DiodeDrop/MiniMu/MiniMu_V1.2_(NextPCB)/Mini Mu V1.2 BOM.xlsx

Reference | Value | Footprint | Qty | DNP | LCSC Part | MPN
C2,C3,C4,C10,C67,C68,C69,C70,C71,C72,C73,C74,C85,C87,C93,C106,C107,C108,C109,C114,C115,C116,C117,C118,C119,C126,C127,C131 | 100n/16V | Capacitor_SMD:C_0402_1005Metric | 28 |  | C76698 | CGA2B1X7R1C104KT0Y0F
C5,C7,C8,C9,C84,C98,C99,C120,C121,C122,C123,C124,C128,C129,C130 | 10u/10V | Capacitor_SMD:C_0402_1005Metric | 15 |  | C5252392 | V106M0402X5R100NCT
C6,C83,C89,C125 | 1u/10V | Capacitor_SMD:C_0402_1005Metric | 4 |  | C7503520 | CGA0402X5R105K100GT
C12,C15,C18,C21,C32,C47,C138 | 10u/50V | Capacitor_SMD:C_0805_2012Metric | 7 |  | C440198 | GRM21BR61H106KE43L
C16,C17,C25,C26,C36,C37 | 100u/10V | Capacitor_Tantalum_SMD:CP_EIA-3216-18_Kemet-A | 6 |  | C313517 | TLJA107M010R1400
C64 | 4u7/25V | Capacitor_SMD:C_0603_1608Metric | 1 |  | C20539423 | TCC0603X5R475M250CT
C79,C80,C81,C82,C94,C95,C97 | 2u2/10V | Capacitor_SMD:C_0402_1005Metric | 7 |  | C6119769 | CGA0402X5R225K100GT
C90,C91 | 18p/50V | Capacitor_SMD:C_0402_1005Metric | 2 |  | C5137554 | FCC0402N180J500AT
C104 | 22u/10V | Capacitor_SMD:C_0402_1005Metric | 1 |  | C22367823 | HGC0402R5226M100NTEJ
C110,C111,C112,C113 | 22u/35V | Capacitor_SMD:C_0805_2012Metric | 4 |  | C22367832 | HGC0805R5226M350NSLJ
D3,D6 | SS1045 | Diode_SMD:D_SMB | 2 |  | C19273147 | SS1045
D4,D5,D7 | XL-3216SURC | LED_SMD:LED_1206_3216Metric | 3 |  | C965822 | XL-3216SURC
D9,D10,D11,D13,D14,D16,D17,D18,D19,D20,D21 | PESD5V0S1BB-ES | Diode_SMD:D_SOD-523 | 11 |  | C5199184 | PESD5V0S1BB-ES
D12,D15,D22 | 1N5819WS | Diode_SMD:D_SOD-323 | 3 |  | C2939001 | 1N5819WS
FB1,FB2,FB3 | 30R | Inductor_SMD:L_0603_1608Metric | 3 |  | C17305 | BLM18PG300SN1D
J3 | USB-303WSD-BRY | easyeda2kicad:USB-A-TH_XUNPU_USB-303WSD-BRY | 1 |  | C2895028 | USB-303WSD-BRY
J4 | JXD0-0101NL | easyeda2kicad:RJ45-TH_JXD0-0101NL | 1 |  | N/A | JXD0-0101NL
J8 | PJ-3043-G | easyeda2kicad:AUDIO-TH_XKB_PJ-3043-R | 1 |  | C2884996 | PJ-3043-G
J9 | PJ-3043-R | easyeda2kicad:AUDIO-TH_XKB_PJ-3043-R | 1 |  | C2884997 | PJ-3043-R
L1,L4 | FXL0630-3R3-M | Inductor_SMD:L_Changjiang_FXL0630 | 2 |  | C167219 | FXL0630-3R3-M
L2 | 470nH | Inductor_SMD:L_0603_1608Metric | 1 |  | C695609 | TFM160808ALC-R47MTAA
MP1,MP2 | SMTSO2025CTJ | MountingHole:MountingHole_3.7mm_Pad_TopOnly | 2 |  | C2916321 | SMTSO2025CTJ
MP3,MP7 | SMTSO2015CTJ | MountingHole:MountingHole_3.7mm_Pad_TopOnly | 2 |  | C2916320 | SMTSO2015CTJ
R10 | 39K2 | Resistor_SMD:R_0603_1608Metric | 1 |  | C23037 | 0603WAF3922T5E
SW2 | TPB01-107L1S-RF | easyeda2kicad:SW-TH_L13.4-W7.7_TPB01-107L1S-RF | 1 |  | C2762119 | TPB01-107L1S-RF
U1 | ALC269Q-VB6-CG | Package_DFN_QFN:QFN-48-1EP_6x6mm_P0.4mm_EP4.2x4.2mm | 1 |  | N/A | ALC269Q-VB6-CG
U3,U6 | TPS54560BDDA | Package_SO:Texas_R-PDSO-G8_EP2.95x4.9mm_Mask2.4x3.1mm | 2 |  | C1850354 | TPS54560BDDA
U4,U5,U13,U14,U15,U18,U19,U20,U22,U23,U24,U25 | RCLAMP0524P | easyeda2kicad:RCLAMP0524P | 12 |  | C19829566 | RCLAMP0524P
U9 | AP2172AMP | Package_SO:MSOP-8-1EP_3x3mm_P0.65mm_EP1.95x2.15mm | 1 |  | C460656 | AP2172AMP
U11,U12,U21 | AP2152AMP | Package_SO:MSOP-8-1EP_3x3mm_P0.65mm_EP1.95x2.15mm | 3 |  | C2150126 | AP2152AMP
U16 | RTL8125BG-CG | Package_DFN_QFN:QFN-48-1EP_6x6mm_P0.4mm_EP4.3x4.3mm | 1 |  | C3013605 | RTL8125BG-CG
U17 | TPS628301ADRL | Package_TO_SOT_SMD:SOT-583-8 | 1 |  | C22445517 | TPS628301ADRL
U26 | MAX16052AUT+T | Package_TO_SOT_SMD:TSOT-23-6 | 1 |  | C143366 | MAX16052AUT+T
X1 | ADDR0207-P001A | easyeda2kicad:DIMM-SMD_ADDR0205-P001A | 1 |  | C962120 | ADDR0205-P001A
X2 | AS0BC21-S30BM-7H | easyeda2kicad:CONN-SMD_AS0BC21-S30BM-7H | 1 |  | C2832351 | AS0BC21-S30BM-7H
X3 | AS0BC21-S30BE-7H | easyeda2kicad:CONN-SMD_AS0BC21-S30BE-7H | 1 |  | C3020019 | AS0BC21-S30BE-7H
X4 | Conn_02x06_Odd_Even | Connector_PinHeader_2.54mm:PinHeader_2x06_P2.54mm_Vertical_SMD | 1 |  | C32713286 | HX PZ2.54-2x6P TP
X6 | Conn_02x06_Odd_Even | Connector_PinSocket_2.54mm:PinSocket_2x06_P2.54mm_Vertical_SMD | 1 |  | C22373947 | HC-PM254-8.5H-2x6PS
BT1 | CR1220-2 | easyeda2kicad:BAT-SMD_CR1220-2 | 1 |  | C70381 | CR1220-2
C1,C11,C13,C14,C22,C27,C28,C29,C30,C33,C40,C41,C44,C45,C50,C52,C54,C75,C102,C103,C134,C136,C139,C144,C145,C146,C147,C148 | 100n/50V | Capacitor_SMD:C_0603_1608Metric | 28 |  | C282519 | TCC0603X7R104K500CT
C19 | 910p/50V | Capacitor_SMD:C_0603_1608Metric | 1 |  | C3037659 | 0603CG911J500NT
C20 | 2n2/50V | Capacitor_SMD:C_0603_1608Metric | 1 |  | C779970 | 06035C222K4T2A
C23,C24 | 16p/50V | Capacitor_SMD:C_0603_1608Metric | 2 |  | C5360788 | TCC0603COG160J500CT
C31,C34,C35,C38,C39,C42,C43,C46 | 47u/10V | Capacitor_SMD:C_1206_3216Metric | 8 |  | C5448950 | TCC1206X5R476M100HT
C48,C65,C76,C105,C137 | 1u/50V | Capacitor_SMD:C_0603_1608Metric | 5 |  | C157684 | 0603X105K500NT
C49,C63,C100,C101,C132,C142,C143 | 10u/10V | Capacitor_SMD:C_0603_1608Metric | 7 |  | C19702 | CL10A106KP8NNNC
C51,C53,C55,C56,C57,C58,C59,C60,C61,C62,C77,C78,C86,C88,C92,C96,C140,C141 | 220n/16V | Capacitor_SMD:C_0402_1005Metric | 18 |  | C152777 | 0402X224K160CT
C66 | 27p/50V | Capacitor_SMD:C_0603_1608Metric | 1 |  | C302064 | 0603N270J500CT
C135 | 27n/50V | Capacitor_SMD:C_0603_1608Metric | 1 |  | C107086 | CC0603KRX7R9BB273
D1 | ESDA25L | Package_TO_SOT_SMD:SOT-23-3 | 1 |  | C95343 | ESDA25L
D2 | SD24 | easyeda2kicad:SOD-323_L1.8-W1.3-LS2.6-FD | 1 |  | C502530 | SD24
F1 | 0603L005/6AR | Fuse:Fuse_0603_1608Metric | 1 |  | C7472508 | 0603L005/6AR
J1 | HYC16-DP20-178 | easyeda2kicad:DP-SMD_HYC16-DP20-178 | 1 |  | C711350 | HYC16-DP20-178
J2 | HDMI-001S | easyeda2kicad:HDMI-SMD_HDMI-001S | 1 |  | C720616 | HDMI-001S
J5,J6 | AF SS-JB17.6 | easyeda2kicad:USB-A-TH_AF-SS-JB17.6 | 2 |  | C456021 | AF SS-JB17.6
J7 | GT-USB-7010ASV | Connector_USB:USB_C_Receptacle_G-Switch_GT-USB-7010ASV | 1 |  | C2988369 | GT-USB-7010ASV
J10 | Conn_01x03 | Connector_PinHeader_2.00mm:PinHeader_1x03_P2.00mm_Vertical | 1 |  | C706996 | X4611WV-03I-C40D28
Q1,Q8,Q13 | AO3400A | Package_TO_SOT_SMD:SOT-23 | 3 |  | C5380685 | AO3400A
Q2 | IRF7240TRPBF | Package_SO:SOIC-8_3.9x4.9mm_P1.27mm | 1 |  | C18190856 | IRF7240TRPBF
Q3 | TMG60N04NF | easyeda2kicad:PDFN-8_L5.8-W4.9-P1.27-LS6.1-BL-A | 1 |  | C7422899 | TMG60N04NF
Q4,Q5,Q6,Q7 | SI1902CDL | Package_TO_SOT_SMD:SOT-363_SC-70-6 | 4 |  | C466988 | SI1902CDL
R1,R23,R26,R31,R32,R39,R40,R49,R80,R81,R94 | 100K | Resistor_SMD:R_0603_1608Metric | 11 |  | C25803 | 0603WAF1003T5E
R2,R4,R5,R35,R41,R46,R47,R48,R50,R82 | 10K | Resistor_SMD:R_0603_1608Metric | 10 |  | C25804 | 0603WAF1002T5E
R3 | 22R | Resistor_SMD:R_0603_1608Metric | 1 |  | C23345 | 0603WAF220JT5E
R11,R44,R65 | 20K | Resistor_SMD:R_0603_1608Metric | 3 |  | C4184 | 0603WAF2002T5E
R12,R18,R20,R64,R72,R95 | 1Meg | Resistor_SMD:R_0603_1608Metric | 6 |  | C22935 | 0603WAF1004T5E
R13,R27 | 47K | Resistor_SMD:R_0603_1608Metric | 2 |  | C25819 | 0603WAF4702T5E
R14,R38 | 5K1 | Resistor_SMD:R_0603_1608Metric | 2 |  | C23186 | 0603WAF5101T5E
R15 | 24K | Resistor_SMD:R_0603_1608Metric | 1 |  | C23352 | 0603WAF2402T5E
R16,R28,R89 | 15K | Resistor_SMD:R_0603_1608Metric | 3 |  | C22809 | 0603WAF1502T5E
R17,R36,R84 | 100R | Resistor_SMD:R_0603_1608Metric | 3 |  | C22775 | 0603WAF1000T5E
R19,R22,R75,R77,R78,R79 | 0R | Resistor_SMD:R_0603_1608Metric | 6 |  | C21189 | 0603WAF0000T5E
R21,R24,R25 | 100K | Resistor_SMD:R_0402_1005Metric | 3 |  | C25741 | 0402WGF1003TCE
R29 | 180K | Resistor_SMD:R_0603_1608Metric | 1 |  | C22827 | 0603WAF2003T5E
R30 | 200K | Resistor_SMD:R_0603_1608Metric | 1 |  | C25811 | 0603WAF2003T5E
R33 | 68K | Resistor_SMD:R_0603_1608Metric | 1 |  | C23231 | 0603WAF6802T5E
R34 | 13K | Resistor_SMD:R_0603_1608Metric | 1 |  | C22797 | 0603WAF1302T5E
R37,R66,R73,R90,R91 | 1K | Resistor_SMD:R_0603_1608Metric | 5 |  | C21190 | 0603WAF1001T5E
R42,R52,R108,R117 | 130R | Resistor_SMD:R_0603_1608Metric | 4 |  | C22796 | 0603WAF1300T5E
R45,R51 | 75R | Resistor_SMD:R_0603_1608Metric | 2 |  | C4275 | 0603WAF750JT5E
R53,R60,R63,R67,R68,R86,R92,R93 | 2K2 | Resistor_SMD:R_0603_1608Metric | 8 |  | C4190 | 0603WAF2201T5E
R54,R55,R56,R57,R58,R59,R61,R62 | 470R | Resistor_SMD:R_0402_1005Metric | 8 |  | C25117 | 0402WGF4700TCE
R69,R70 | 330R | Resistor_SMD:R_0603_1608Metric | 2 |  | C23138 | 0603WAF3300T5E
R71 | 2K49 | Resistor_SMD:R_0603_1608Metric | 1 |  | C22908 | 0603WAF2491T5E
R74,R76,R85,R87 | 4K7 | Resistor_SMD:R_0603_1608Metric | 4 |  | C23162 | 0603WAF4701T5E
R83 | 27K | Resistor_SMD:R_0603_1608Metric | 1 |  | C22967 | 0603WAF2702T5E
R88 | 4K3 | Resistor_SMD:R_0603_1608Metric | 1 |  | C23159 | 0603WAF4301T5E
TH1 | FNTC0603X103F3950FB | Resistor_SMD:R_0603_1608Metric | 1 |  | C41417298 | FNTC0603X103F3950FB
U7 | HT7533 | Package_TO_SOT_SMD:SOT-89-3 | 1 |  | C5296738 | HT7533
U8 | PIC16F18313-I/SN | Package_SO:SOIC-8_3.9x4.9mm_P1.27mm | 1 |  | C510911 | PIC16F18313-I/SN
U10 | 74AHC1G14GW | Package_TO_SOT_SMD:SOT-353_SC-70-5 | 1 |  | C19829643 | 74AHC1G14GW
U27 | IP2721 | Package_SO:TSSOP-16_4.4x5mm_P0.65mm | 1 |  | C603176 | IP2721
X5 | B4B-PH-K-S | Connector_JST:JST_PH_B4B-PH-K_1x04_P2.00mm_Vertical | 1 |  | C131334 | B4B-PH-K-S
Y1 | SX3B25.000F1010G30 | Crystal:Crystal_SMD_3225-4Pin_3.2x2.5mm | 1 |  | C7302033 | SX3B25.000F1010G30
Y2 | SX3M1.000M20F30TNN | Oscillator:Oscillator_SMD_EuroQuartz_XO32-4Pin_3.2x2.5mm | 1 |  | C2901547 | SX3M1.000M20F30TNN
