DiodeDrop/MiniMu/DrillTemplate/Drill Template PCB.pdf

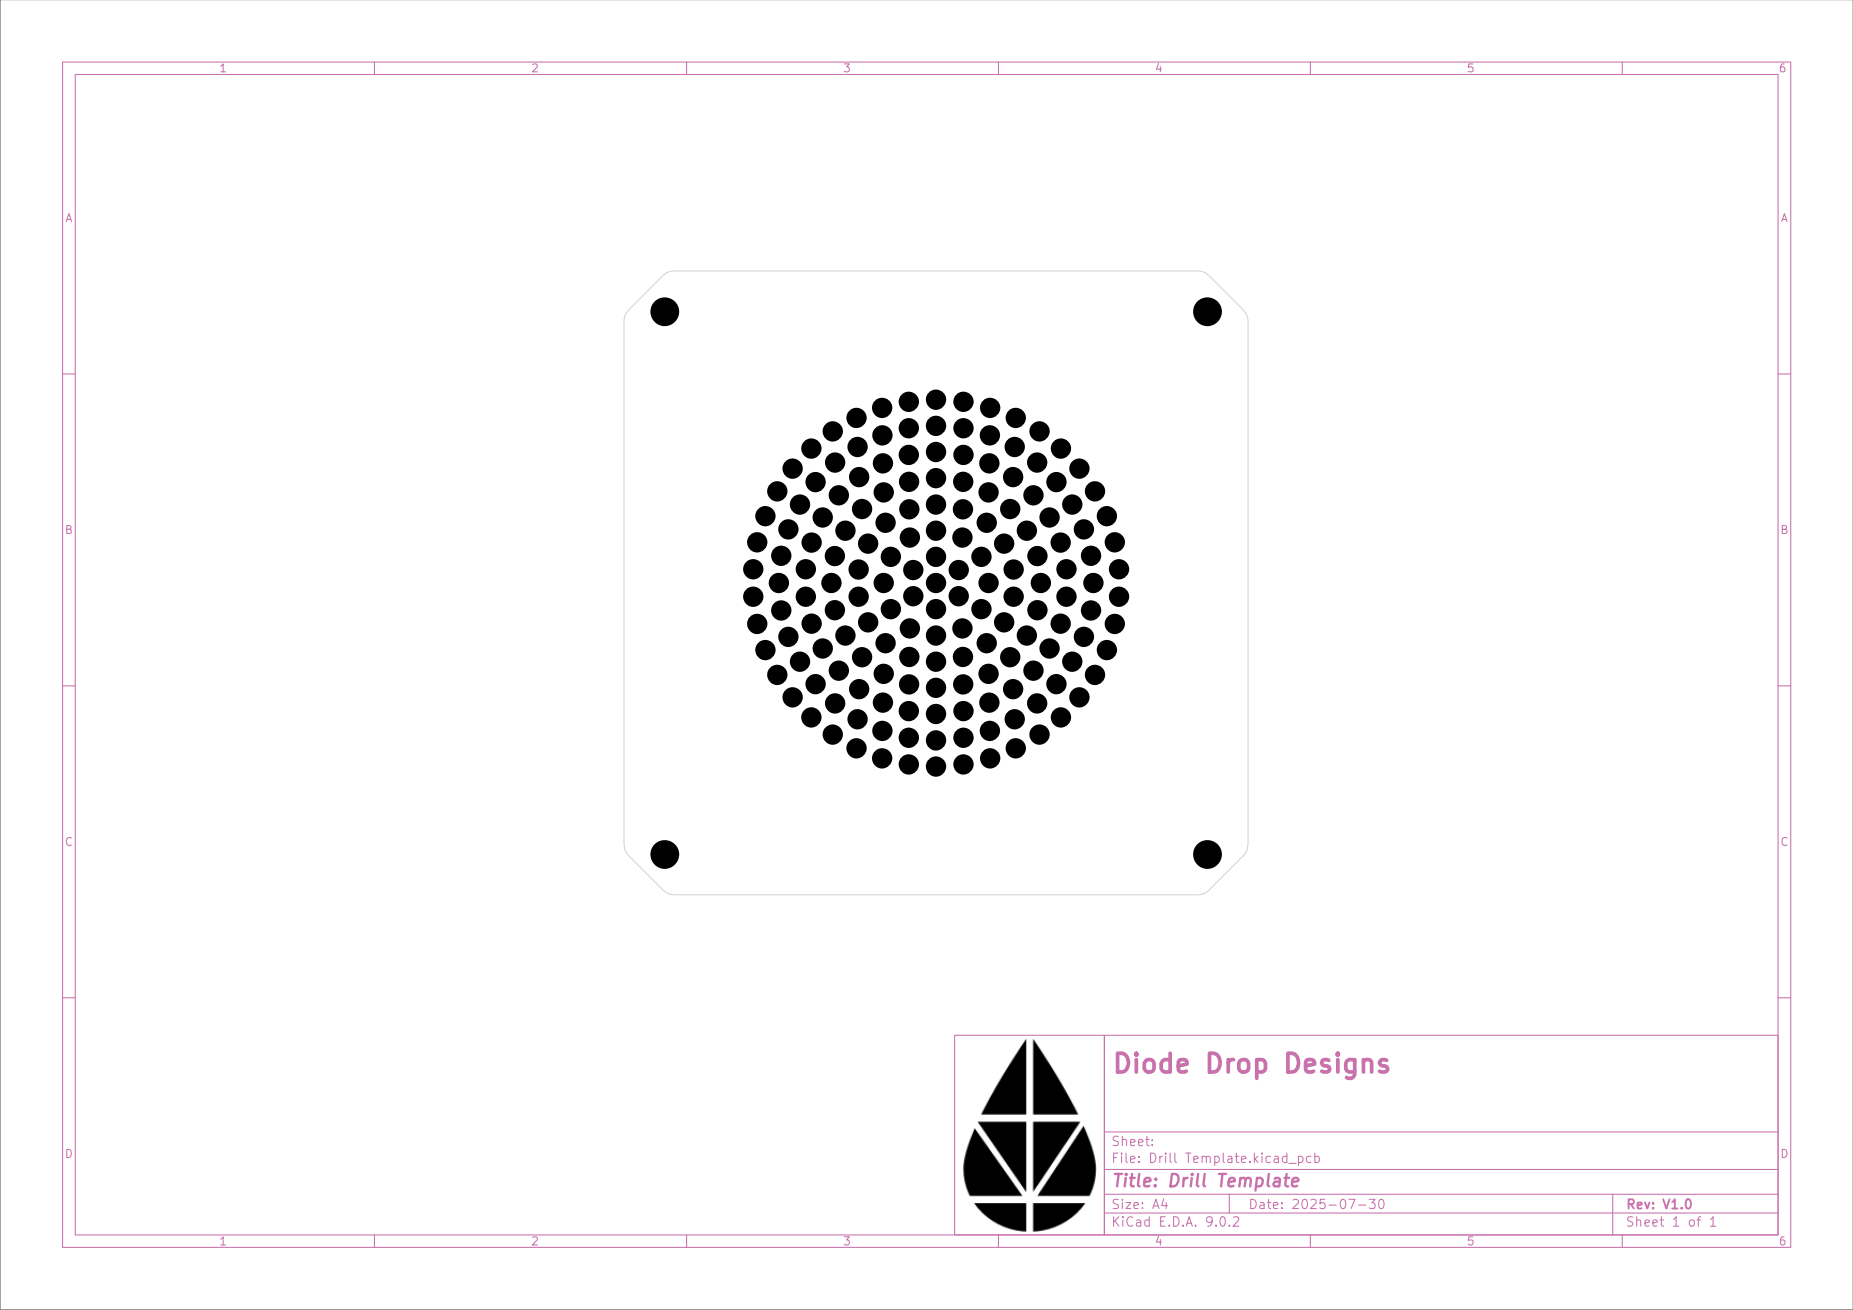
[picture p22: page 1]
