DiodeDrop/MiniMu/MiniMu_V1.2_(NextPCB)/Buttons.kicad_sch

## KiCad design MiniMu_V1.2_(NextPCB)/Buttons.kicad_sch (2025-07-30)

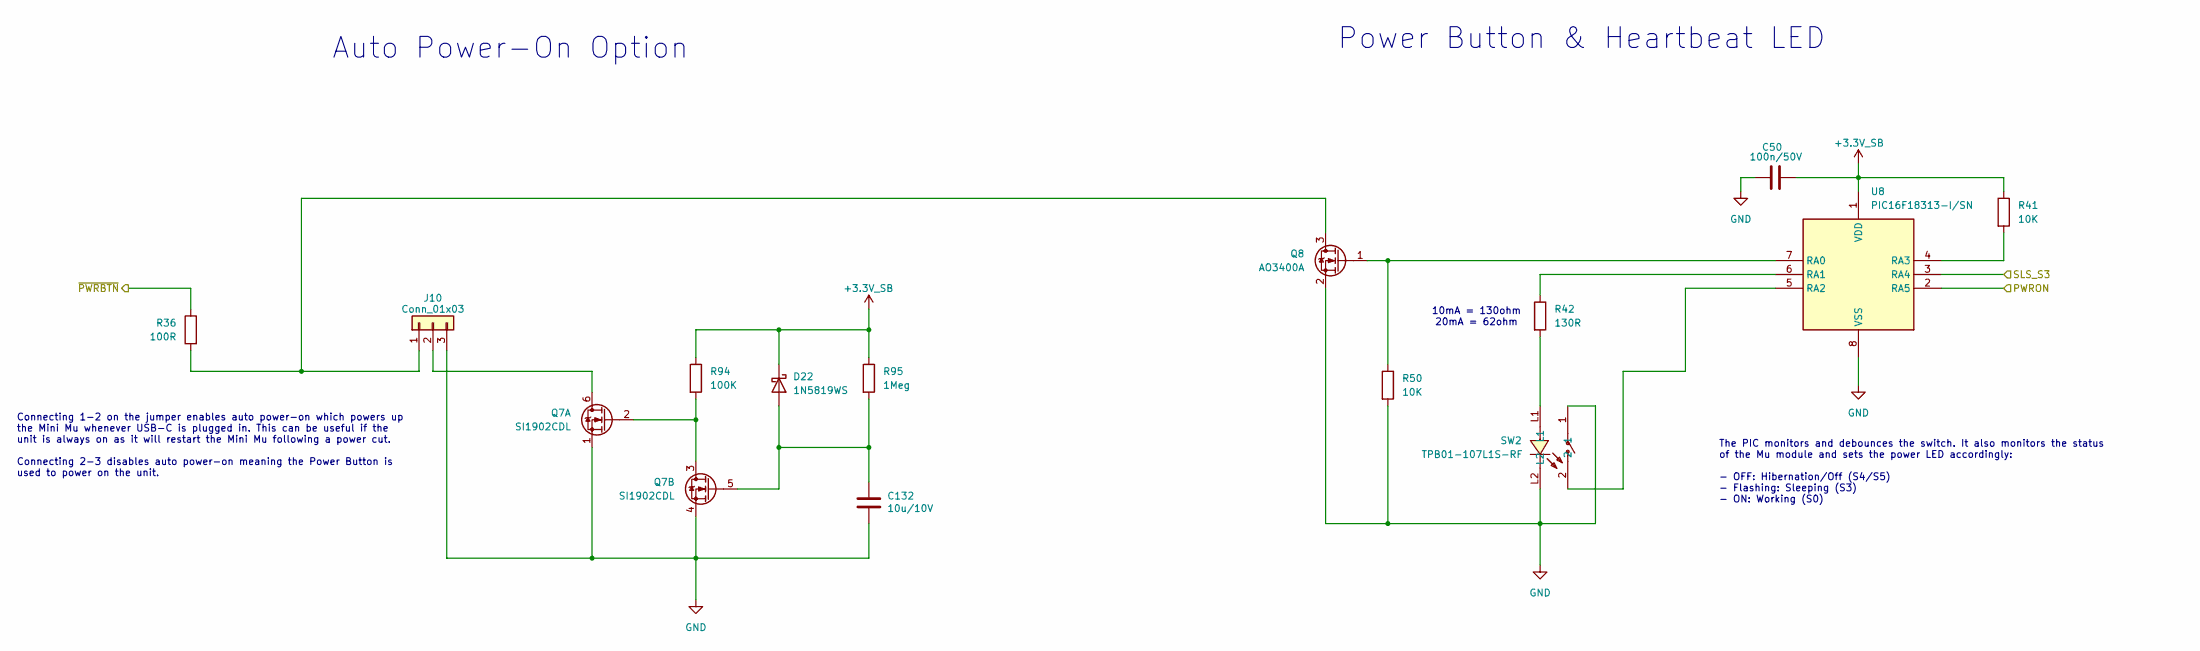
[picture p23: schematic Buttons.kicad_sch]

Parts:
C50: 100n/50V; C_0603_1608Metric; LCSC Part C282519
C132: 10u/10V; C_0603_1608Metric; LCSC Part C19702
D22: 1N5819WS; D_SOD-323; MPN 1N5819WS; LCSC Part C2939001
J10: Conn_01x03; PinHeader_1x03_P2.00mm_Vertical; MPN X4611WV-03I-C40D28; LCSC Part C706996
Q7: SI1902CDL; SOT-363_SC-70-6; MPN SI1902CDL; LCSC Part C466988
Q8: AO3400A; SOT-23; MPN AO3400A; LCSC Part C5380685
R36: 100R; R_0603_1608Metric; MPN 0603WAF1000T5E; LCSC Part C22775
R41, R50: 10K; R_0603_1608Metric; MPN 0603WAF1002T5E; LCSC Part C25804
R42: 130R; R_0603_1608Metric; MPN 0603WAF1300T5E; LCSC Part C22796
R94: 100K; R_0603_1608Metric; MPN 0603WAF1003T5E; LCSC Part C25803
R95: 1Meg; R_0603_1608Metric; MPN 0603WAF1004T5E; LCSC Part C22935
SW2: TPB01-107L1S-RF; SW-TH_L13.4-W7.7_TPB01-107L1S-RF; MPN TPB01-107L1S-RF; LCSC Part C2762119
U8: PIC16F18313-I/SN; SOIC-8_3.9x4.9mm_P1.27mm; MPN PIC16F18313-I/SN; LCSC Part C510911

Connections:
+3.3V_SB: C50.1, D22.1 (K), R41.1, R94.1, R95.1, U8.1 (VDD)
GND: C50.2, C132.2, J10.3, Q7.1 (S), Q7.4 (S), Q8.2 (S), R50.2, SW2.1, SW2.L2, U8.8 (VSS)
unnamed: C132.1, D22.2 (A), Q7.5 (G), R95.2
unnamed: J10.1, Q8.3 (D), R36.2
unnamed: J10.2, Q7.6 (D)
unnamed: Q7.2 (G), Q7.3 (D), R94.2
unnamed: Q8.1 (G), R50.1, U8.7 (RA0)
unnamed: R41.2, U8.4 (RA3)
unnamed: R42.1, U8.6 (RA1)
unnamed: R42.2, SW2.L1
unnamed: SW2.2, U8.5 (RA2)
PWRON: U8.2 (RA5)
SLS_S3: U8.3 (RA4)
~PWRBTN: R36.1

Notes on the sheet:
Power Button & Heartbeat LED
10mA = 130ohm 20mA = 62ohm
Auto Power-On Option
Connecting 1-2 on the jumper enables auto power-on which powers up the Mini Mu whenever USB-C is plugged in. This can be useful if the unit is always on as it will restart the Mini Mu following a power cut. Connecting 2-3 disables auto power-on meaning the Power Button is used to power on the unit.
The PIC monitors and debounces the switch. It also monitors the status of the Mu module and sets the power LED accordingly: - OFF: Hibernation/Off (S4/S5) - Flashing: Sleeping (S3) - ON: Working (S0)
