DiodeDrop/MiniMu/MiniMu_V1.2_(NextPCB)/Displayport.kicad_sch

## KiCad design MiniMu_V1.2_(NextPCB)/Displayport.kicad_sch (2025-07-30)

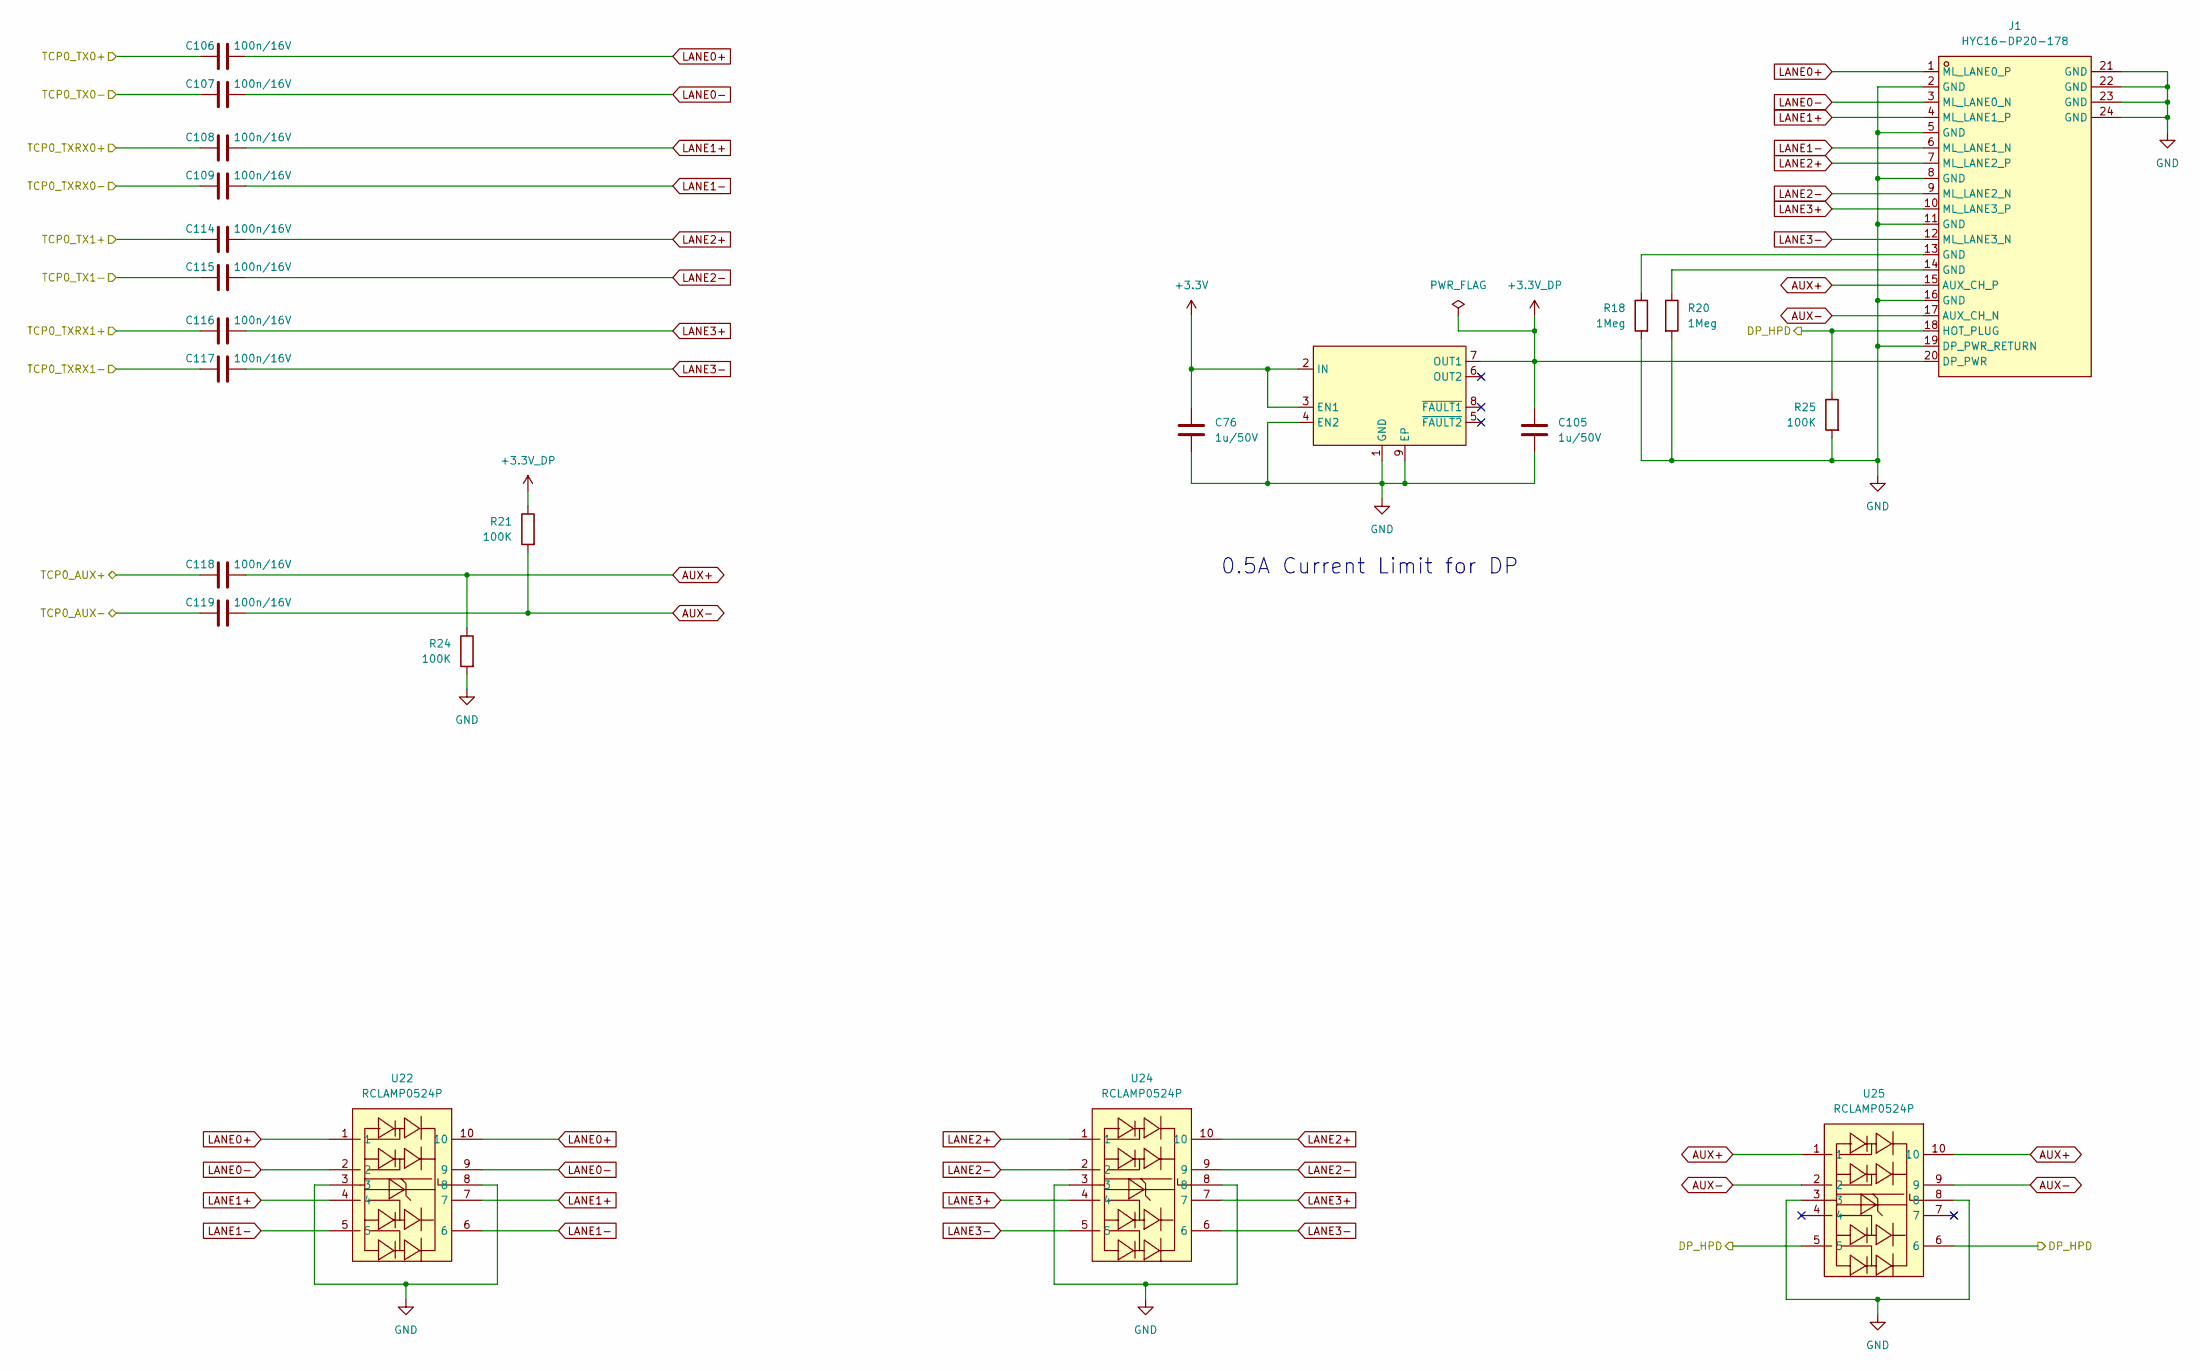
[picture p24: schematic Displayport.kicad_sch]

Parts:
C76, C105: 1u/50V; C_0603_1608Metric; LCSC Part C157684
C106, C107, C108, C109, C114, C115, C116, C117, C118, C119: 100n/16V; C_0402_1005Metric; LCSC Part C76698
J1: HYC16-DP20-178; DP-SMD_HYC16-DP20-178; MPN HYC16-DP20-178; LCSC Part C711350
R18, R20: 1Meg; R_0603_1608Metric; MPN 0603WAF1004T5E; LCSC Part C22935
R21, R24, R25: 100K; R_0402_1005Metric; MPN 0402WGF1003TCE; LCSC Part C25741
U21: AP2152AMP; MSOP-8-1EP_3x3mm_P0.65mm_EP1.95x2.15mm; MPN AP2152AMP; LCSC Part C2150126
U22, U24, U25: RCLAMP0524P; MPN RCLAMP0524P; LCSC Part C19829566

Connections:
+3.3V: C76.1, U21.2 (IN), U21.3 (EN1)
+3.3V_DP: C105.1, J1.20 (DP_PWR), R21.1, U21.7 (OUT1)
AUX+: C118.2, J1.15 (AUX_CH_P), R24.1, U25.1, U25.10
AUX-: C119.2, J1.17 (AUX_CH_N), R21.2, U25.2, U25.9
DP_HPD: J1.18 (HOT_PLUG), R25.1, U25.5, U25.6
GND: C76.2, C105.2, J1.2 (GND), J1.5 (GND), J1.8 (GND), J1.11 (GND), J1.16 (GND), J1.19 (DP_PWR_RETURN), J1.21 (GND), J1.22 (GND), J1.23 (GND), J1.24 (GND), R18.2, R20.2, R24.2, R25.2, U21.1 (GND), U21.4 (EN2), U21.9 (EP), U22.3, U22.8, U24.3, U24.8, U25.3, U25.8
LANE0+: C106.2, J1.1 (ML_LANE0_P), U22.1, U22.10
LANE0-: C107.2, J1.3 (ML_LANE0_N), U22.2, U22.9
LANE1+: C108.2, J1.4 (ML_LANE1_P), U22.4, U22.7
LANE1-: C109.2, J1.6 (ML_LANE1_N), U22.5, U22.6
LANE2+: C114.2, J1.7 (ML_LANE2_P), U24.1, U24.10
LANE2-: C115.2, J1.9 (ML_LANE2_N), U24.2, U24.9
LANE3+: C116.2, J1.10 (ML_LANE3_P), U24.4, U24.7
LANE3-: C117.2, J1.12 (ML_LANE3_N), U24.5, U24.6
unnamed: J1.13 (GND), R18.1
unnamed: J1.14 (GND), R20.1
TCP0_AUX+: C118.1
TCP0_AUX-: C119.1
TCP0_TX0+: C106.1
TCP0_TX0-: C107.1
TCP0_TX1+: C114.1
TCP0_TX1-: C115.1
TCP0_TXRX0+: C108.1
TCP0_TXRX0-: C109.1
TCP0_TXRX1+: C116.1
TCP0_TXRX1-: C117.1

Notes on the sheet:
0.5A Current Limit for DP
