DiodeDrop/MiniMu/MiniMu_V1.2_(NextPCB)/Ethernet.kicad_sch

## KiCad design MiniMu_V1.2_(NextPCB)/Ethernet.kicad_sch (2025-07-30)

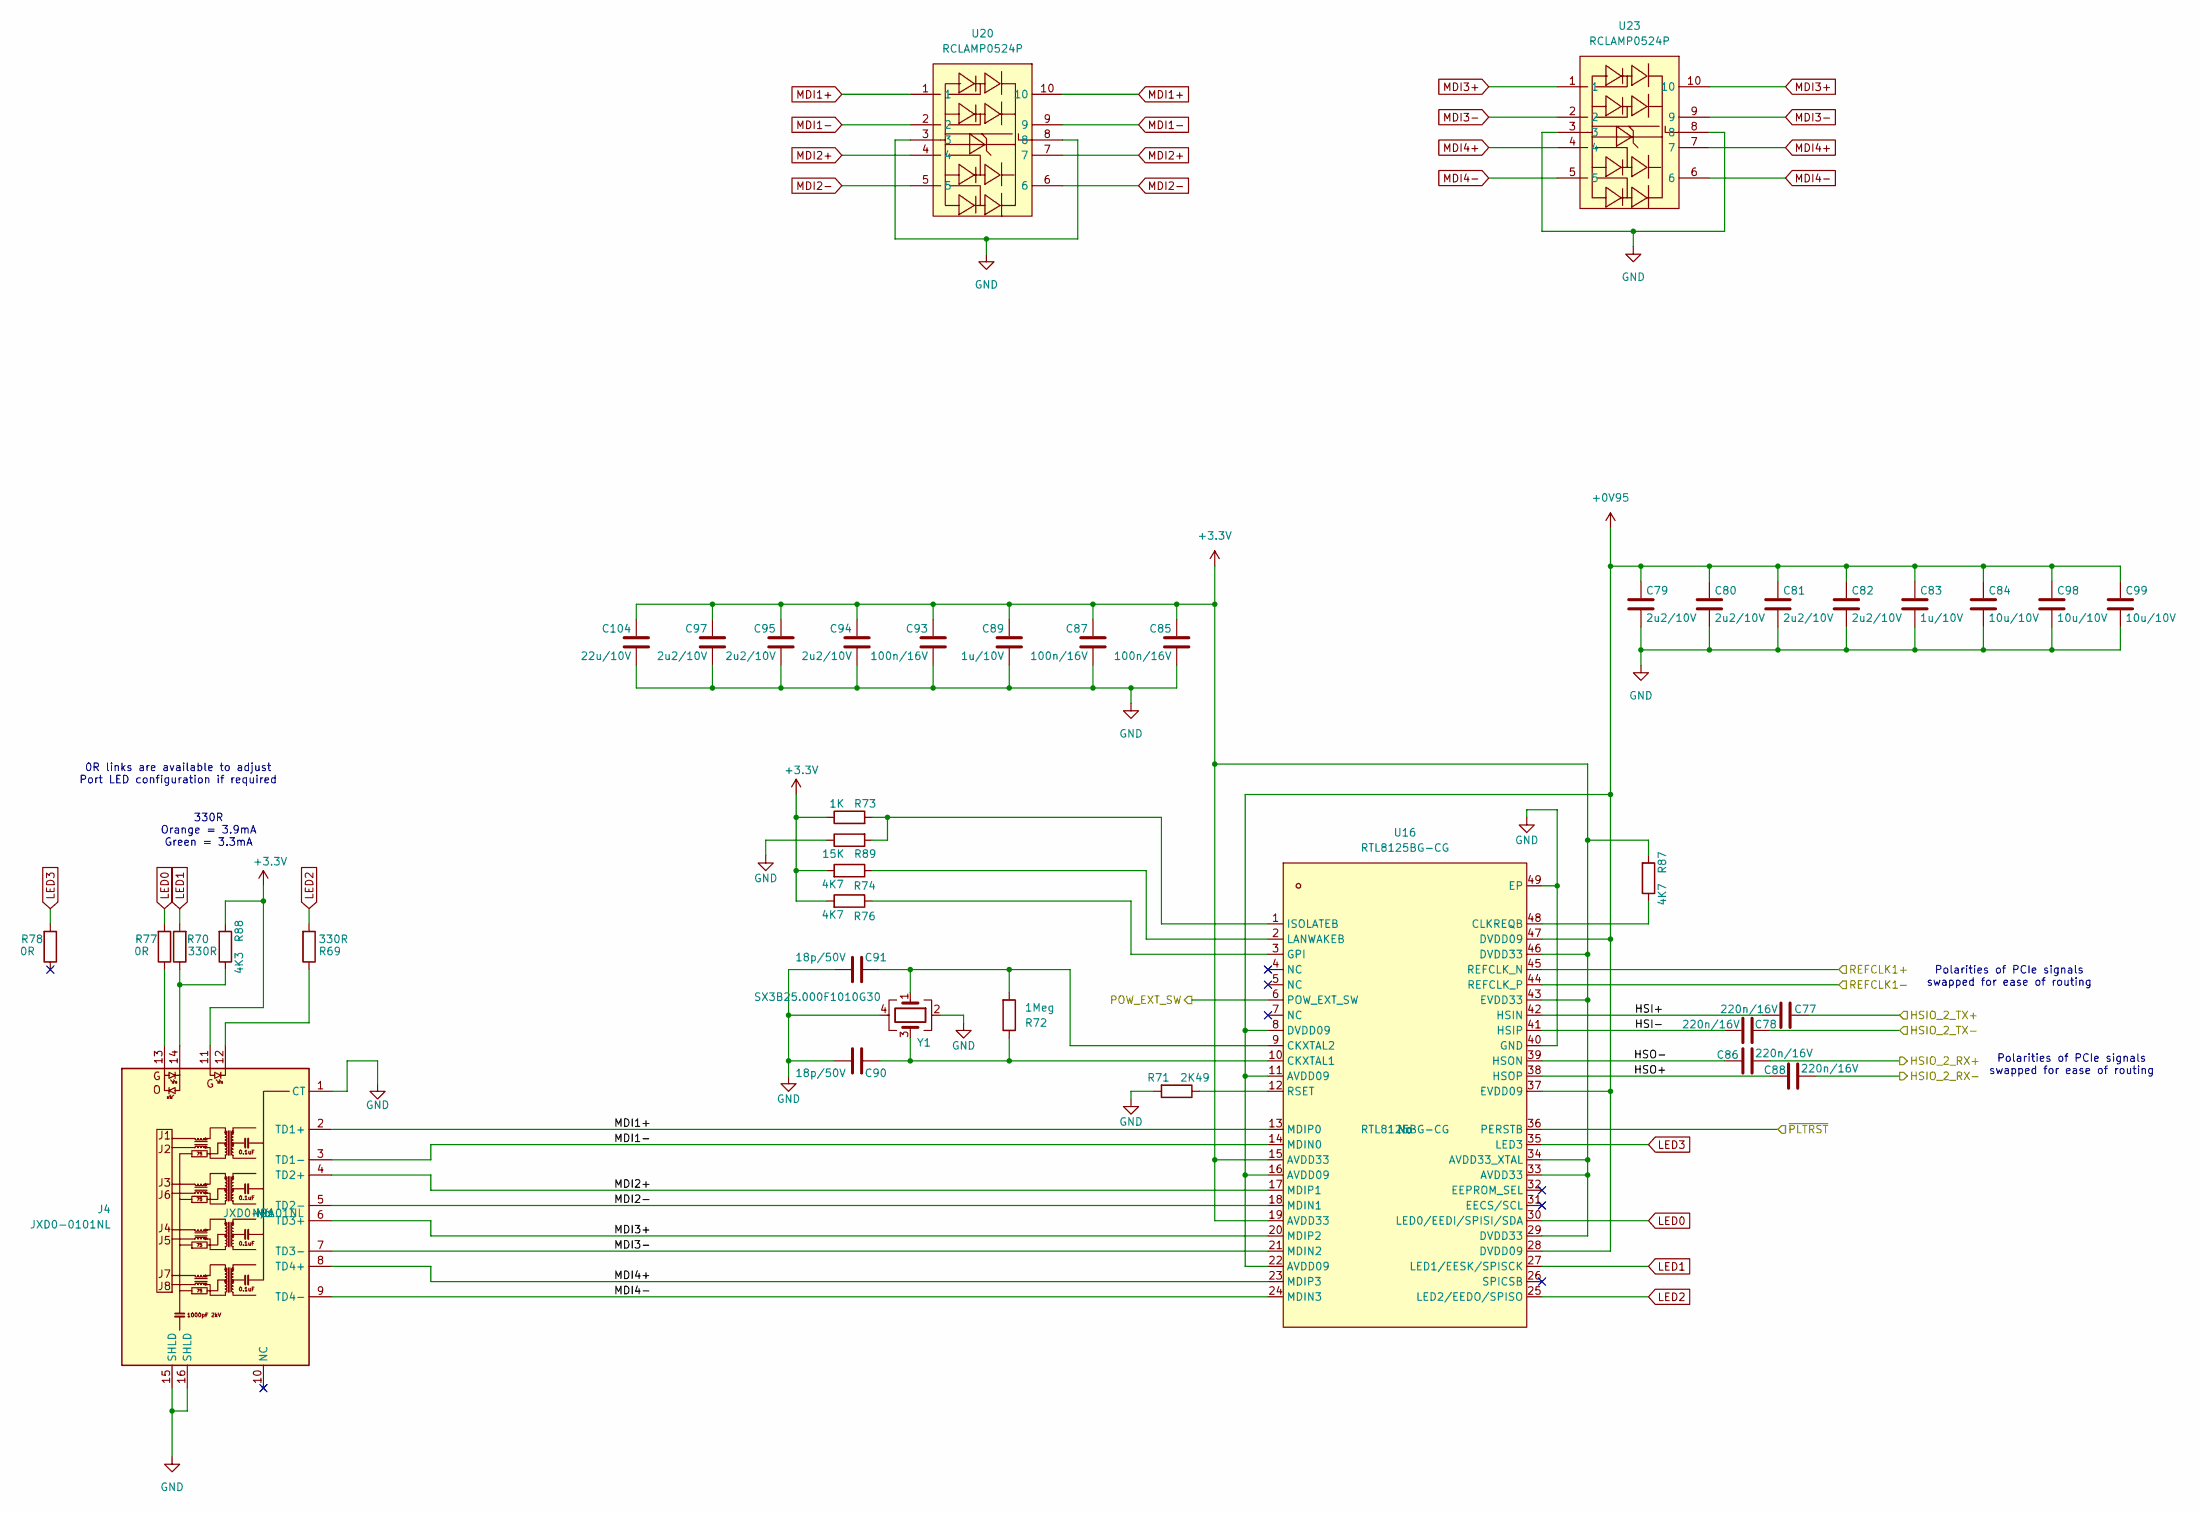
[picture p25: schematic Ethernet.kicad_sch]

Parts:
C77, C78, C86, C88: 220n/16V; C_0402_1005Metric; LCSC Part C152777
C79, C80, C81, C82, C94, C95, C97: 2u2/10V; C_0402_1005Metric; LCSC Part C6119769
C83, C89: 1u/10V; C_0402_1005Metric; LCSC Part C7503520
C84, C98, C99: 10u/10V; C_0402_1005Metric; LCSC Part C5252392
C85, C87, C93: 100n/16V; C_0402_1005Metric; LCSC Part C76698
C90, C91: 18p/50V; C_0402_1005Metric; LCSC Part C5137554
C104: 22u/10V; C_0402_1005Metric; LCSC Part C22367823
J4: JXD0-0101NL; RJ45-TH_JXD0-0101NL; MPN JXD0-0101NL; LCSC Part N/A
R69, R70: 330R; R_0603_1608Metric; MPN 0603WAF3300T5E; LCSC Part C23138
R71: 2K49; R_0603_1608Metric; MPN 0603WAF2491T5E; LCSC Part C22908
R72: 1Meg; R_0603_1608Metric; MPN 0603WAF1004T5E; LCSC Part C22935
R73: 1K; R_0603_1608Metric; MPN 0603WAF1001T5E; LCSC Part C21190
R74, R76, R87: 4K7; R_0603_1608Metric; MPN 0603WAF4701T5E; LCSC Part C23162
R77, R78: 0R; R_0603_1608Metric; MPN 0603WAF0000T5E; LCSC Part C21189
R88: 4K3; R_0603_1608Metric; MPN 0603WAF4301T5E; LCSC Part C23159
R89: 15K; R_0603_1608Metric; MPN 0603WAF1502T5E; LCSC Part C22809
U16: RTL8125BG-CG; QFN-48-1EP_6x6mm_P0.4mm_EP4.3x4.3mm; MPN RTL8125BG-CG; LCSC Part C3013605
U20, U23: RCLAMP0524P; MPN RCLAMP0524P; LCSC Part C19829566
Y1: SX3B25.000F1010G30; Crystal_SMD_3225-4Pin_3.2x2.5mm; MPN SX3B25.000F1010G30; LCSC Part C7302033

Connections:
+0V95: C79.2, C80.2, C81.2, C82.2, C83.2, C84.2, C98.2, C99.2, U16.8 (DVDD09), U16.11 (AVDD09), U16.16 (AVDD09), U16.22 (AVDD09), U16.28 (DVDD09), U16.37 (EVDD09), U16.47 (DVDD09)
+3.3V: C85.2, C87.2, C89.2, C93.2, C94.2, C95.2, C97.2, C104.2, J4.11, R73.1, R74.2, R76.2, R87.2, R88.2, U16.15 (AVDD33), U16.19 (AVDD33), U16.29 (DVDD33), U16.33 (AVDD33), U16.34 (AVDD33_XTAL), U16.43 (EVDD33), U16.46 (DVDD33)
GND: C79.1, C80.1, C81.1, C82.1, C83.1, C84.1, C85.1, C87.1, C89.1, C90.2, C91.2, C93.1, C94.1, C95.1, C97.1, C98.1, C99.1, C104.1, J4.1 (CT), J4.15 (SHLD), J4.16 (SHLD), R71.2, R89.1, U16.40 (GND), U16.49 (EP), U20.3, U20.8, U23.3, U23.8, Y1.2, Y1.4
HSI+: C77.2, U16.42 (HSIN)
HSI-: C78.2, U16.41 (HSIP)
HSIO_2_RX+: C86.2
HSIO_2_RX-: C88.2
HSIO_2_TX+: C77.1
HSIO_2_TX-: C78.1
HSO+: C88.1, U16.38 (HSOP)
HSO-: C86.1, U16.39 (HSON)
LED0: R77.2, U16.30 (LED0/EEDI/SPISI/SDA)
LED1: R70.2, U16.27 (LED1/EESK/SPISCK)
LED2: R69.2, U16.25 (LED2/EEDO/SPISO)
LED3: R78.2, U16.35 (LED3)
MDI1+: J4.2 (TD1+), U16.13 (MDIP0), U20.1, U20.10
MDI1-: J4.3 (TD1-), U16.14 (MDIN0), U20.2, U20.9
MDI2+: J4.4 (TD2+), U16.17 (MDIP1), U20.4, U20.7
MDI2-: J4.5 (TD2-), U16.18 (MDIN1), U20.5, U20.6
MDI3+: J4.6 (TD3+), U16.20 (MDIP2), U23.1, U23.10
MDI3-: J4.7 (TD3-), U16.21 (MDIN2), U23.2, U23.9
MDI4+: J4.8 (TD4+), U16.23 (MDIP3), U23.4, U23.7
MDI4-: J4.9 (TD4-), U16.24 (MDIN3), U23.5, U23.6
unnamed: C90.1, R72.1, U16.10 (CKXTAL1), Y1.3
unnamed: C91.1, R72.2, U16.9 (CKXTAL2), Y1.1
unnamed: J4.12, R69.1
unnamed: J4.13, R77.1
unnamed: J4.14, R70.1, R88.1
unnamed: R71.1, U16.12 (RSET)
unnamed: R73.2, R89.2, U16.1 (ISOLATEB)
unnamed: R74.1, U16.2 (LANWAKEB)
unnamed: R76.1, U16.3 (GPI)
unnamed: R87.1, U16.48 (CLKREQB)
POW_EXT_SW: U16.6 (POW_EXT_SW)
REFCLK1+: U16.45 (REFCLK_N)
REFCLK1-: U16.44 (REFCLK_P)
~PLTRST: U16.36 (PERSTB)

Notes on the sheet:
330R Orange = 3.9mA Green = 3.3mA
Polarities of PCIe signals swapped for ease of routing
0R links are available to adjust Port LED configuration if required
