DiodeDrop/MiniMu/MiniMu_V1.2_(NextPCB)/Fan_Temp.kicad_sch

## KiCad design MiniMu_V1.2_(NextPCB)/Fan_Temp.kicad_sch (2025-07-30)

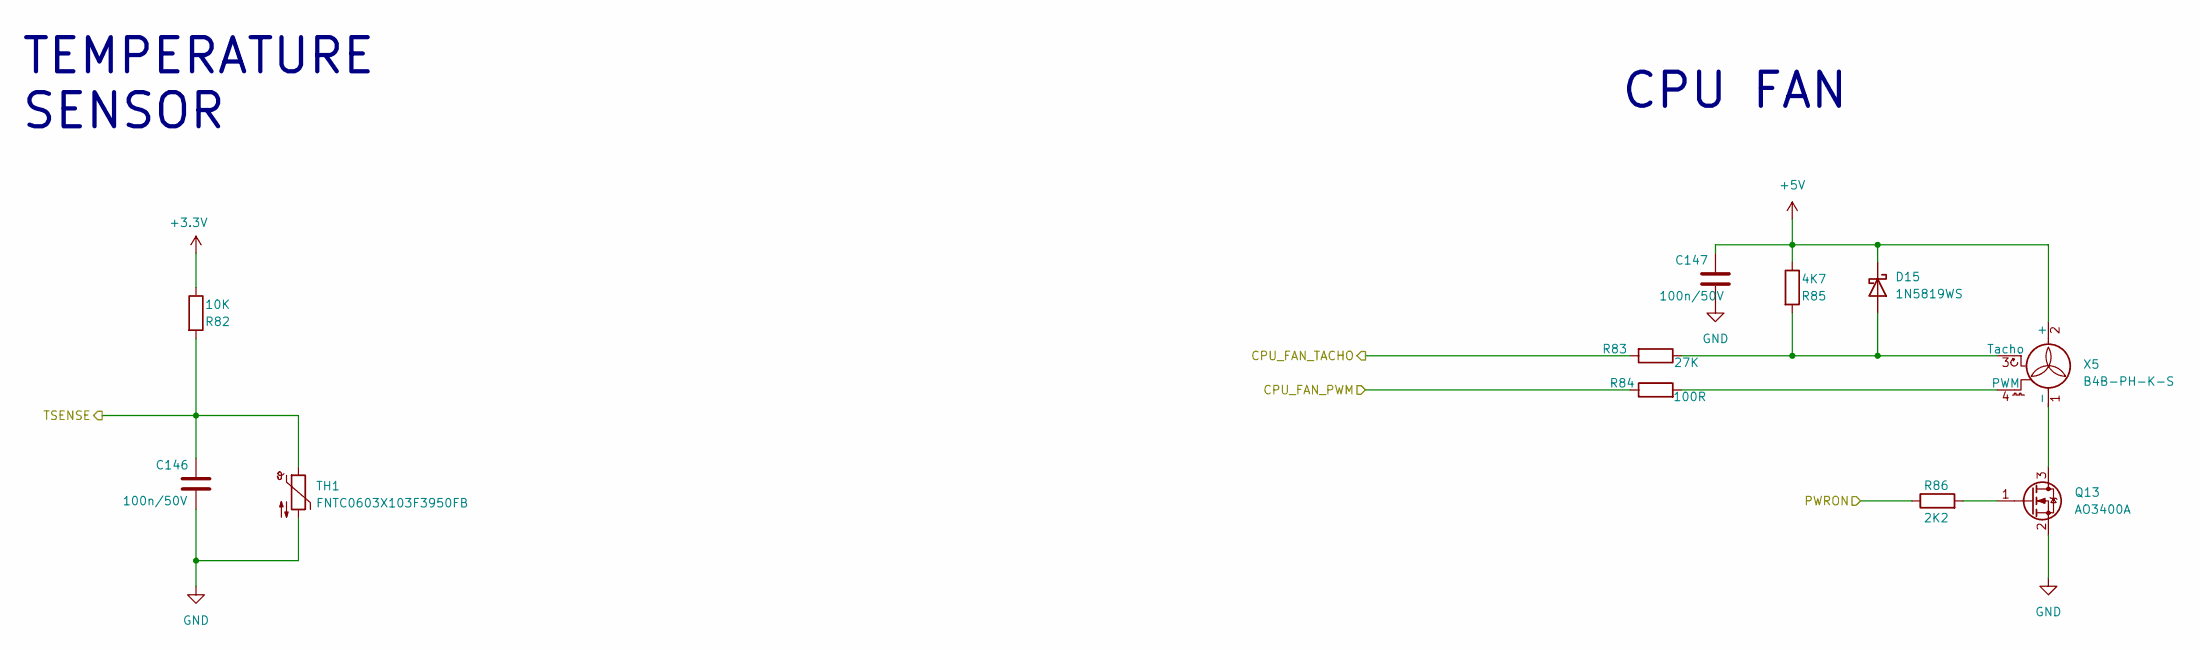
[picture p26: schematic Fan_Temp.kicad_sch]

Parts:
C146, C147: 100n/50V; C_0603_1608Metric; LCSC Part C282519
D15: 1N5819WS; D_SOD-323; MPN 1N5819WS; LCSC Part C2939001
Q13: AO3400A; SOT-23; MPN AO3400A; LCSC Part C5380685
R82: 10K; R_0603_1608Metric; MPN 0603WAF1002T5E; LCSC Part C25804
R83: 27K; R_0603_1608Metric; MPN 0603WAF2702T5E; LCSC Part C22967
R84: 100R; R_0603_1608Metric; MPN 0603WAF1000T5E; LCSC Part C22775
R85: 4K7; R_0603_1608Metric; MPN 0603WAF4701T5E; LCSC Part C23162
R86: 2K2; R_0603_1608Metric; MPN 0603WAF2201T5E; LCSC Part C4190
TH1: FNTC0603X103F3950FB; R_0603_1608Metric; MPN FNTC0603X103F3950FB; LCSC Part C41417298
X5: B4B-PH-K-S; JST_PH_B4B-PH-K_1x04_P2.00mm_Vertical; MPN B4B-PH-K-S; LCSC Part C131334

Connections:
+3.3V: R82.1
+5V: C147.1, D15.1 (K), R85.1, X5.2 (+)
CPU_FAN_PWM: R84.1
CPU_FAN_TACHO: R83.2
GND: C146.2, C147.2, Q13.2 (S), TH1.2
unnamed: D15.2 (A), R83.1, R85.2, X5.3 (Tacho)
unnamed: Q13.1 (G), R86.2
unnamed: Q13.3 (D), X5.1 (-)
unnamed: R84.2, X5.4 (PWM)
PWRON: R86.1
TSENSE: C146.1, R82.2, TH1.1

Notes on the sheet:
TEMPERATURE SENSOR
CPU FAN
