DiodeDrop/MiniMu/MiniMu_V1.2_(NextPCB)/Front_USB.kicad_sch

## KiCad design MiniMu_V1.2_(NextPCB)/Front_USB.kicad_sch (2025-07-30)

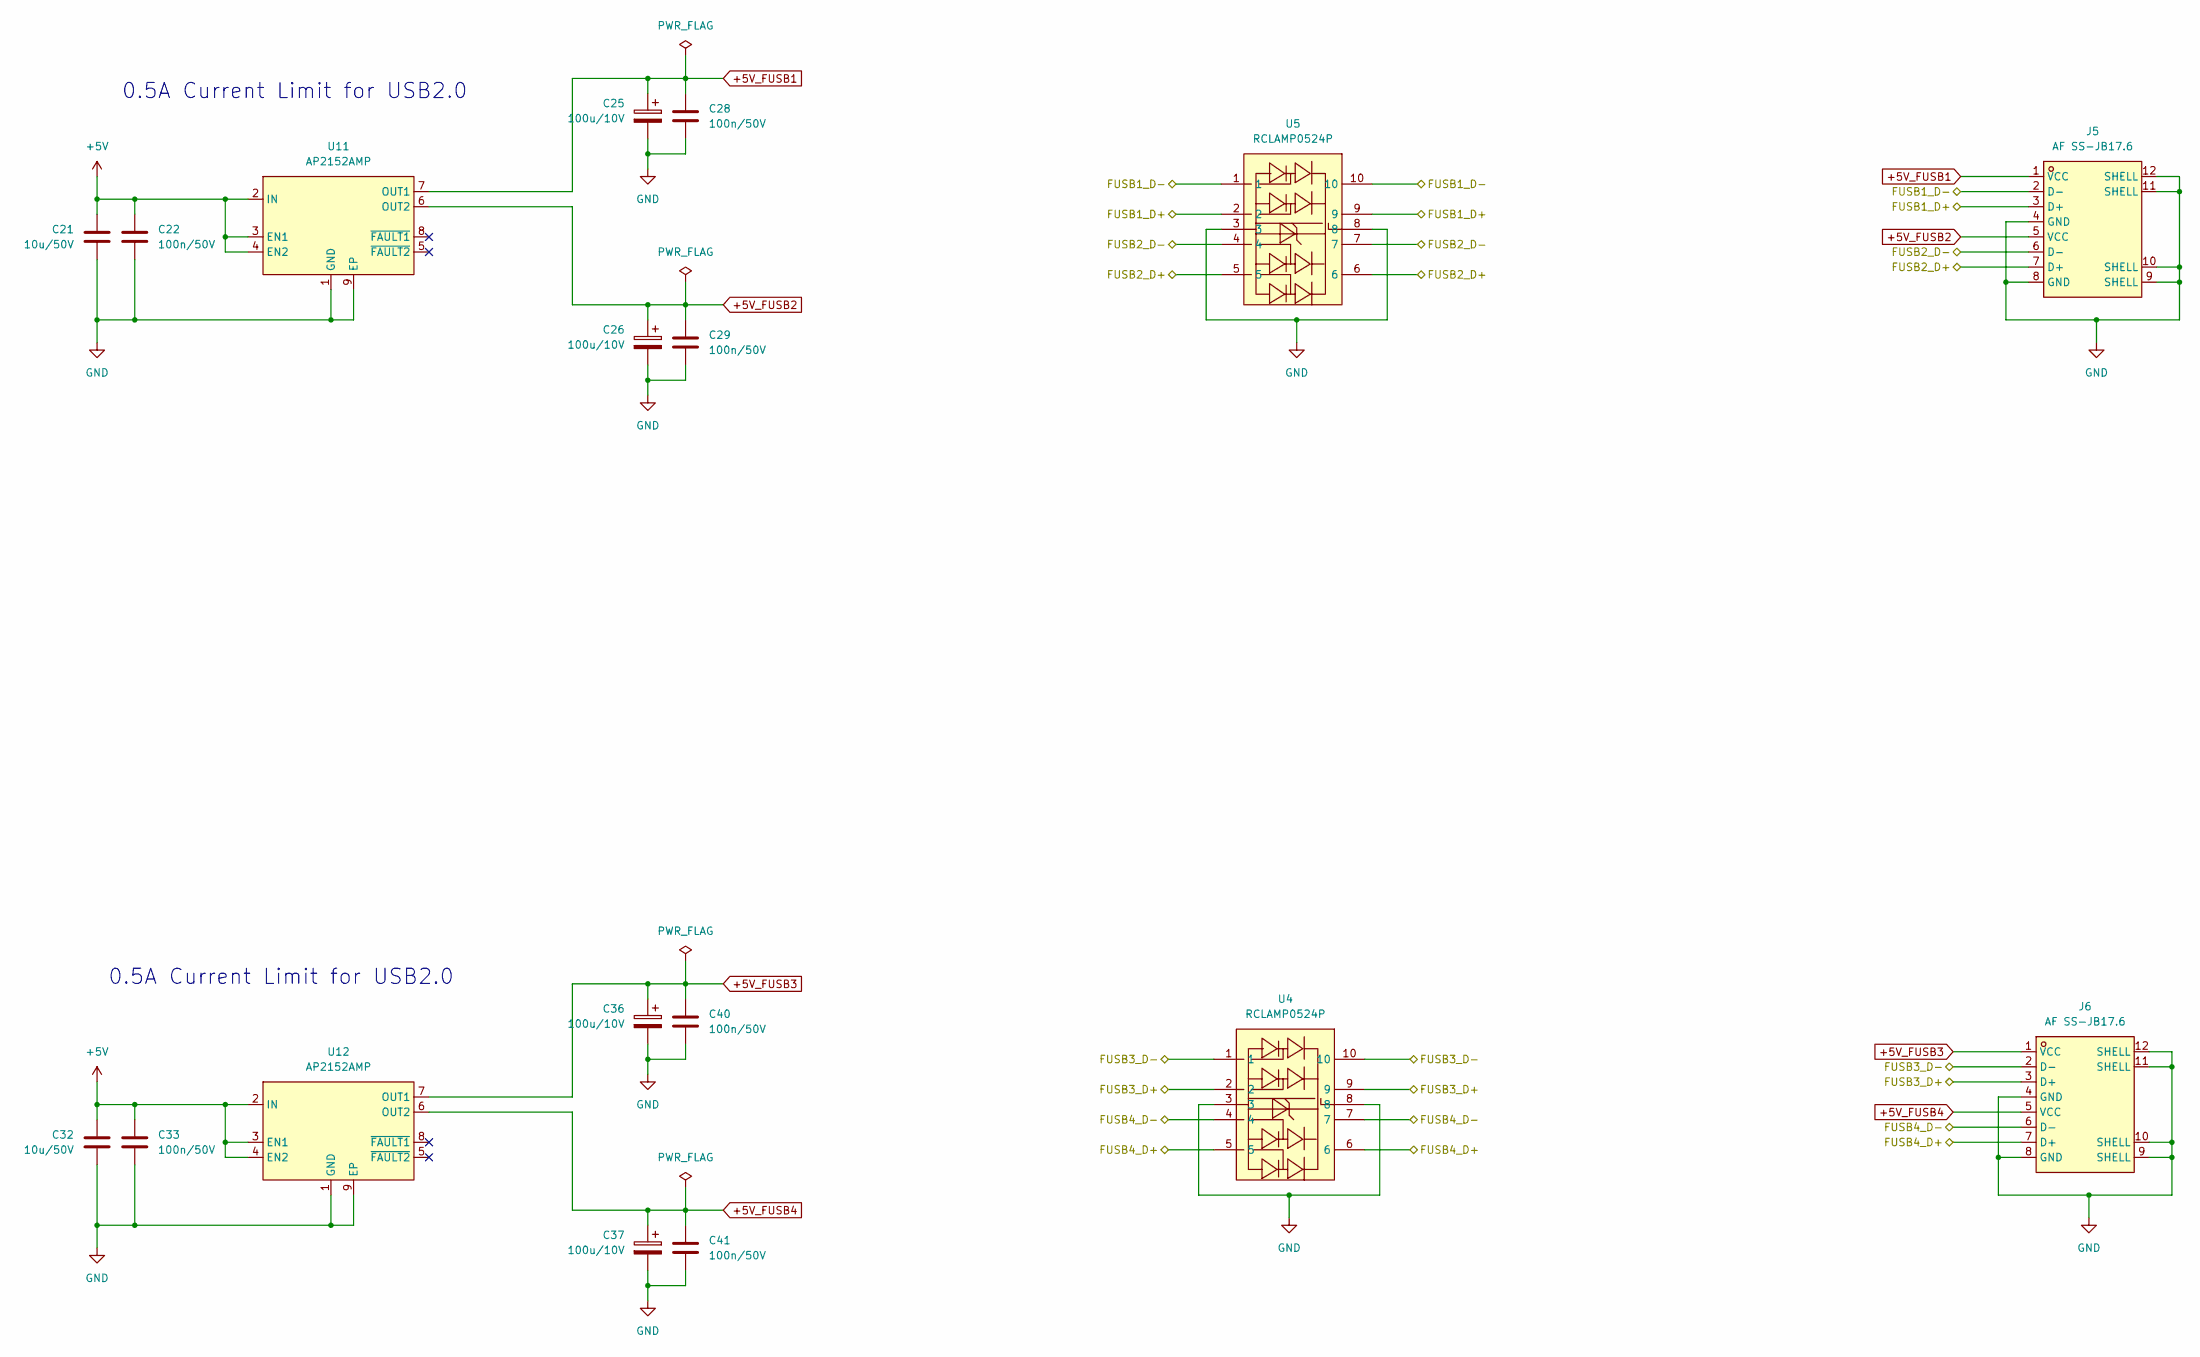
[picture p27: schematic Front_USB.kicad_sch]

Parts:
C21, C32: 10u/50V; C_0805_2012Metric; LCSC Part C440198
C22, C28, C29, C33, C40, C41: 100n/50V; C_0603_1608Metric; LCSC Part C282519
C25, C26, C36, C37: 100u/10V; CP_EIA-3216-18_Kemet-A; LCSC Part C313517
J5, J6: AF SS-JB17.6; USB-A-TH_AF-SS-JB17.6; MPN AF SS-JB17.6; LCSC Part C456021
U4, U5: RCLAMP0524P; MPN RCLAMP0524P; LCSC Part C19829566
U11, U12: AP2152AMP; MSOP-8-1EP_3x3mm_P0.65mm_EP1.95x2.15mm; MPN AP2152AMP; LCSC Part C2150126

Connections:
+5V: C21.1, C22.1, C32.1, C33.1, U11.2 (IN), U11.3 (EN1), U11.4 (EN2), U12.2 (IN), U12.3 (EN1), U12.4 (EN2)
+5V_FUSB1: C25.1, C28.1, J5.1 (VCC), U11.7 (OUT1)
+5V_FUSB2: C26.1, C29.1, J5.5 (VCC), U11.6 (OUT2)
+5V_FUSB3: C36.1, C40.1, J6.1 (VCC), U12.7 (OUT1)
+5V_FUSB4: C37.1, C41.1, J6.5 (VCC), U12.6 (OUT2)
FUSB1_D+: J5.3 (D+), U5.2, U5.9
FUSB1_D-: J5.2 (D-), U5.1, U5.10
FUSB2_D+: J5.7 (D+), U5.5, U5.6
FUSB2_D-: J5.6 (D-), U5.4, U5.7
FUSB3_D+: J6.3 (D+), U4.2, U4.9
FUSB3_D-: J6.2 (D-), U4.1, U4.10
FUSB4_D+: J6.7 (D+), U4.5, U4.6
FUSB4_D-: J6.6 (D-), U4.4, U4.7
GND: C21.2, C22.2, C25.2, C26.2, C28.2, C29.2, C32.2, C33.2, C36.2, C37.2, C40.2, C41.2, J5.4 (GND), J5.8 (GND), J5.9 (SHELL), J5.10 (SHELL), J5.11 (SHELL), J5.12 (SHELL), J6.4 (GND), J6.8 (GND), J6.9 (SHELL), J6.10 (SHELL), J6.11 (SHELL), J6.12 (SHELL), U4.3, U4.8, U5.3, U5.8, U11.1 (GND), U11.9 (EP), U12.1 (GND), U12.9 (EP)

Notes on the sheet:
0.5A Current Limit for USB2.0
