DiodeDrop/MiniMu/MiniMu_V1.2_(NextPCB)/HDMI.kicad_sch

## KiCad design MiniMu_V1.2_(NextPCB)/HDMI.kicad_sch (2025-07-30)

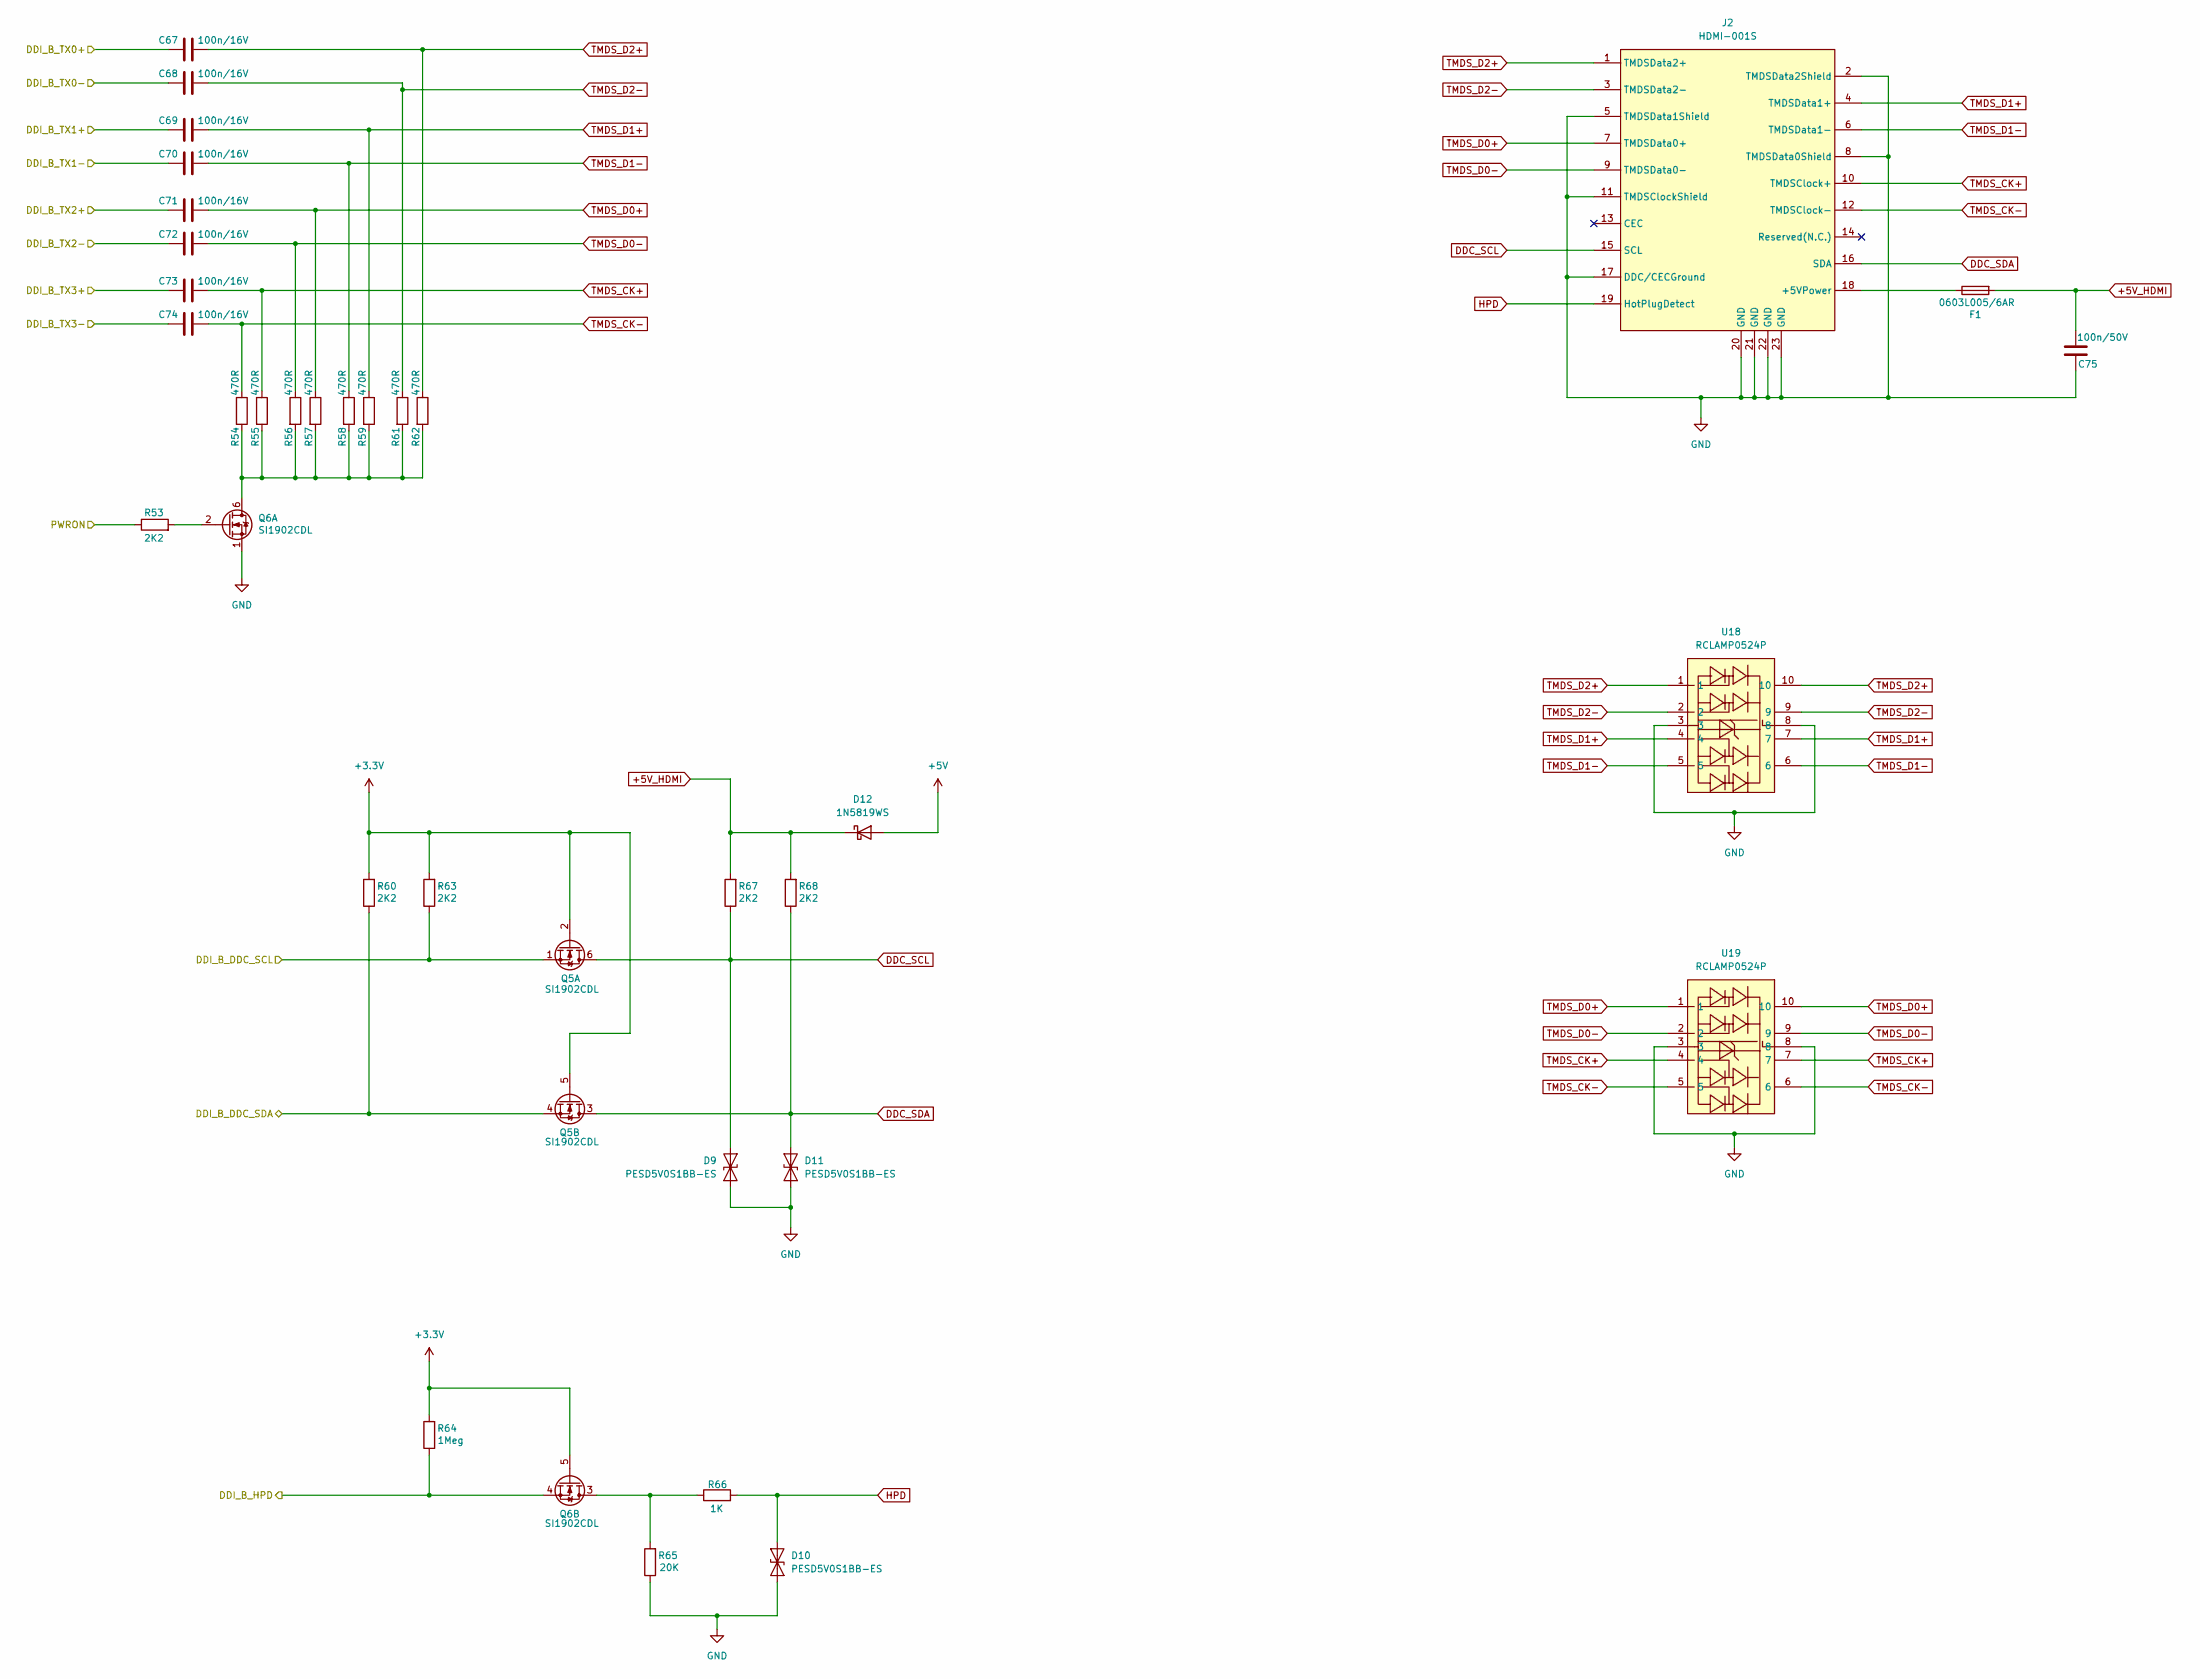
[picture p28: schematic HDMI.kicad_sch]

Parts:
C67, C68, C69, C70, C71, C72, C73, C74: 100n/16V; C_0402_1005Metric; LCSC Part C76698
C75: 100n/50V; C_0603_1608Metric; LCSC Part C282519
D9, D10, D11: PESD5V0S1BB-ES; D_SOD-523; MPN PESD5V0S1BB-ES; LCSC Part C5199184
D12: 1N5819WS; D_SOD-323; MPN 1N5819WS; LCSC Part C2939001
F1: 0603L005/6AR; Fuse_0603_1608Metric; MPN 0603L005/6AR; LCSC Part C7472508
J2: HDMI-001S; HDMI-SMD_HDMI-001S; MPN HDMI-001S; LCSC Part C720616
Q5, Q6: SI1902CDL; SOT-363_SC-70-6; MPN SI1902CDL; LCSC Part C466988
R53, R60, R63, R67, R68: 2K2; R_0603_1608Metric; MPN 0603WAF2201T5E; LCSC Part C4190
R54, R55, R56, R57, R58, R59, R61, R62: 470R; R_0402_1005Metric; MPN 0402WGF4700TCE; LCSC Part C25117
R64: 1Meg; R_0603_1608Metric; MPN 0603WAF1004T5E; LCSC Part C22935
R65: 20K; R_0603_1608Metric; MPN 0603WAF2002T5E; LCSC Part C4184
R66: 1K; R_0603_1608Metric; MPN 0603WAF1001T5E; LCSC Part C21190
U18, U19: RCLAMP0524P; MPN RCLAMP0524P; LCSC Part C19829566

Connections:
+3.3V: Q5.2 (G), Q5.5 (G), Q6.5 (G), R60.2, R63.2, R64.2
+5V: D12.2 (A)
+5V_HDMI: C75.2, D12.1 (K), F1.2, R67.2, R68.2
DDC_SCL: D9.2 (A2), J2.15 (SCL), Q5.6 (D), R67.1
DDC_SDA: D11.2 (A2), J2.16 (SDA), Q5.3 (D), R68.1
DDI_B_DDC_SCL: Q5.1 (S), R63.1
DDI_B_DDC_SDA: Q5.4 (S), R60.1
DDI_B_HPD: Q6.4 (S), R64.1
DDI_B_TX0+: C67.1
DDI_B_TX0-: C68.1
DDI_B_TX1+: C69.1
DDI_B_TX1-: C70.1
DDI_B_TX2+: C71.1
DDI_B_TX2-: C72.1
DDI_B_TX3+: C73.1
DDI_B_TX3-: C74.1
GND: C75.1, D9.1 (A1), D10.1 (A1), D11.1 (A1), J2.2 (TMDSData2Shield), J2.5 (TMDSData1Shield), J2.8 (TMDSData0Shield), J2.11 (TMDSClockShield), J2.17 (DDC/CECGround), J2.20 (GND), J2.21 (GND), J2.22 (GND), J2.23 (GND), Q6.1 (S), R65.1, U18.3, U18.8, U19.3, U19.8
HPD: D10.2 (A2), J2.19 (HotPlugDetect), R66.2
unnamed: F1.1, J2.18 (+5VPower)
unnamed: Q6.2 (G), R53.2
unnamed: Q6.3 (D), R65.2, R66.1
unnamed: Q6.6 (D), R54.2, R55.2, R56.2, R57.2, R58.2, R59.2, R61.2, R62.2
PWRON: R53.1
TMDS_CK+: C73.2, J2.10 (TMDSClock+), R55.1, U19.4, U19.7
TMDS_CK-: C74.2, J2.12 (TMDSClock-), R54.1, U19.5, U19.6
TMDS_D0+: C71.2, J2.7 (TMDSData0+), R57.1, U19.1, U19.10
TMDS_D0-: C72.2, J2.9 (TMDSData0-), R56.1, U19.2, U19.9
TMDS_D1+: C69.2, J2.4 (TMDSData1+), R59.1, U18.4, U18.7
TMDS_D1-: C70.2, J2.6 (TMDSData1-), R58.1, U18.5, U18.6
TMDS_D2+: C67.2, J2.1 (TMDSData2+), R62.1, U18.1, U18.10
TMDS_D2-: C68.2, J2.3 (TMDSData2-), R61.1, U18.2, U18.9
