DiodeDrop/MiniMu/MiniMu_V1.2_(NextPCB)/HD_Audio.kicad_sch

## KiCad design MiniMu_V1.2_(NextPCB)/HD_Audio.kicad_sch (2025-07-30)

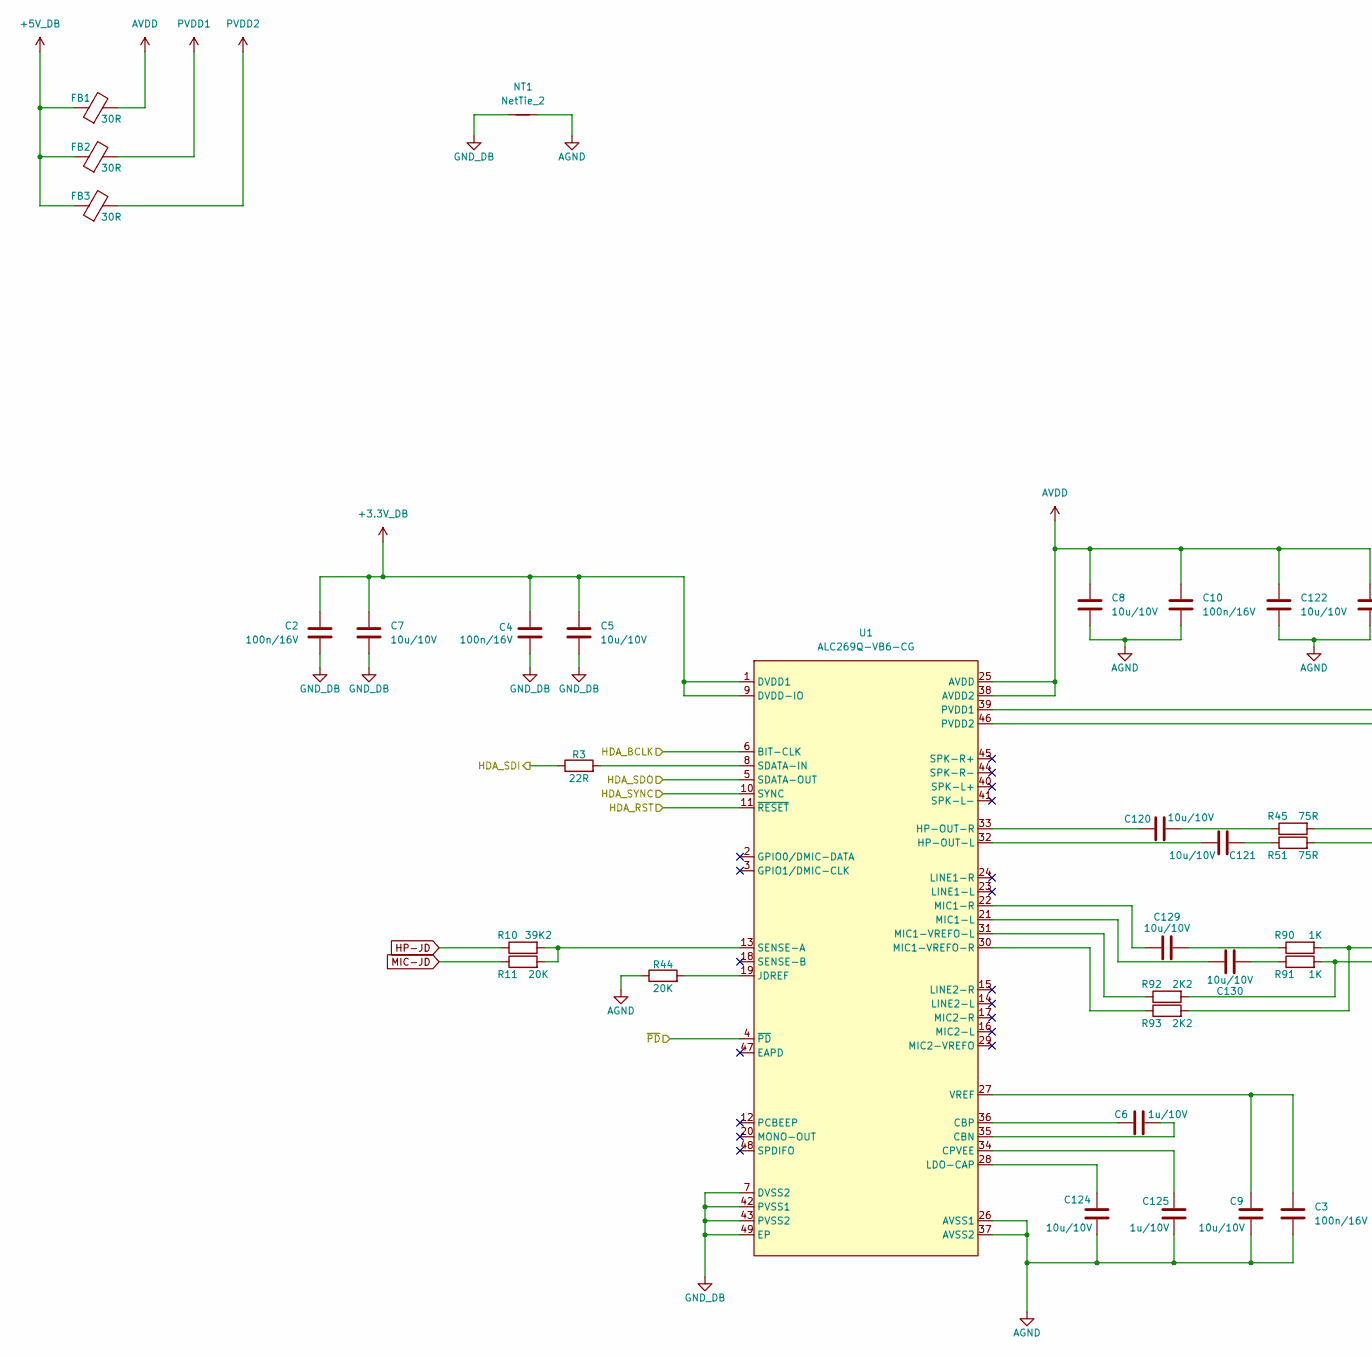
[picture p29: schematic HD_Audio.kicad_sch, part in row 1, column 1]

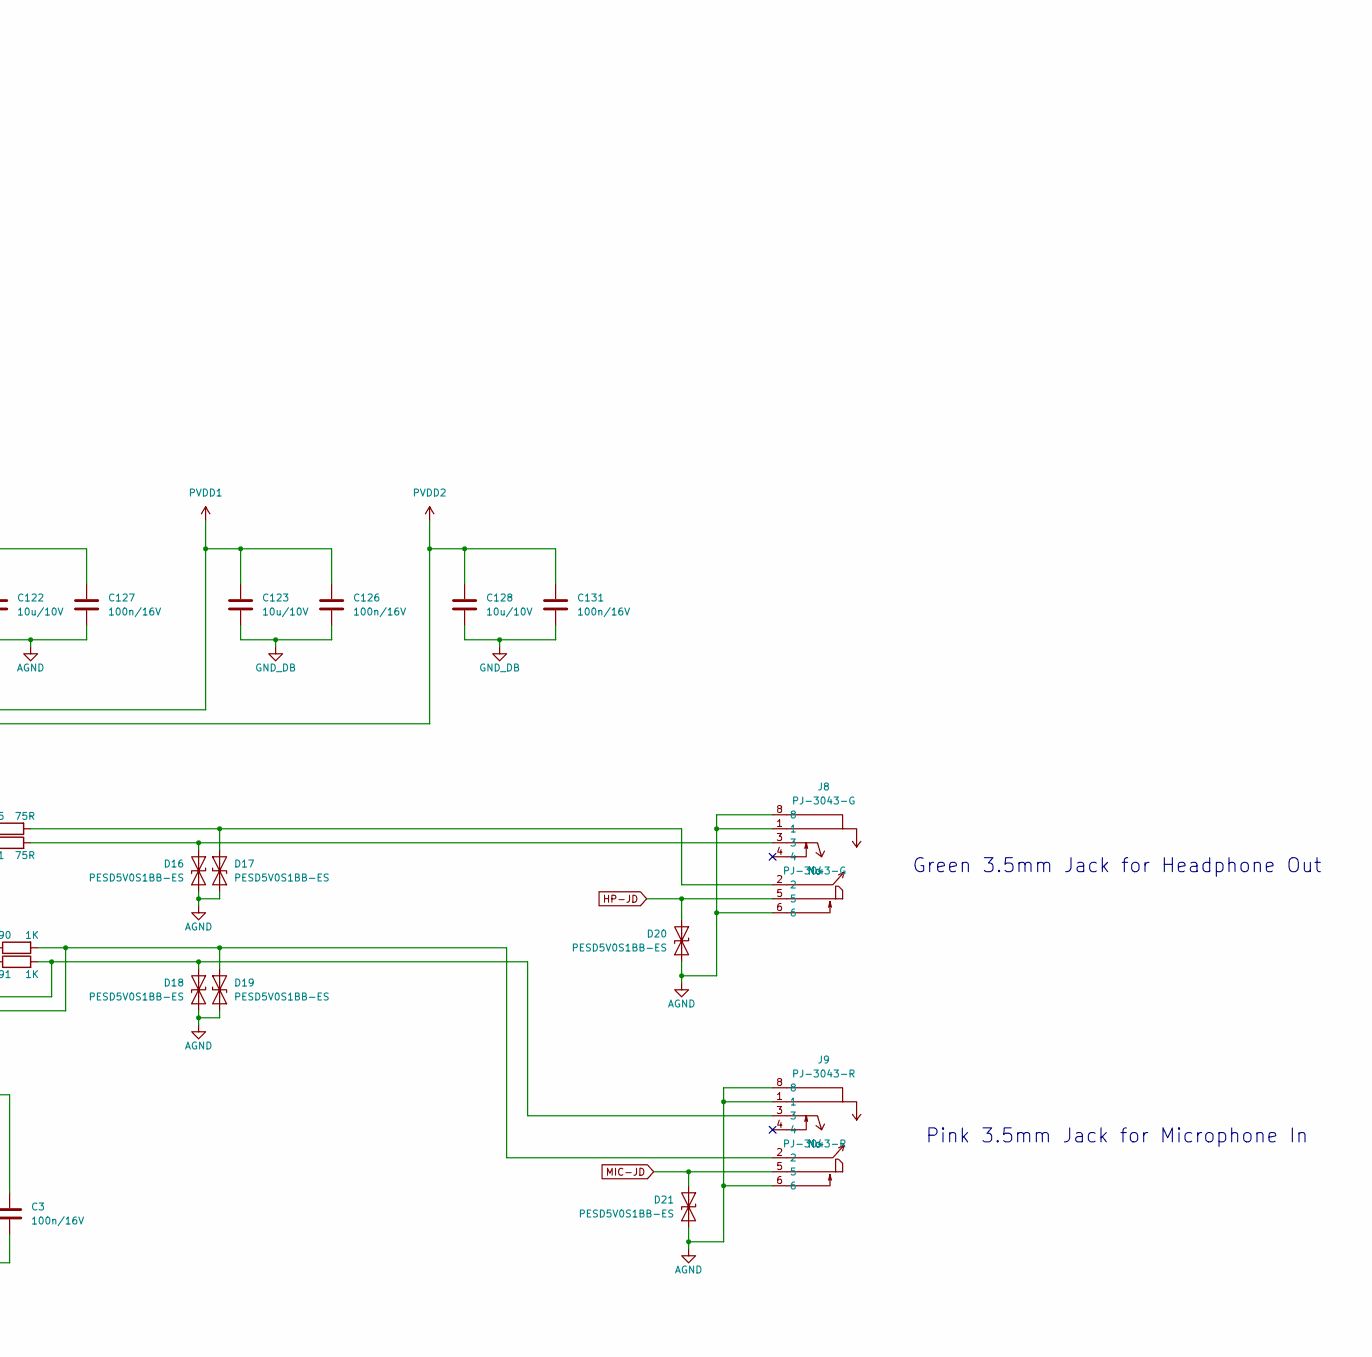
[picture p30: schematic HD_Audio.kicad_sch, part in row 1, column 2]

Parts:
C2, C3, C4, C10, C126, C127, C131: 100n/16V; C_0402_1005Metric; LCSC Part C76698
C5, C7, C8, C9, C120, C121, C122, C123, C124, C128, C129, C130: 10u/10V; C_0402_1005Metric; LCSC Part C5252392
C6, C125: 1u/10V; C_0402_1005Metric; LCSC Part C7503520
D16, D17, D18, D19, D20, D21: PESD5V0S1BB-ES; D_SOD-523; MPN PESD5V0S1BB-ES; LCSC Part C5199184
FB1, FB2, FB3: 30R; L_0603_1608Metric; MPN BLM18PG300SN1D; LCSC Part C17305
J8: PJ-3043-G; AUDIO-TH_XKB_PJ-3043-R; MPN PJ-3043-G; LCSC Part C2884996
J9: PJ-3043-R; AUDIO-TH_XKB_PJ-3043-R; MPN PJ-3043-R; LCSC Part C2884997
NT1: NetTie_2; NetTie-2_SMD_Pad0.5mm
R3: 22R; R_0603_1608Metric; MPN 0603WAF220JT5E; LCSC Part C23345
R10: 39K2; R_0603_1608Metric; MPN 0603WAF3922T5E; LCSC Part C23037
R11, R44: 20K; R_0603_1608Metric; MPN 0603WAF2002T5E; LCSC Part C4184
R45, R51: 75R; R_0603_1608Metric; MPN 0603WAF750JT5E; LCSC Part C4275
R90, R91: 1K; R_0603_1608Metric; MPN 0603WAF1001T5E; LCSC Part C21190
R92, R93: 2K2; R_0603_1608Metric; MPN 0603WAF2201T5E; LCSC Part C4190
U1: ALC269Q-VB6-CG; QFN-48-1EP_6x6mm_P0.4mm_EP4.2x4.2mm; MPN ALC269Q-VB6-CG; LCSC Part N/A

Connections:
+3.3V_DB: C2.1, C4.1, C5.1, C7.1, U1.1 (DVDD1), U1.9 (DVDD-IO)
+5V_DB: FB1.1, FB2.1, FB3.1
AGND: C3.2, C8.2, C9.2, C10.2, C122.2, C124.2, C125.2, C127.2, D16.1 (A1), D17.1 (A1), D18.1 (A1), D19.1 (A1), D20.1 (A1), D21.1 (A1), J8.1, J8.6, J8.8, J9.1, J9.6, J9.8, NT1.2, R44.1, U1.26 (AVSS1), U1.37 (AVSS2)
AVDD: C8.1, C10.1, C122.1, C127.1, FB1.2, U1.25 (AVDD), U1.38 (AVDD2)
GND_DB: C2.2, C4.2, C5.2, C7.2, C123.2, C126.2, C128.2, C131.2, NT1.1, U1.7 (DVSS2), U1.42 (PVSS1), U1.43 (PVSS2), U1.49 (EP)
HDA_BCLK: U1.6 (BIT-CLK)
HDA_RST: U1.11 (~RESET)
HDA_SDI: R3.1
HDA_SDO: U1.5 (SDATA-OUT)
HDA_SYNC: U1.10 (SYNC)
HP-JD: D20.2 (A2), J8.5, R10.1
MIC-JD: D21.2 (A2), J9.5, R11.1
unnamed: C3.1, C9.1, U1.27 (VREF)
unnamed: C6.1, U1.35 (CBN)
unnamed: C6.2, U1.36 (CBP)
unnamed: C120.1, R45.1
unnamed: C120.2, U1.33 (HP-OUT-R)
unnamed: C121.1, R51.1
unnamed: C121.2, U1.32 (HP-OUT-L)
unnamed: C124.1, U1.28 (LDO-CAP)
unnamed: C125.1, U1.34 (CPVEE)
unnamed: C129.1, R90.1
unnamed: C129.2, U1.22 (MIC1-R)
unnamed: C130.1, R91.1
unnamed: C130.2, U1.21 (MIC1-L)
unnamed: D16.2 (A2), J8.3, R51.2
unnamed: D17.2 (A2), J8.2, R45.2
unnamed: D18.2 (A2), J9.3, R91.2, R92.2
unnamed: D19.2 (A2), J9.2, R90.2, R93.2
unnamed: R3.2, U1.8 (SDATA-IN)
unnamed: R10.2, R11.2, U1.13 (SENSE-A)
unnamed: R44.2, U1.19 (JDREF)
unnamed: R92.1, U1.31 (MIC1-VREFO-L)
unnamed: R93.1, U1.30 (MIC1-VREFO-R)
PVDD1: C123.1, C126.1, FB2.2, U1.39 (PVDD1)
PVDD2: C128.1, C131.1, FB3.2, U1.46 (PVDD2)
~PD: U1.4 (~PD)

Notes on the sheet:
Pink 3.5mm Jack for Microphone In
Green 3.5mm Jack for Headphone Out
