DiodeDrop/MiniMu/MiniMu_V1.2_(NextPCB)/Interboard_Conn.kicad_sch

## KiCad design MiniMu_V1.2_(NextPCB)/Interboard_Conn.kicad_sch (2025-07-30)

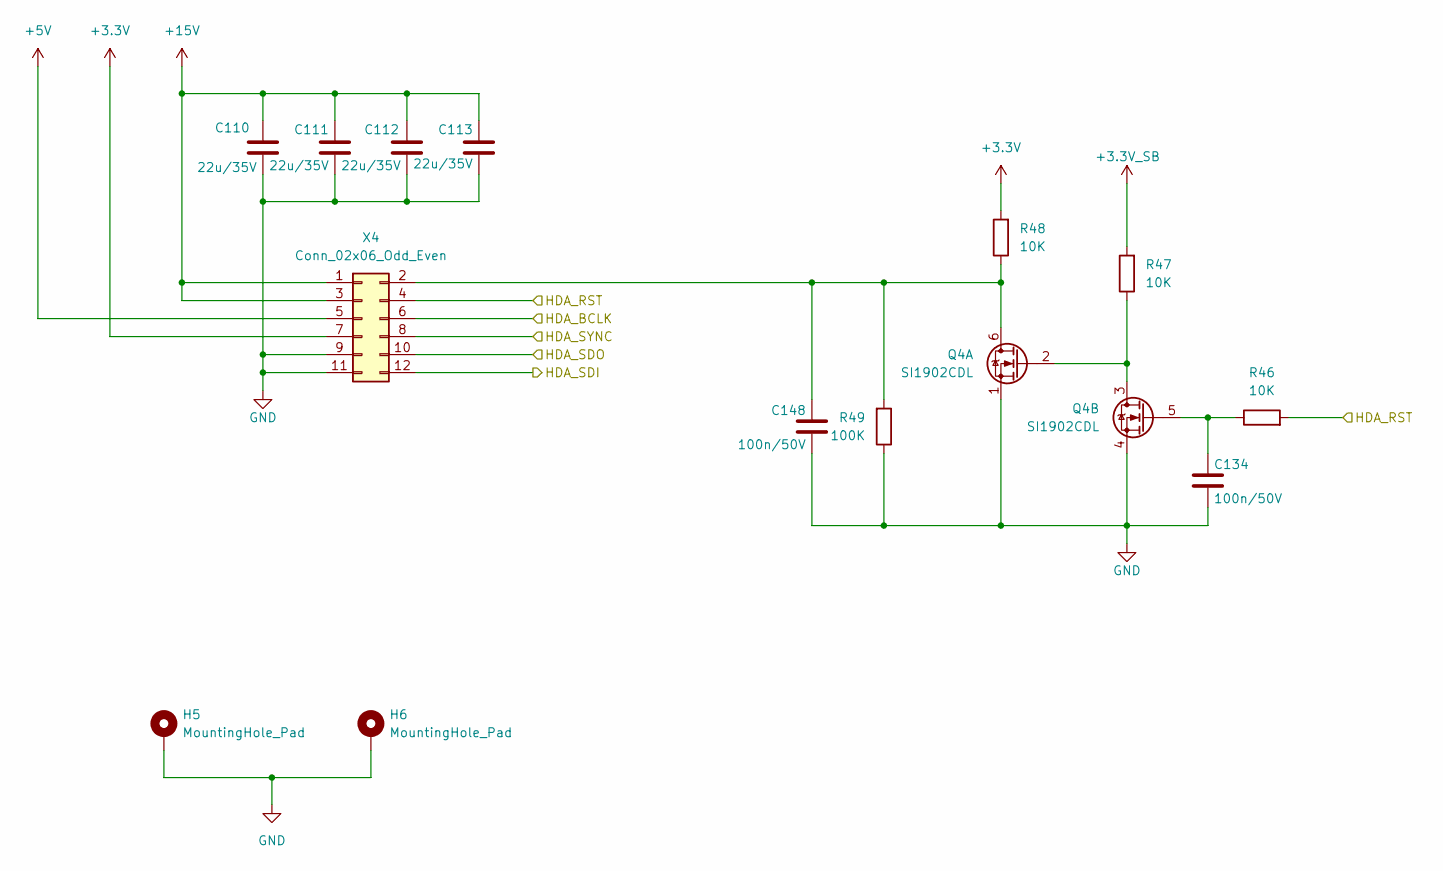
[picture p31: schematic Interboard_Conn.kicad_sch]

Parts:
C110, C111, C112, C113: 22u/35V; C_0805_2012Metric; LCSC Part C22367832
C134, C148: 100n/50V; C_0603_1608Metric; LCSC Part C282519
H5, H6: MountingHole_Pad; MountingHole_2.2mm_M2_Pad_TopBottom
Q4: SI1902CDL; SOT-363_SC-70-6; MPN SI1902CDL; LCSC Part C466988
R46, R47, R48: 10K; R_0603_1608Metric; MPN 0603WAF1002T5E; LCSC Part C25804
R49: 100K; R_0603_1608Metric; MPN 0603WAF1003T5E; LCSC Part C25803
X4: Conn_02x06_Odd_Even; PinHeader_2x06_P2.54mm_Vertical_SMD; MPN HX PZ2.54-2x6P TP; LCSC Part C32713286

Connections:
+3.3V: R48.2, X4.7
+3.3V_SB: R47.2
+5V: X4.5
+15V: C110.1, C111.1, C112.1, C113.1, X4.1, X4.3
GND: C110.2, C111.2, C112.2, C113.2, C134.2, C148.2, H5.1, H6.1, Q4.1 (S), Q4.4 (S), R49.1, X4.9, X4.11
HDA_BCLK: X4.6
HDA_RST: R46.2, X4.4
HDA_SDI: X4.12
HDA_SDO: X4.10
HDA_SYNC: X4.8
unnamed: C134.1, Q4.5 (G), R46.1
unnamed: C148.1, Q4.6 (D), R48.1, R49.2, X4.2
unnamed: Q4.2 (G), Q4.3 (D), R47.1
