DiodeDrop/MiniMu/MiniMu_V1.2_(NextPCB)/LattePanda_Module.kicad_sch

## KiCad design MiniMu_V1.2_(NextPCB)/LattePanda_Module.kicad_sch (2025-07-30)

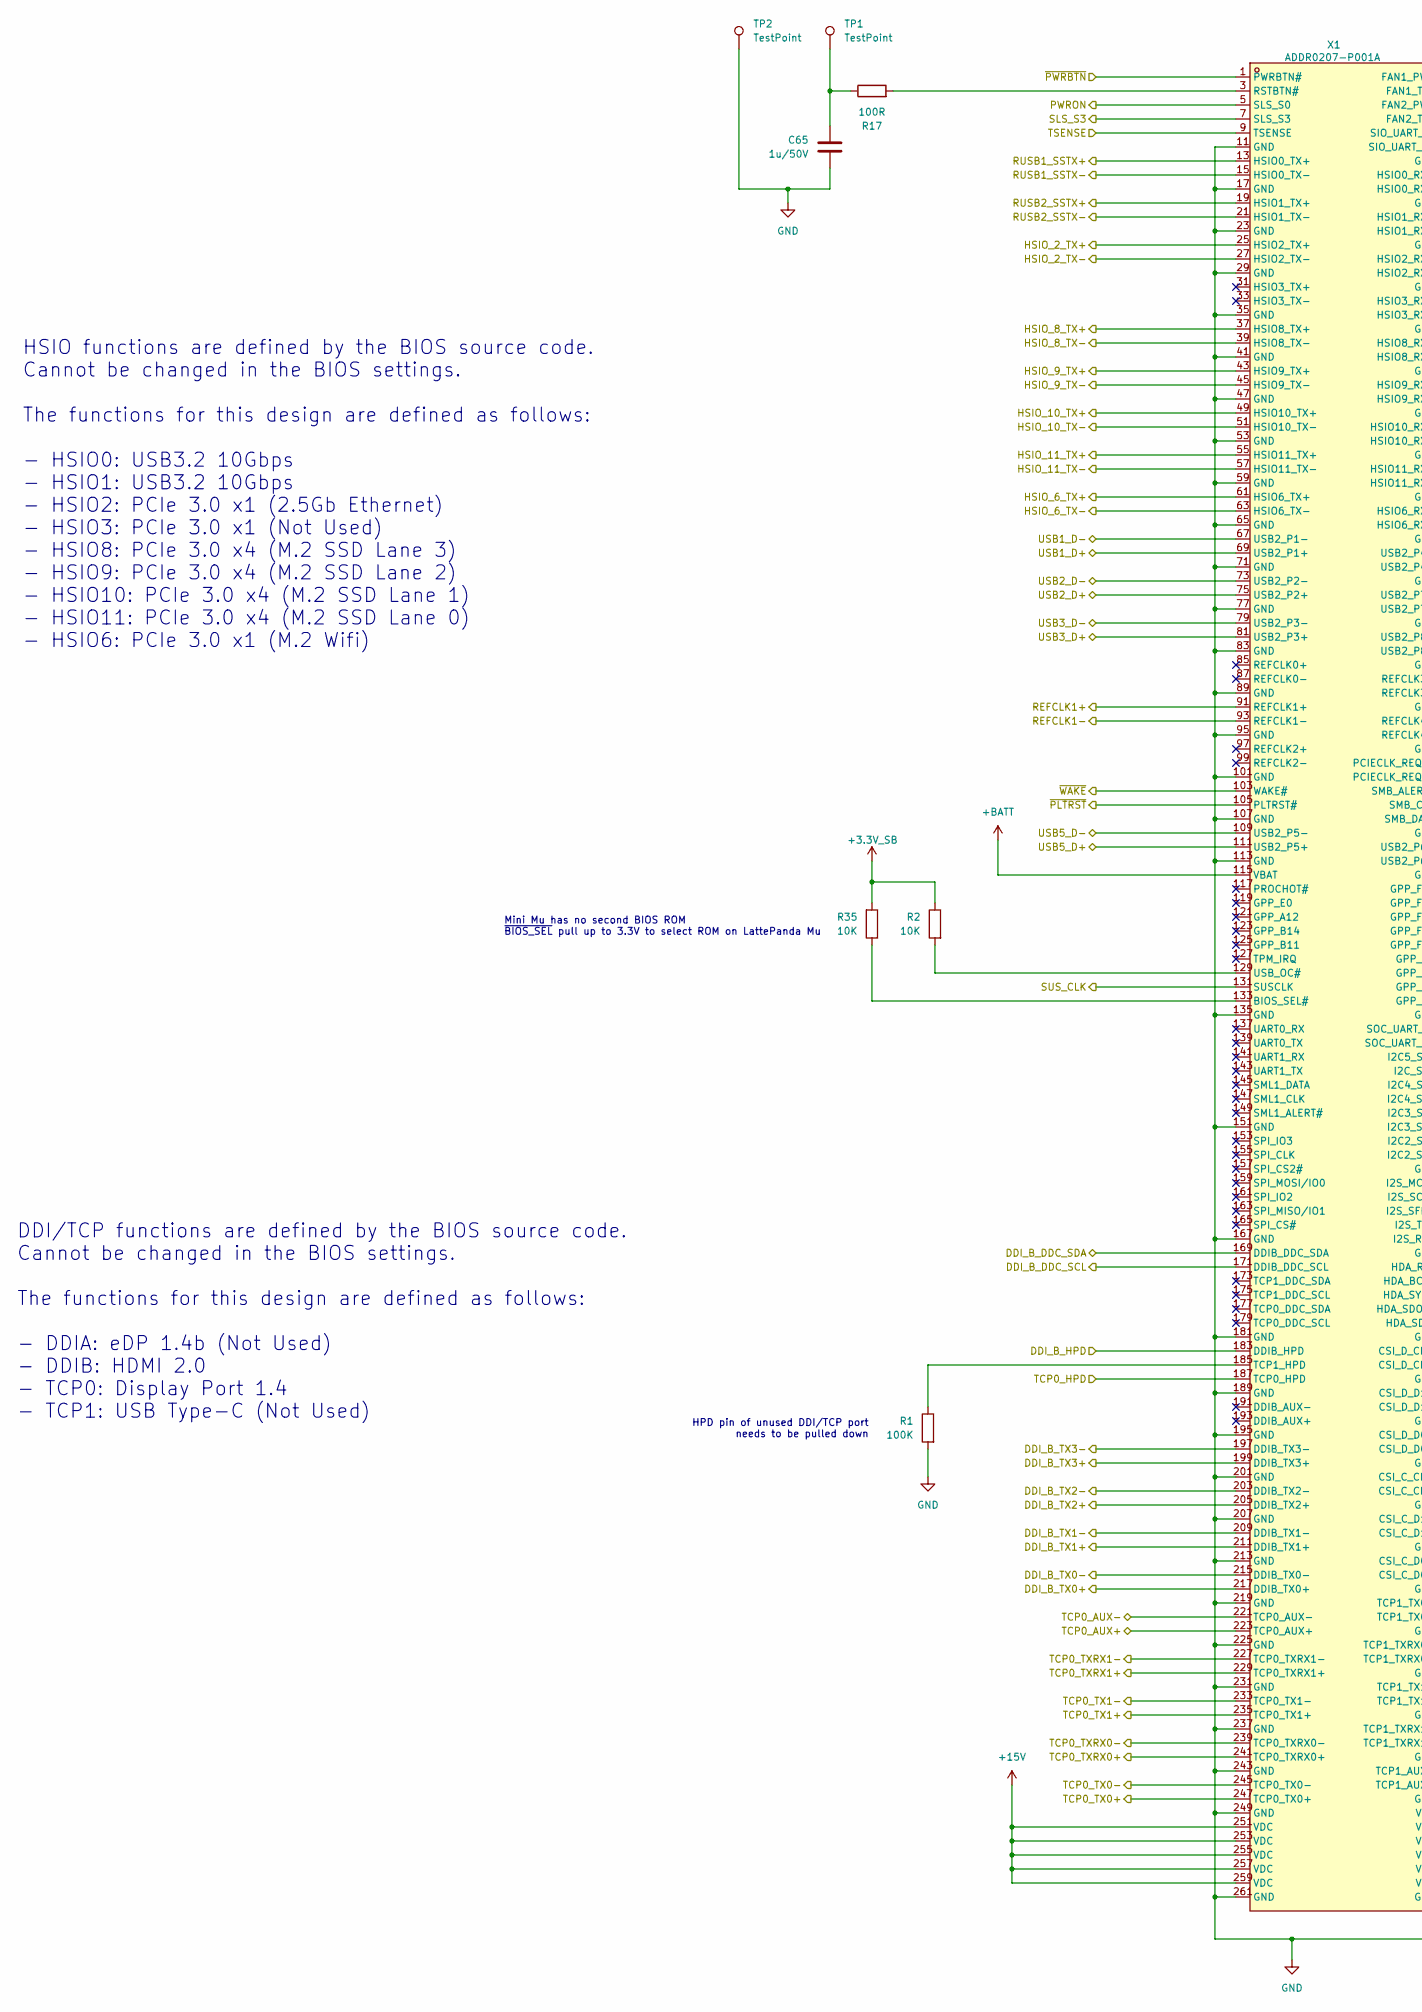
[picture p32: schematic LattePanda_Module.kicad_sch, part in row 1, column 1]

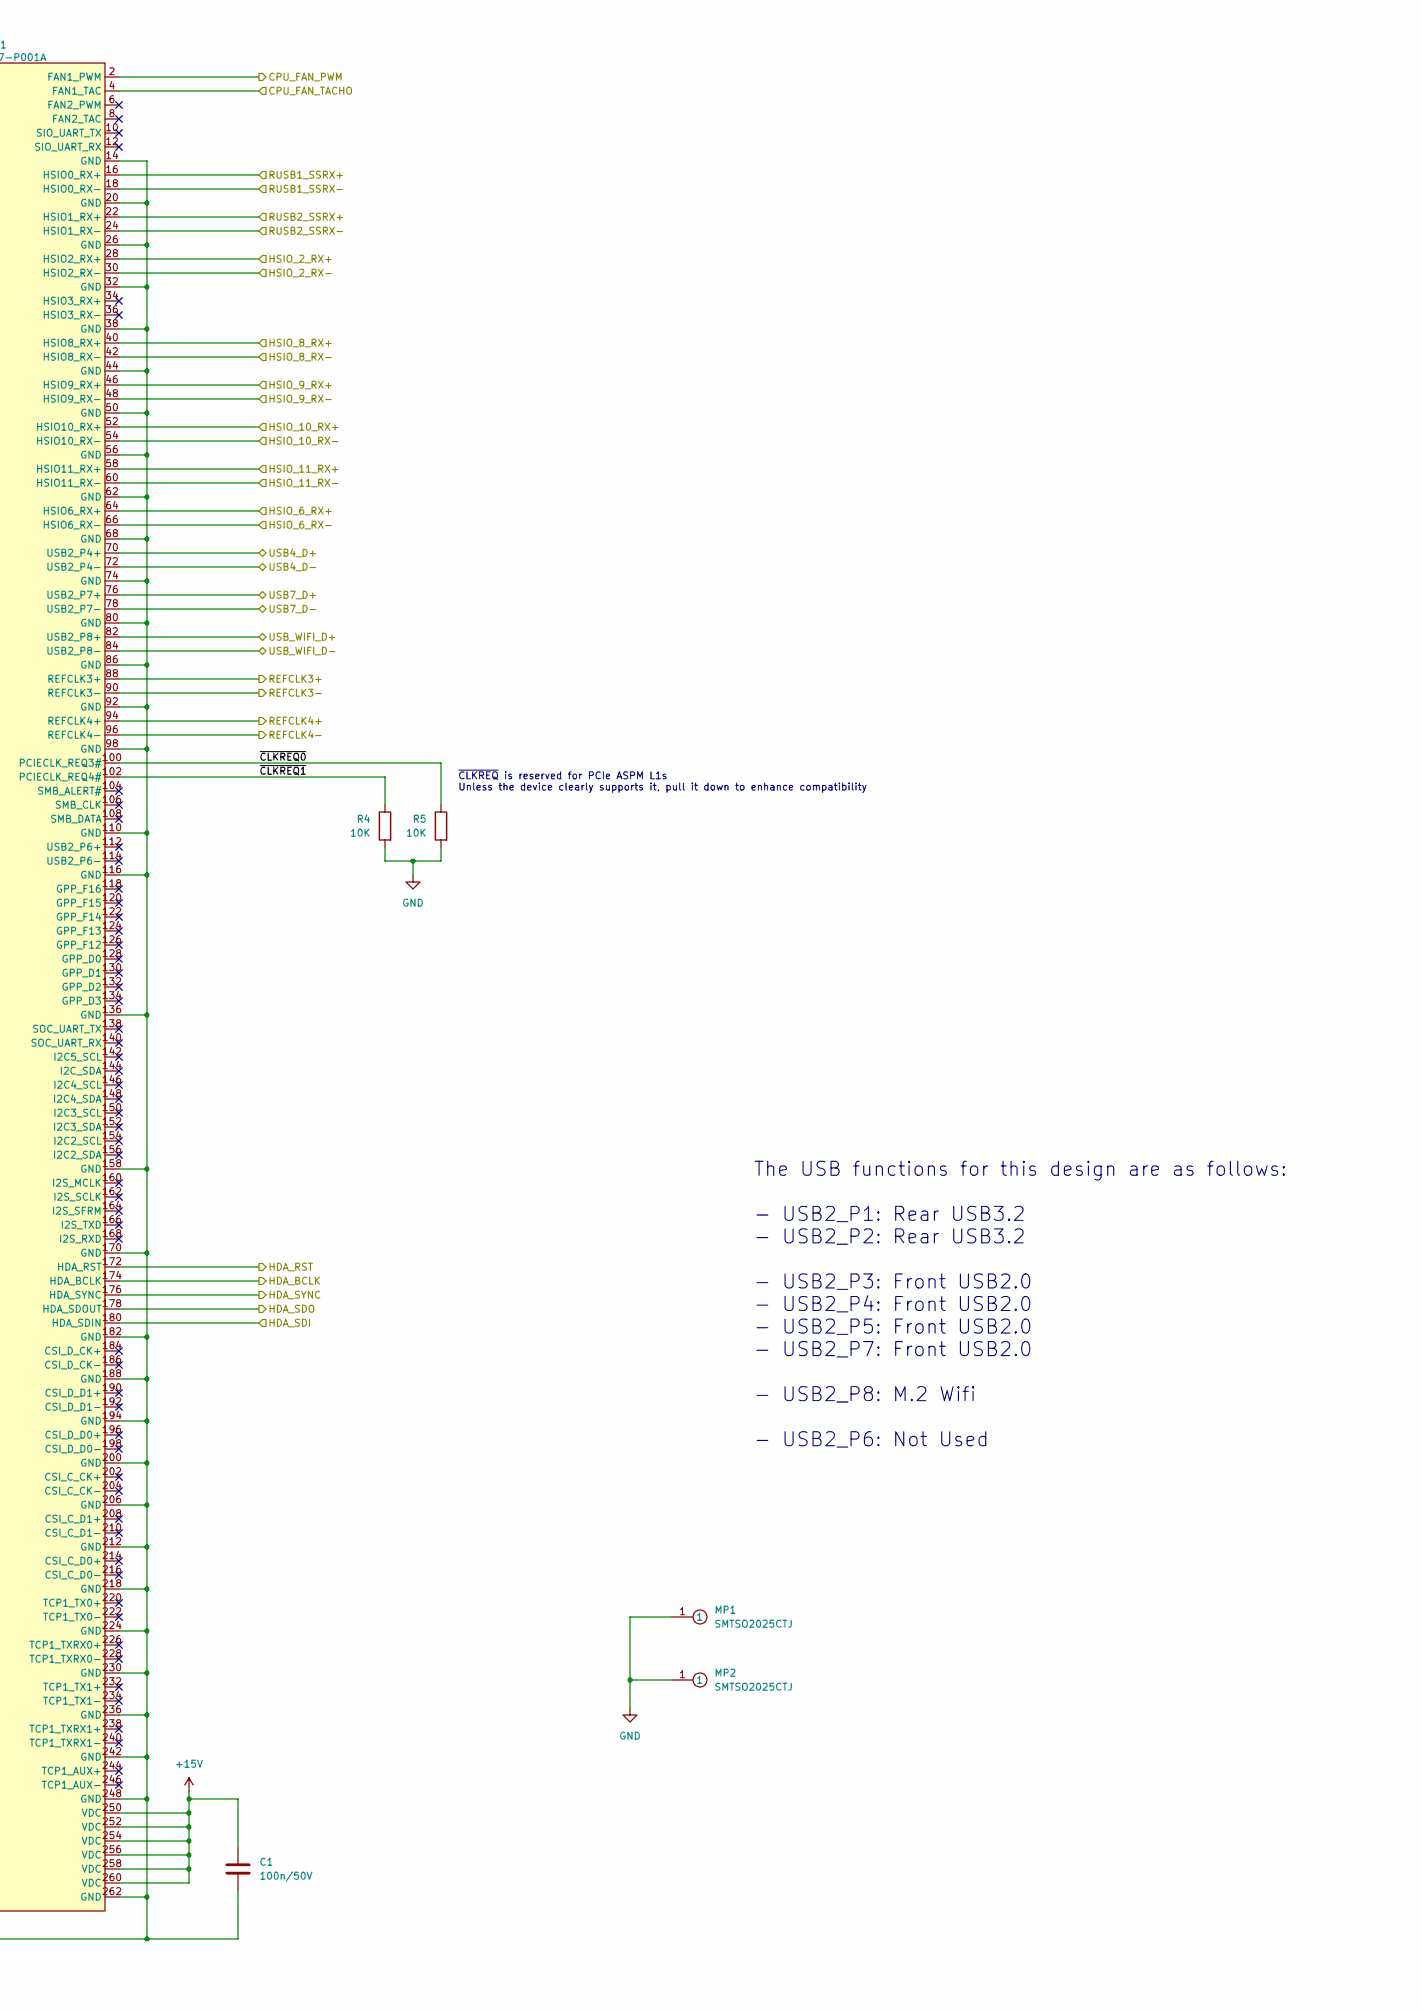
[picture p33: schematic LattePanda_Module.kicad_sch, part in row 1, column 2]

Parts:
C1: 100n/50V; C_0603_1608Metric; LCSC Part C282519
C65: 1u/50V; C_0603_1608Metric; LCSC Part C157684
MP1, MP2: SMTSO2025CTJ; MountingHole_3.7mm_Pad_TopOnly; MPN SMTSO2025CTJ; LCSC Part C2916321
R1: 100K; R_0603_1608Metric; MPN 0603WAF1003T5E; LCSC Part C25803
R2, R4, R5, R35: 10K; R_0603_1608Metric; MPN 0603WAF1002T5E; LCSC Part C25804
R17: 100R; R_0603_1608Metric; MPN 0603WAF1000T5E; LCSC Part C22775
TP1, TP2: TestPoint; TestPoint_Pad_D1.5mm
X1: ADDR0207-P001A; DIMM-SMD_ADDR0205-P001A; MPN ADDR0205-P001A; LCSC Part C962120

Connections:
+3.3V_SB: R2.1, R35.2
+15V: C1.1, X1.250 (VDC), X1.251 (VDC), X1.252 (VDC), X1.253 (VDC), X1.254 (VDC), X1.255 (VDC), X1.256 (VDC), X1.257 (VDC), X1.258 (VDC), X1.259 (VDC), X1.260 (VDC)
+BATT: X1.115 (VBAT)
CPU_FAN_PWM: X1.2 (FAN1_PWM)
CPU_FAN_TACHO: X1.4 (FAN1_TAC)
DDI_B_DDC_SCL: X1.171 (DDIB_DDC_SCL)
DDI_B_DDC_SDA: X1.169 (DDIB_DDC_SDA)
DDI_B_HPD: X1.183 (DDIB_HPD)
DDI_B_TX0+: X1.217 (DDIB_TX0+)
DDI_B_TX0-: X1.215 (DDIB_TX0-)
DDI_B_TX1+: X1.211 (DDIB_TX1+)
DDI_B_TX1-: X1.209 (DDIB_TX1-)
DDI_B_TX2+: X1.205 (DDIB_TX2+)
DDI_B_TX2-: X1.203 (DDIB_TX2-)
DDI_B_TX3+: X1.199 (DDIB_TX3+)
DDI_B_TX3-: X1.197 (DDIB_TX3-)
GND: C1.2, C65.2, MP1.1, MP2.1, R1.2, R4.2, R5.2, TP2.1, X1.11 (GND), X1.14 (GND), X1.17 (GND), X1.20 (GND), X1.23 (GND), X1.26 (GND), X1.29 (GND), X1.32 (GND), X1.35 (GND), X1.38 (GND), X1.41 (GND), X1.44 (GND), X1.47 (GND), X1.50 (GND), X1.53 (GND), X1.56 (GND), X1.59 (GND), X1.62 (GND), X1.65 (GND), X1.68 (GND), X1.71 (GND), X1.74 (GND), X1.77 (GND), X1.80 (GND), X1.83 (GND), X1.86 (GND), X1.89 (GND), X1.92 (GND), X1.95 (GND), X1.98 (GND), X1.101 (GND), X1.107 (GND), X1.110 (GND), X1.113 (GND), X1.116 (GND), X1.135 (GND), X1.136 (GND), X1.151 (GND), X1.158 (GND), X1.167 (GND), X1.170 (GND), X1.181 (GND), X1.182 (GND), X1.188 (GND), X1.189 (GND), X1.194 (GND), X1.195 (GND), X1.200 (GND), X1.201 (GND), X1.206 (GND), X1.207 (GND), X1.212 (GND), X1.213 (GND), X1.218 (GND), X1.219 (GND), X1.224 (GND), X1.225 (GND), X1.230 (GND), X1.231 (GND), X1.236 (GND), X1.237 (GND), X1.242 (GND), X1.243 (GND), X1.248 (GND), X1.249 (GND), X1.261 (GND), X1.262 (GND)
HDA_BCLK: X1.174 (HDA_BCLK)
HDA_RST: X1.172 (HDA_RST)
HDA_SDI: X1.180 (HDA_SDIN)
HDA_SDO: X1.178 (HDA_SDOUT)
HDA_SYNC: X1.176 (HDA_SYNC)
HSIO_2_RX+: X1.28 (HSIO2_RX+)
HSIO_2_RX-: X1.30 (HSIO2_RX-)
HSIO_2_TX+: X1.25 (HSIO2_TX+)
HSIO_2_TX-: X1.27 (HSIO2_TX-)
HSIO_6_RX+: X1.64 (HSIO6_RX+)
HSIO_6_RX-: X1.66 (HSIO6_RX-)
HSIO_6_TX+: X1.61 (HSIO6_TX+)
HSIO_6_TX-: X1.63 (HSIO6_TX-)
HSIO_8_RX+: X1.40 (HSIO8_RX+)
HSIO_8_RX-: X1.42 (HSIO8_RX-)
HSIO_8_TX+: X1.37 (HSIO8_TX+)
HSIO_8_TX-: X1.39 (HSIO8_TX-)
HSIO_9_RX+: X1.46 (HSIO9_RX+)
HSIO_9_RX-: X1.48 (HSIO9_RX-)
HSIO_9_TX+: X1.43 (HSIO9_TX+)
HSIO_9_TX-: X1.45 (HSIO9_TX-)
HSIO_10_RX+: X1.52 (HSIO10_RX+)
HSIO_10_RX-: X1.54 (HSIO10_RX-)
HSIO_10_TX+: X1.49 (HSIO10_TX+)
HSIO_10_TX-: X1.51 (HSIO10_TX-)
HSIO_11_RX+: X1.58 (HSIO11_RX+)
HSIO_11_RX-: X1.60 (HSIO11_RX-)
HSIO_11_TX+: X1.55 (HSIO11_TX+)
HSIO_11_TX-: X1.57 (HSIO11_TX-)
unnamed: C65.1, R17.1, TP1.1
unnamed: R1.1, X1.185 (TCP1_HPD)
unnamed: R2.2, X1.129 (USB_OC#)
unnamed: R17.2, X1.3 (RSTBTN#)
unnamed: R35.1, X1.133 (BIOS_SEL#)
PWRON: X1.5 (SLS_S0)
REFCLK1+: X1.91 (REFCLK1+)
REFCLK1-: X1.93 (REFCLK1-)
REFCLK3+: X1.88 (REFCLK3+)
REFCLK3-: X1.90 (REFCLK3-)
REFCLK4+: X1.94 (REFCLK4+)
REFCLK4-: X1.96 (REFCLK4-)
RUSB1_SSRX+: X1.16 (HSIO0_RX+)
RUSB1_SSRX-: X1.18 (HSIO0_RX-)
RUSB1_SSTX+: X1.13 (HSIO0_TX+)
RUSB1_SSTX-: X1.15 (HSIO0_TX-)
RUSB2_SSRX+: X1.22 (HSIO1_RX+)
RUSB2_SSRX-: X1.24 (HSIO1_RX-)
RUSB2_SSTX+: X1.19 (HSIO1_TX+)
RUSB2_SSTX-: X1.21 (HSIO1_TX-)
SLS_S3: X1.7 (SLS_S3)
SUS_CLK: X1.131 (SUSCLK)
TCP0_AUX+: X1.223 (TCP0_AUX+)
TCP0_AUX-: X1.221 (TCP0_AUX-)
TCP0_HPD: X1.187 (TCP0_HPD)
TCP0_TX0+: X1.247 (TCP0_TX0+)
TCP0_TX0-: X1.245 (TCP0_TX0-)
TCP0_TX1+: X1.235 (TCP0_TX1+)
TCP0_TX1-: X1.233 (TCP0_TX1-)
TCP0_TXRX0+: X1.241 (TCP0_TXRX0+)
TCP0_TXRX0-: X1.239 (TCP0_TXRX0-)
TCP0_TXRX1+: X1.229 (TCP0_TXRX1+)
TCP0_TXRX1-: X1.227 (TCP0_TXRX1-)
TSENSE: X1.9 (TSENSE)
USB1_D+: X1.69 (USB2_P1+)
USB1_D-: X1.67 (USB2_P1-)
USB2_D+: X1.75 (USB2_P2+)
USB2_D-: X1.73 (USB2_P2-)
USB3_D+: X1.81 (USB2_P3+)
USB3_D-: X1.79 (USB2_P3-)
USB4_D+: X1.70 (USB2_P4+)
USB4_D-: X1.72 (USB2_P4-)
USB5_D+: X1.111 (USB2_P5+)
USB5_D-: X1.109 (USB2_P5-)
USB7_D+: X1.76 (USB2_P7+)
USB7_D-: X1.78 (USB2_P7-)
USB_WIFI_D+: X1.82 (USB2_P8+)
USB_WIFI_D-: X1.84 (USB2_P8-)
~CLKREQ0: R5.1, X1.100 (PCIECLK_REQ3#)
~CLKREQ1: R4.1, X1.102 (PCIECLK_REQ4#)
~PLTRST: X1.105 (PLTRST#)
~PWRBTN: X1.1 (PWRBTN#)
~WAKE: X1.103 (WAKE#)

Notes on the sheet:
DDI/TCP functions are defined by the BIOS source code. Cannot be changed in the BIOS settings. The functions for this design are defined as follows: - DDIA: eDP 1.4b (Not Used) - DDIB: HDMI 2.0 - TCP0: Display Port 1.4 - TCP1: USB Type-C (Not Used)
HPD pin of unused DDI/TCP port needs to be pulled down
The USB functions for this design are as follows: - USB2_P1: Rear USB3.2 - USB2_P2: Rear USB3.2 - USB2_P3: Front USB2.0 - USB2_P4: Front USB2.0 - USB2_P5: Front USB2.0 - USB2_P7: Front USB2.0 - USB2_P8: M.2 Wifi - USB2_P6: Not Used
Mini Mu has no second BIOS ROM ~{BIOS_SEL} pull up to 3.3V to select ROM on LattePanda Mu
HSIO functions are defined by the BIOS source code. Cannot be changed in the BIOS settings. The functions for this design are defined as follows: - HSIO0: USB3.2 10Gbps - HSIO1: USB3.2 10Gbps - HSIO2: PCIe 3.0 x1 (2.5Gb Ethernet) - HSIO3: PCIe 3.0 x1 (Not Used) - HSIO8: PCIe 3.0 x4 (M.2 SSD Lane 3)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
~{CLKREQ} is reserved for PCIe ASPM L1s Unless the device clearly supports it, pull it down to enhance compatibility
