DiodeDrop/MiniMu/MiniMu_V1.2_(NextPCB)/M2_SSD.kicad_sch

## KiCad design MiniMu_V1.2_(NextPCB)/M2_SSD.kicad_sch (2025-07-30)

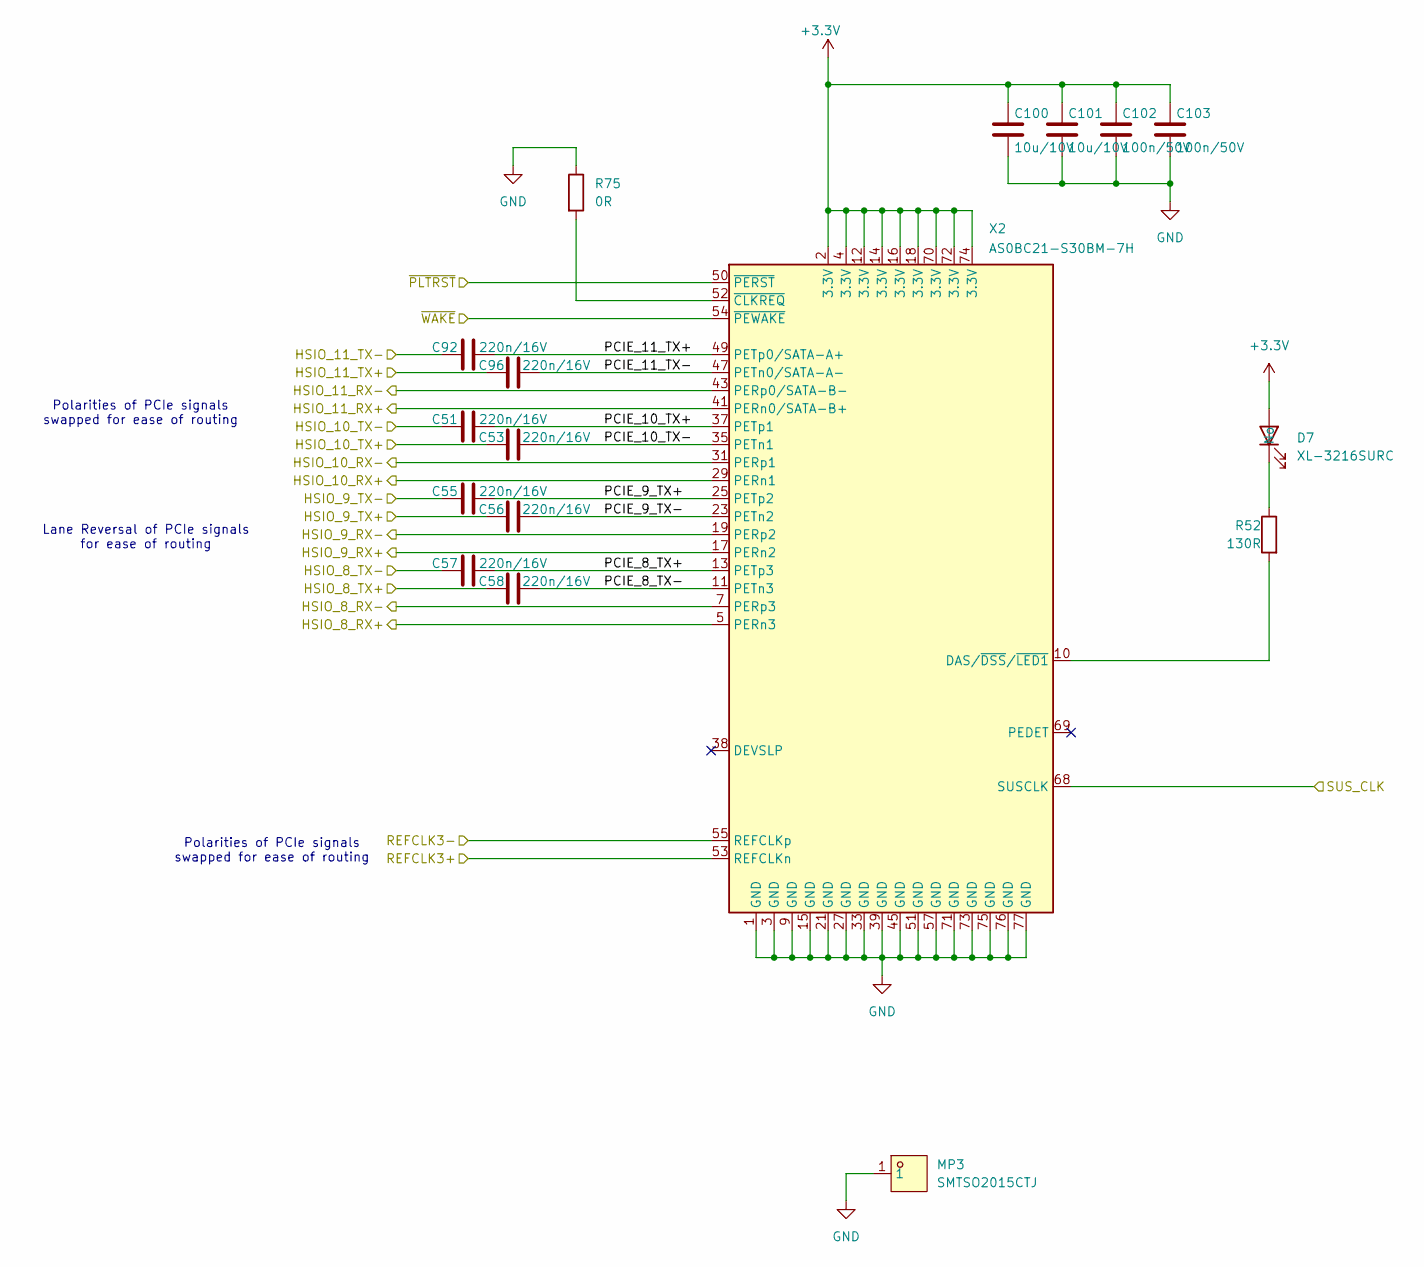
[picture p34: schematic M2_SSD.kicad_sch]

Parts:
C51, C53, C55, C56, C57, C58, C92, C96: 220n/16V; C_0402_1005Metric; LCSC Part C152777
C100, C101: 10u/10V; C_0603_1608Metric; LCSC Part C19702
C102, C103: 100n/50V; C_0603_1608Metric; LCSC Part C282519
D7: XL-3216SURC; LED_1206_3216Metric; MPN XL-3216SURC; LCSC Part C965822
MP3: SMTSO2015CTJ; MountingHole_3.7mm_Pad_TopOnly; MPN SMTSO2015CTJ; LCSC Part C2916320
R52: 130R; R_0603_1608Metric; MPN 0603WAF1300T5E; LCSC Part C22796
R75: 0R; R_0603_1608Metric; MPN 0603WAF0000T5E; LCSC Part C21189
X2: AS0BC21-S30BM-7H; CONN-SMD_AS0BC21-S30BM-7H; MPN AS0BC21-S30BM-7H; LCSC Part C2832351

Connections:
+3.3V: C100.1, C101.1, C102.1, C103.1, D7.2 (A), X2.2 (3.3V), X2.4 (3.3V), X2.12 (3.3V), X2.14 (3.3V), X2.16 (3.3V), X2.18 (3.3V), X2.70 (3.3V), X2.72 (3.3V), X2.74 (3.3V)
GND: C100.2, C101.2, C102.2, C103.2, MP3.1, R75.1, X2.1 (GND), X2.3 (GND), X2.9 (GND), X2.15 (GND), X2.21 (GND), X2.27 (GND), X2.33 (GND), X2.39 (GND), X2.45 (GND), X2.51 (GND), X2.57 (GND), X2.71 (GND), X2.73 (GND), X2.75 (GND), X2.76 (GND), X2.77 (GND)
HSIO_8_RX+: X2.5 (PERn3)
HSIO_8_RX-: X2.7 (PERp3)
HSIO_8_TX+: C58.1
HSIO_8_TX-: C57.1
HSIO_9_RX+: X2.17 (PERn2)
HSIO_9_RX-: X2.19 (PERp2)
HSIO_9_TX+: C56.1
HSIO_9_TX-: C55.1
HSIO_10_RX+: X2.29 (PERn1)
HSIO_10_RX-: X2.31 (PERp1)
HSIO_10_TX+: C53.1
HSIO_10_TX-: C51.1
HSIO_11_RX+: X2.41 (PERn0/SATA-B+)
HSIO_11_RX-: X2.43 (PERp0/SATA-B-)
HSIO_11_TX+: C96.1
HSIO_11_TX-: C92.1
unnamed: D7.1 (K), R52.1
unnamed: R52.2, X2.10 (DAS/~DSS/~LED1)
unnamed: R75.2, X2.52 (~CLKREQ)
PCIE_8_TX+: C57.2, X2.13 (PETp3)
PCIE_8_TX-: C58.2, X2.11 (PETn3)
PCIE_9_TX+: C55.2, X2.25 (PETp2)
PCIE_9_TX-: C56.2, X2.23 (PETn2)
PCIE_10_TX+: C51.2, X2.37 (PETp1)
PCIE_10_TX-: C53.2, X2.35 (PETn1)
PCIE_11_TX+: C92.2, X2.49 (PETp0/SATA-A+)
PCIE_11_TX-: C96.2, X2.47 (PETn0/SATA-A-)
REFCLK3+: X2.53 (REFCLKn)
REFCLK3-: X2.55 (REFCLKp)
SUS_CLK: X2.68 (SUSCLK)
~PLTRST: X2.50 (~PERST)
~WAKE: X2.54 (~PEWAKE)

Notes on the sheet:
Polarities of PCIe signals swapped for ease of routing
Lane Reversal of PCIe signals for ease of routing
