DiodeDrop/MiniMu/MiniMu_V1.2_(NextPCB)/M2_Wifi.kicad_sch

## KiCad design MiniMu_V1.2_(NextPCB)/M2_Wifi.kicad_sch (2025-07-30)

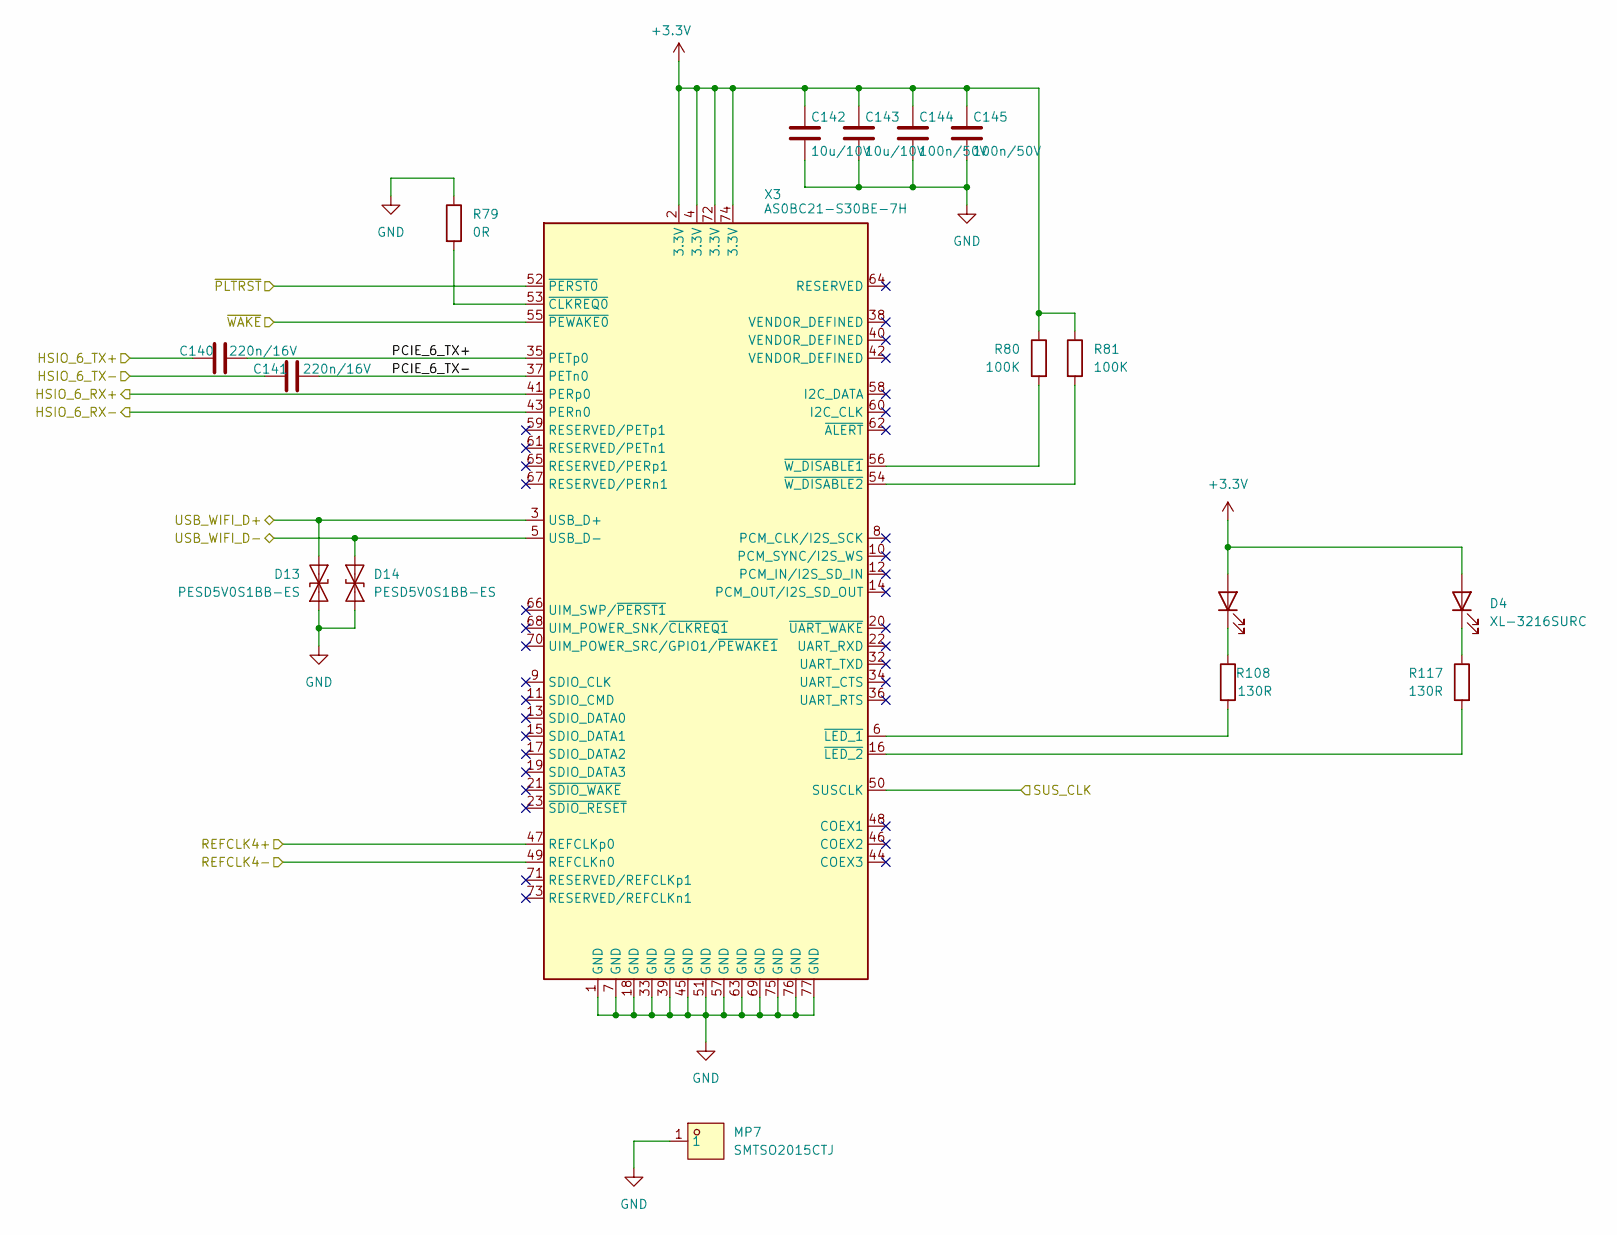
[picture p35: schematic M2_Wifi.kicad_sch]

Parts:
C140, C141: 220n/16V; C_0402_1005Metric; LCSC Part C152777
C142, C143: 10u/10V; C_0603_1608Metric; LCSC Part C19702
C144, C145: 100n/50V; C_0603_1608Metric; LCSC Part C282519
D4, D5: XL-3216SURC; LED_1206_3216Metric; MPN XL-3216SURC; LCSC Part C965822
D13, D14: PESD5V0S1BB-ES; D_SOD-523; MPN PESD5V0S1BB-ES; LCSC Part C5199184
MP7: SMTSO2015CTJ; MountingHole_3.7mm_Pad_TopOnly; MPN SMTSO2015CTJ; LCSC Part C2916320
R79: 0R; R_0603_1608Metric; MPN 0603WAF0000T5E; LCSC Part C21189
R80, R81: 100K; R_0603_1608Metric; MPN 0603WAF1003T5E; LCSC Part C25803
R108, R117: 130R; R_0603_1608Metric; MPN 0603WAF1300T5E; LCSC Part C22796
X3: AS0BC21-S30BE-7H; CONN-SMD_AS0BC21-S30BE-7H; MPN AS0BC21-S30BE-7H; LCSC Part C3020019

Connections:
+3.3V: C142.1, C143.1, C144.1, C145.1, D4.2 (A), D5.2 (A), R80.1, R81.1, X3.2 (3.3V), X3.4 (3.3V), X3.72 (3.3V), X3.74 (3.3V)
GND: C142.2, C143.2, C144.2, C145.2, D13.1 (A1), D14.1 (A1), MP7.1, R79.1, X3.1 (GND), X3.7 (GND), X3.18 (GND), X3.33 (GND), X3.39 (GND), X3.45 (GND), X3.51 (GND), X3.57 (GND), X3.63 (GND), X3.69 (GND), X3.75 (GND), X3.76 (GND), X3.77 (GND)
HSIO_6_RX+: X3.41 (PERp0)
HSIO_6_RX-: X3.43 (PERn0)
HSIO_6_TX+: C140.1
HSIO_6_TX-: C141.1
unnamed: D4.1 (K), R117.1
unnamed: D5.1 (K), R108.1
unnamed: R79.2, X3.53 (~CLKREQ0)
unnamed: R80.2, X3.56 (~W_DISABLE1)
unnamed: R81.2, X3.54 (~W_DISABLE2)
unnamed: R108.2, X3.6 (~LED_1)
unnamed: R117.2, X3.16 (~LED_2)
PCIE_6_TX+: C140.2, X3.35 (PETp0)
PCIE_6_TX-: C141.2, X3.37 (PETn0)
REFCLK4+: X3.47 (REFCLKp0)
REFCLK4-: X3.49 (REFCLKn0)
SUS_CLK: X3.50 (SUSCLK)
USB_WIFI_D+: D13.2 (A2), X3.3 (USB_D+)
USB_WIFI_D-: D14.2 (A2), X3.5 (USB_D-)
~PLTRST: X3.52 (~PERST0)
~WAKE: X3.55 (~PEWAKE0)
