DiodeDrop/MiniMu/MiniMu_V1.2_(NextPCB)/MiniMu_Next.kicad_sch

## KiCad design MiniMu_V1.2_(NextPCB)/MiniMu_Next.kicad_sch (2025-07-30)

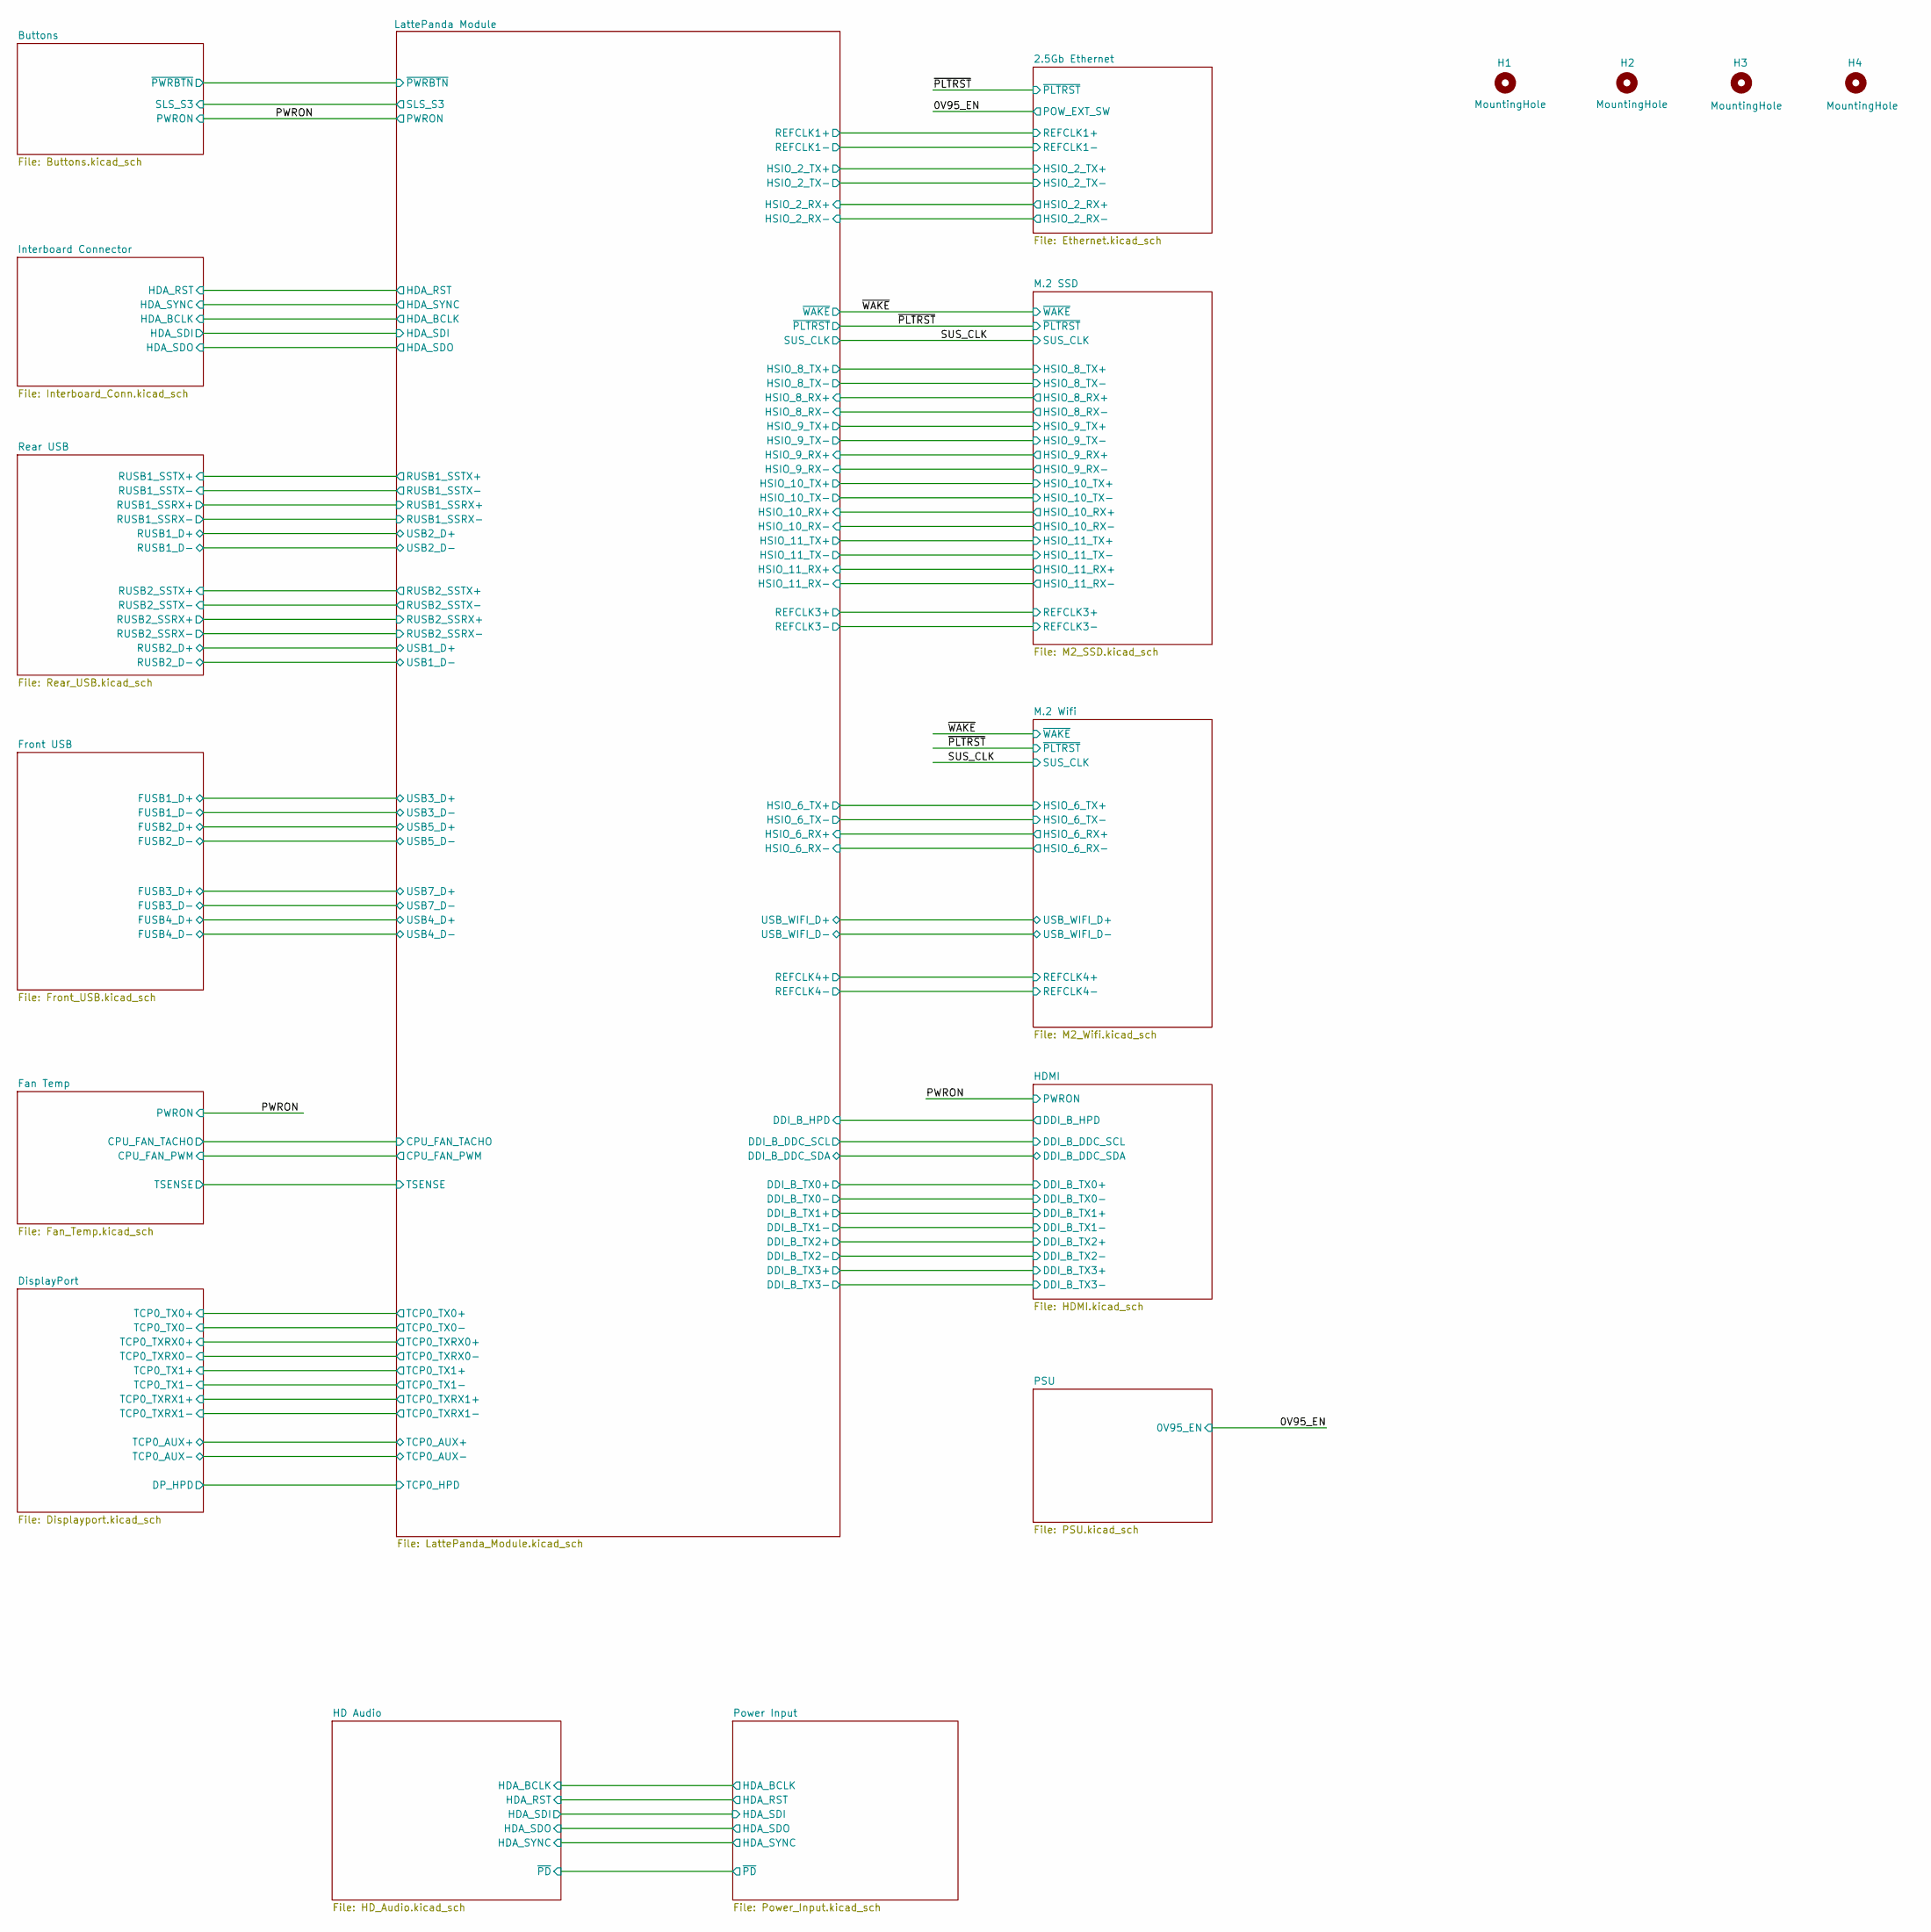
[picture p36: schematic MiniMu_Next.kicad_sch]

Parts:
H1, H2, H3, H4: MountingHole; MountingHole_2.5mm
