DiodeDrop/MiniMu/MiniMu_V1.2_(NextPCB)/PSU.kicad_sch

## KiCad design MiniMu_V1.2_(NextPCB)/PSU.kicad_sch (2025-07-30)

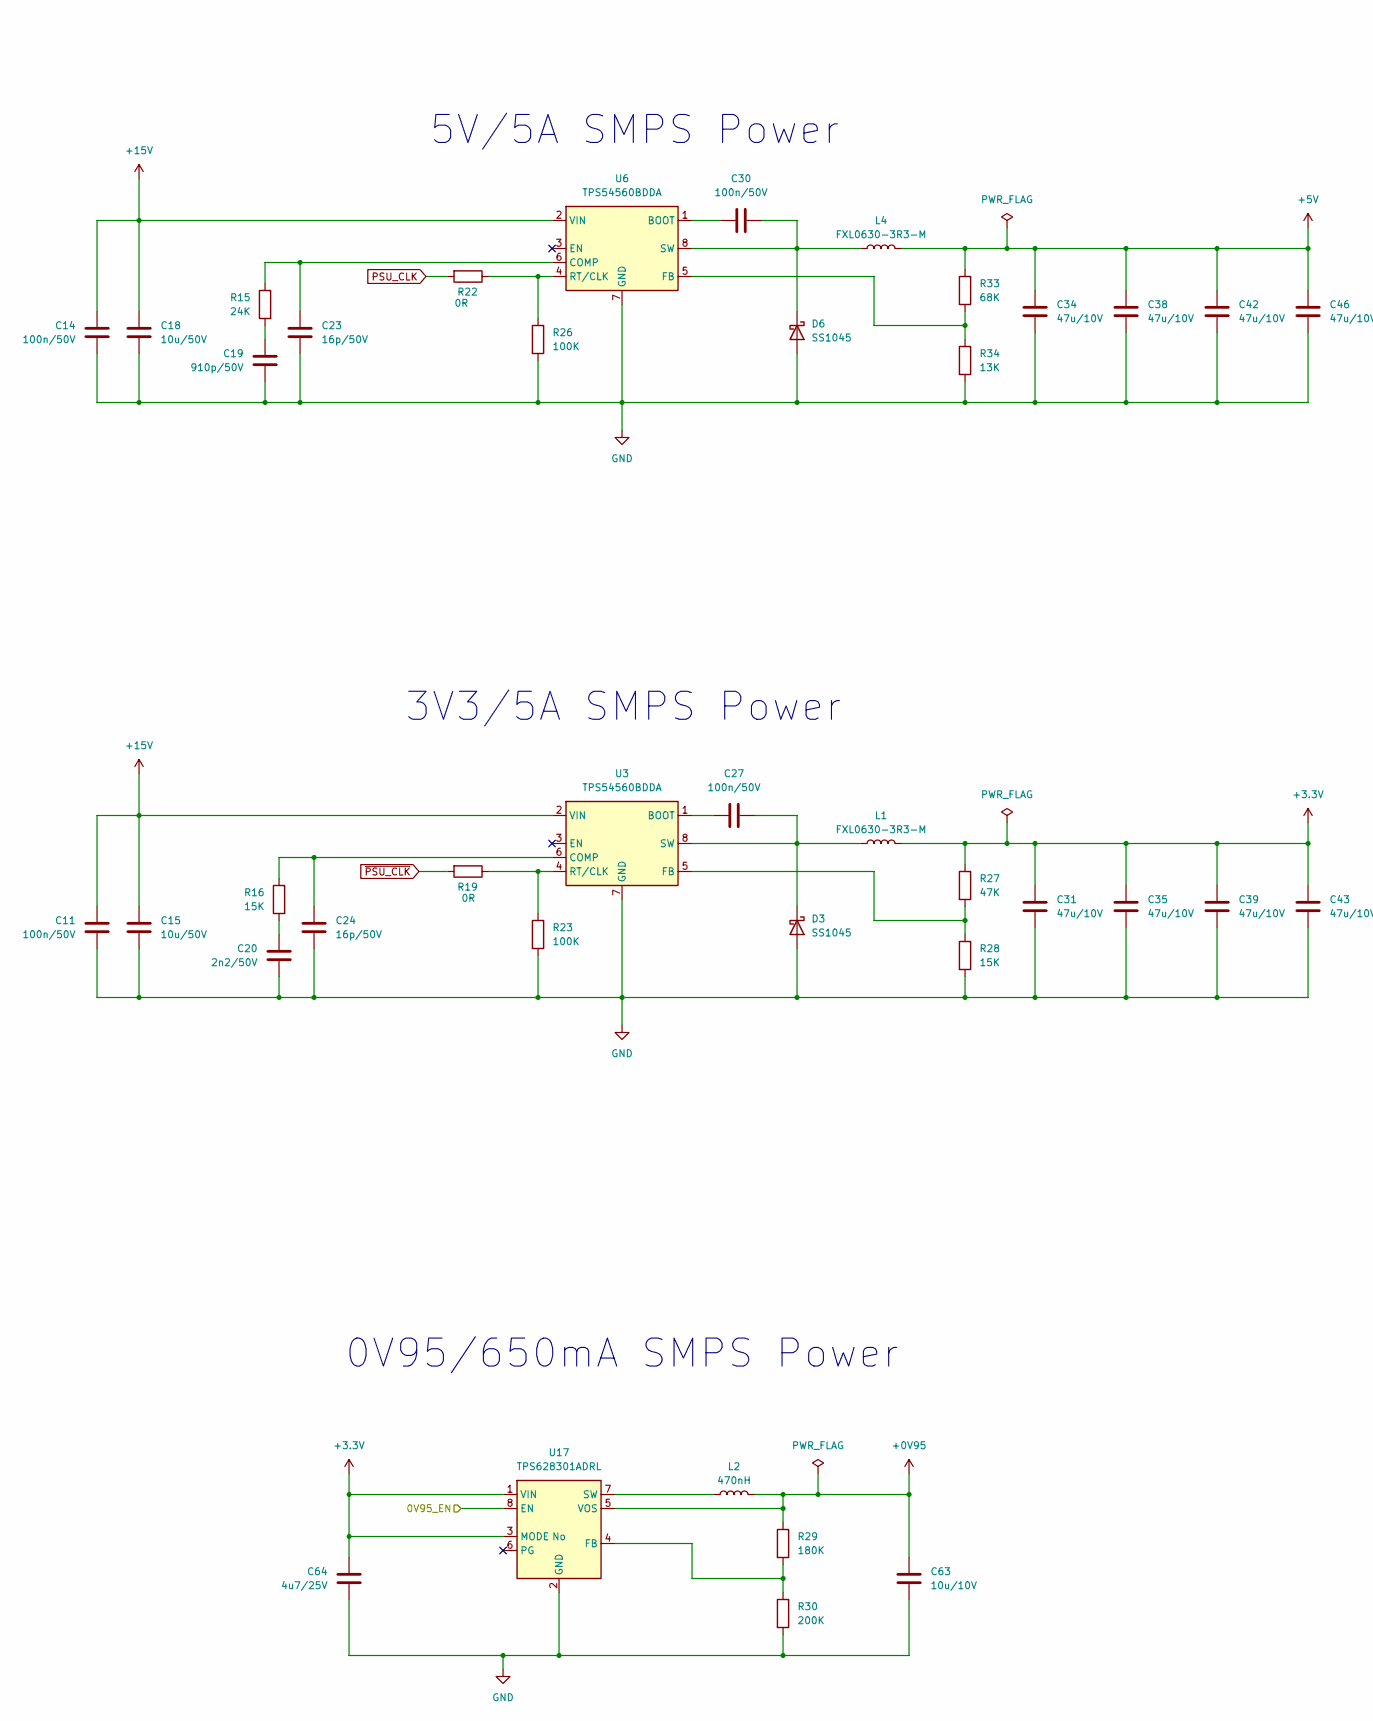
[picture p37: schematic PSU.kicad_sch, part in row 1, column 1]

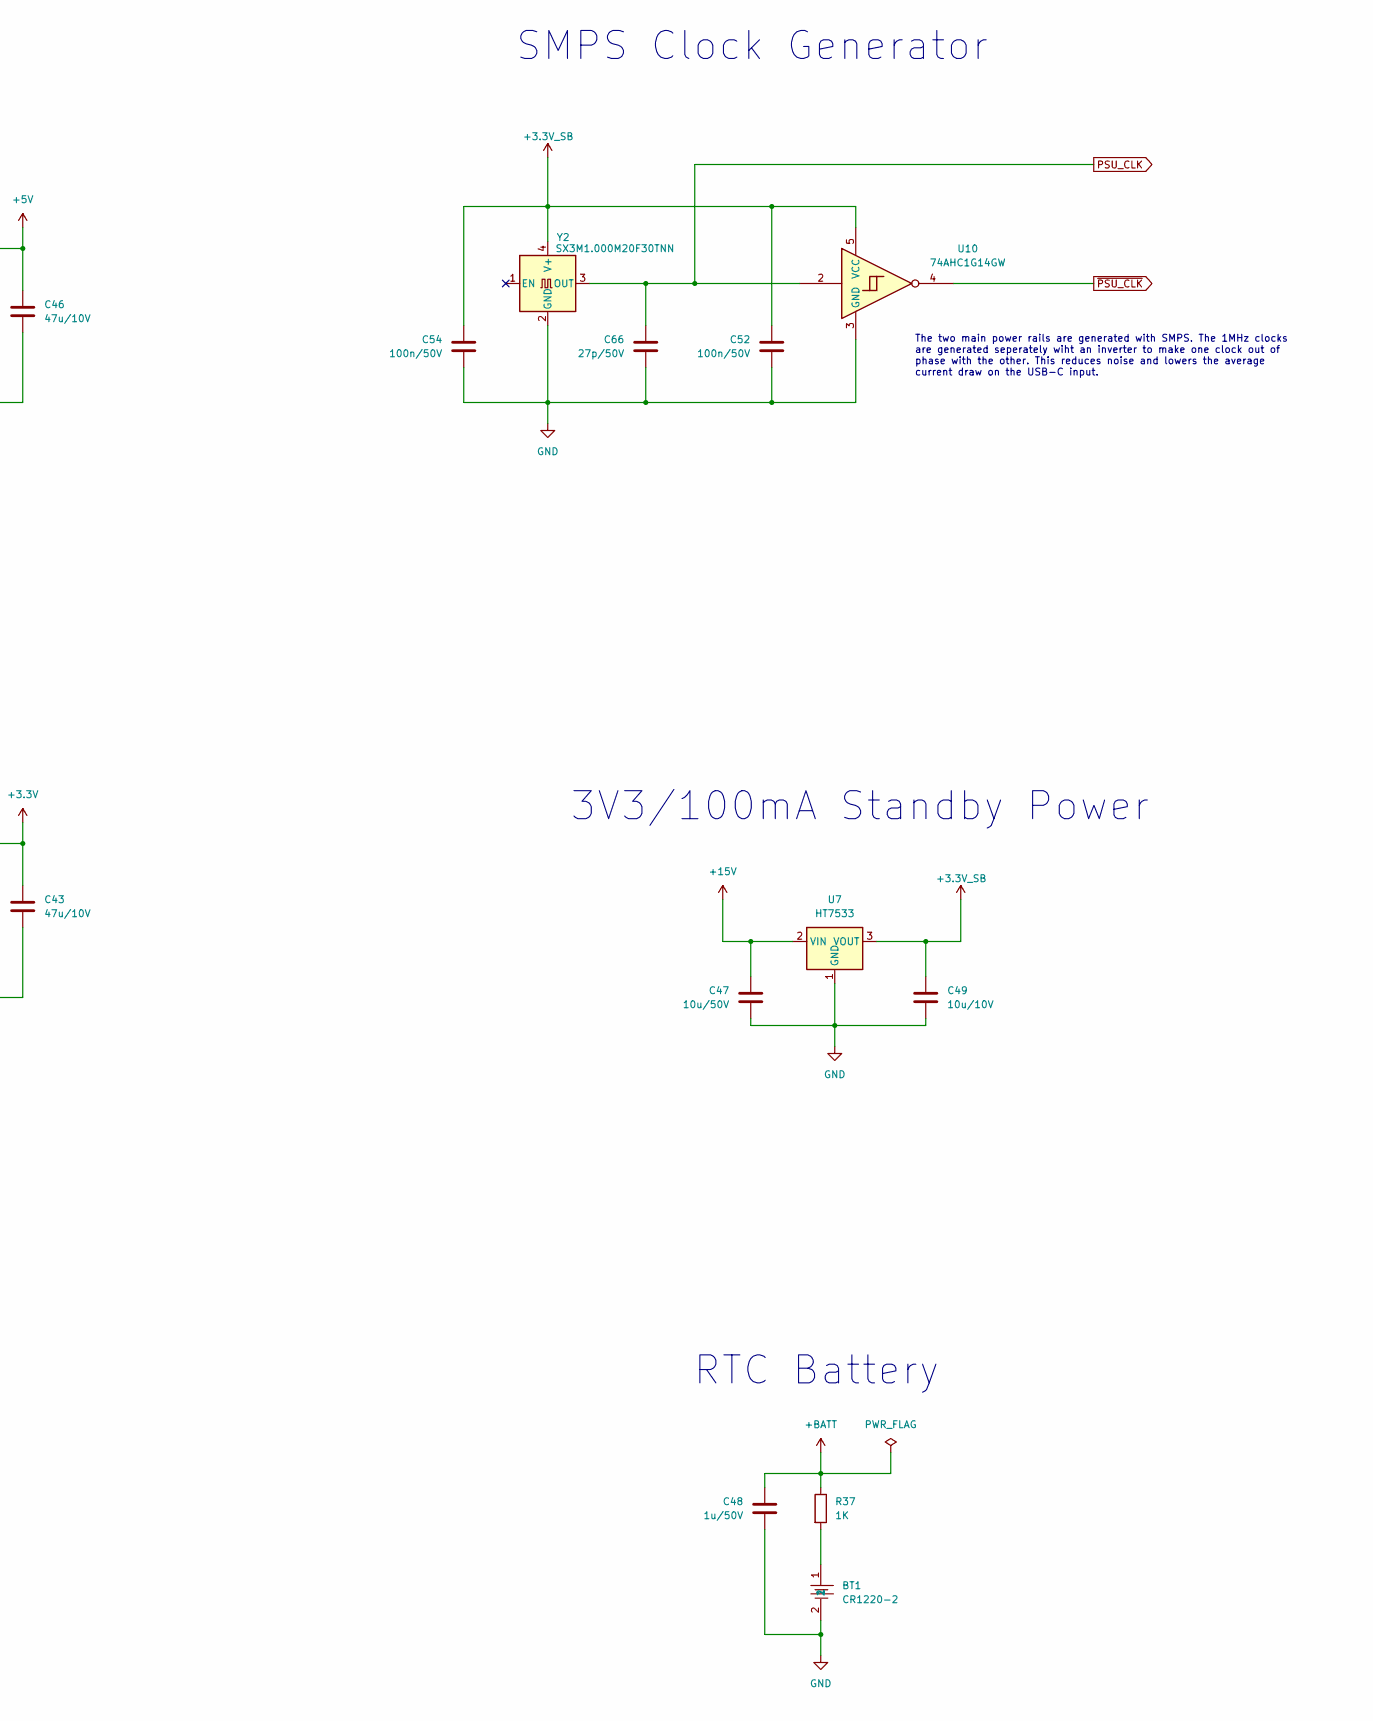
[picture p38: schematic PSU.kicad_sch, part in row 1, column 2]

Parts:
BT1: CR1220-2; BAT-SMD_CR1220-2; MPN CR1220-2; LCSC Part C70381
C11, C14, C27, C30, C52, C54: 100n/50V; C_0603_1608Metric; LCSC Part C282519
C15, C18, C47: 10u/50V; C_0805_2012Metric; LCSC Part C440198
C19: 910p/50V; C_0603_1608Metric; LCSC Part C3037659
C20: 2n2/50V; C_0603_1608Metric; LCSC Part C779970
C23, C24: 16p/50V; C_0603_1608Metric; LCSC Part C5360788
C31, C34, C35, C38, C39, C42, C43, C46: 47u/10V; C_1206_3216Metric; LCSC Part C5448950
C48: 1u/50V; C_0603_1608Metric; LCSC Part C157684
C49, C63: 10u/10V; C_0603_1608Metric; LCSC Part C19702
C64: 4u7/25V; C_0603_1608Metric; LCSC Part C20539423
C66: 27p/50V; C_0603_1608Metric; LCSC Part C302064
D3, D6: SS1045; D_SMB; MPN SS1045; LCSC Part C19273147
L1, L4: FXL0630-3R3-M; L_Changjiang_FXL0630; MPN FXL0630-3R3-M; LCSC Part C167219
L2: 470nH; L_0603_1608Metric; MPN TFM160808ALC-R47MTAA; LCSC Part C695609
R15: 24K; R_0603_1608Metric; MPN 0603WAF2402T5E; LCSC Part C23352
R16, R28: 15K; R_0603_1608Metric; MPN 0603WAF1502T5E; LCSC Part C22809
R19, R22: 0R; R_0603_1608Metric; MPN 0603WAF0000T5E; LCSC Part C21189
R23, R26: 100K; R_0603_1608Metric; MPN 0603WAF1003T5E; LCSC Part C25803
R27: 47K; R_0603_1608Metric; MPN 0603WAF4702T5E; LCSC Part C25819
R29: 180K; R_0603_1608Metric; MPN 0603WAF2003T5E; LCSC Part C22827
R30: 200K; R_0603_1608Metric; MPN 0603WAF2003T5E; LCSC Part C25811
R33: 68K; R_0603_1608Metric; MPN 0603WAF6802T5E; LCSC Part C23231
R34: 13K; R_0603_1608Metric; MPN 0603WAF1302T5E; LCSC Part C22797
R37: 1K; R_0603_1608Metric; MPN 0603WAF1001T5E; LCSC Part C21190
U3, U6: TPS54560BDDA; Texas_R-PDSO-G8_EP2.95x4.9mm_Mask2.4x3.1mm; MPN TPS54560BDDA; LCSC Part C1850354
U7: HT7533; SOT-89-3; MPN HT7533; LCSC Part C5296738
U10: 74AHC1G14GW; SOT-353_SC-70-5; MPN 74AHC1G14GW; LCSC Part C19829643
U17: TPS628301ADRL; SOT-583-8; MPN TPS628301ADRL; LCSC Part C22445517
Y2: SX3M1.000M20F30TNN; Oscillator_SMD_EuroQuartz_XO32-4Pin_3.2x2.5mm; MPN SX3M1.000M20F30TNN; LCSC Part C2901547

Connections:
0V95_EN: U17.8 (EN)
+0V95: C63.1, L2.2, R29.1, U17.5 (VOS)
+3.3V: C31.1, C35.1, C39.1, C43.1, C64.1, L1.2, R27.1, U17.1 (VIN), U17.3 (MODE)
+3.3V_SB: C49.1, C52.1, C54.1, U7.3 (VOUT), U10.5 (VCC), Y2.4 (V+)
+5V: C34.1, C38.1, C42.1, C46.1, L4.2, R33.1
+15V: C11.1, C14.1, C15.1, C18.1, C47.1, U3.2 (VIN), U6.2 (VIN), U7.2 (VIN)
+BATT: C48.1, R37.1
GND: BT1.2, C11.2, C14.2, C15.2, C18.2, C19.2, C20.2, C23.2, C24.2, C31.2, C34.2, C35.2, C38.2, C39.2, C42.2, C43.2, C46.2, C47.2, C48.2, C49.2, C52.2, C54.2, C63.2, C64.2, C66.2, D3.2 (A), D6.2 (A), R23.2, R26.2, R28.2, R30.2, R34.2, U3.7 (GND), U3.9 (GND), U6.7 (GND), U6.9 (GND), U7.1 (GND), U10.3 (GND), U17.2 (GND), Y2.2 (GND)
unnamed: BT1.1, R37.2
unnamed: C19.1, R15.2
unnamed: C20.1, R16.2
unnamed: C23.1, R15.1, U6.6 (COMP)
unnamed: C24.1, R16.1, U3.6 (COMP)
unnamed: C27.1, U3.1 (BOOT)
unnamed: C27.2, D3.1 (K), L1.1, U3.8 (SW)
unnamed: C30.1, D6.1 (K), L4.1, U6.8 (SW)
unnamed: C30.2, U6.1 (BOOT)
unnamed: L2.1, U17.7 (SW)
unnamed: R19.1, R23.1, U3.4 (RT/CLK)
unnamed: R22.1, R26.1, U6.4 (RT/CLK)
unnamed: R27.2, R28.1, U3.5 (FB)
unnamed: R29.2, R30.1, U17.4 (FB)
unnamed: R33.2, R34.1, U6.5 (FB)
PSU_CLK: C66.1, R22.2, U10.2, Y2.3 (OUT)
~PSU_CLK: R19.2, U10.4

Notes on the sheet:
3V3/5A SMPS Power
SMPS Clock Generator
RTC Battery
0V95/650mA SMPS Power
5V/5A SMPS Power
The two main power rails are generated with SMPS. The 1MHz clocks are generated seperately wiht an inverter to make one clock out of phase with the other. This reduces noise and lowers the average current draw on the USB-C input.
3V3/100mA Standby Power
