DiodeDrop/MiniMu/MiniMu_V1.2_(NextPCB)/Power_Input.kicad_sch

## KiCad design MiniMu_V1.2_(NextPCB)/Power_Input.kicad_sch (2025-07-30)

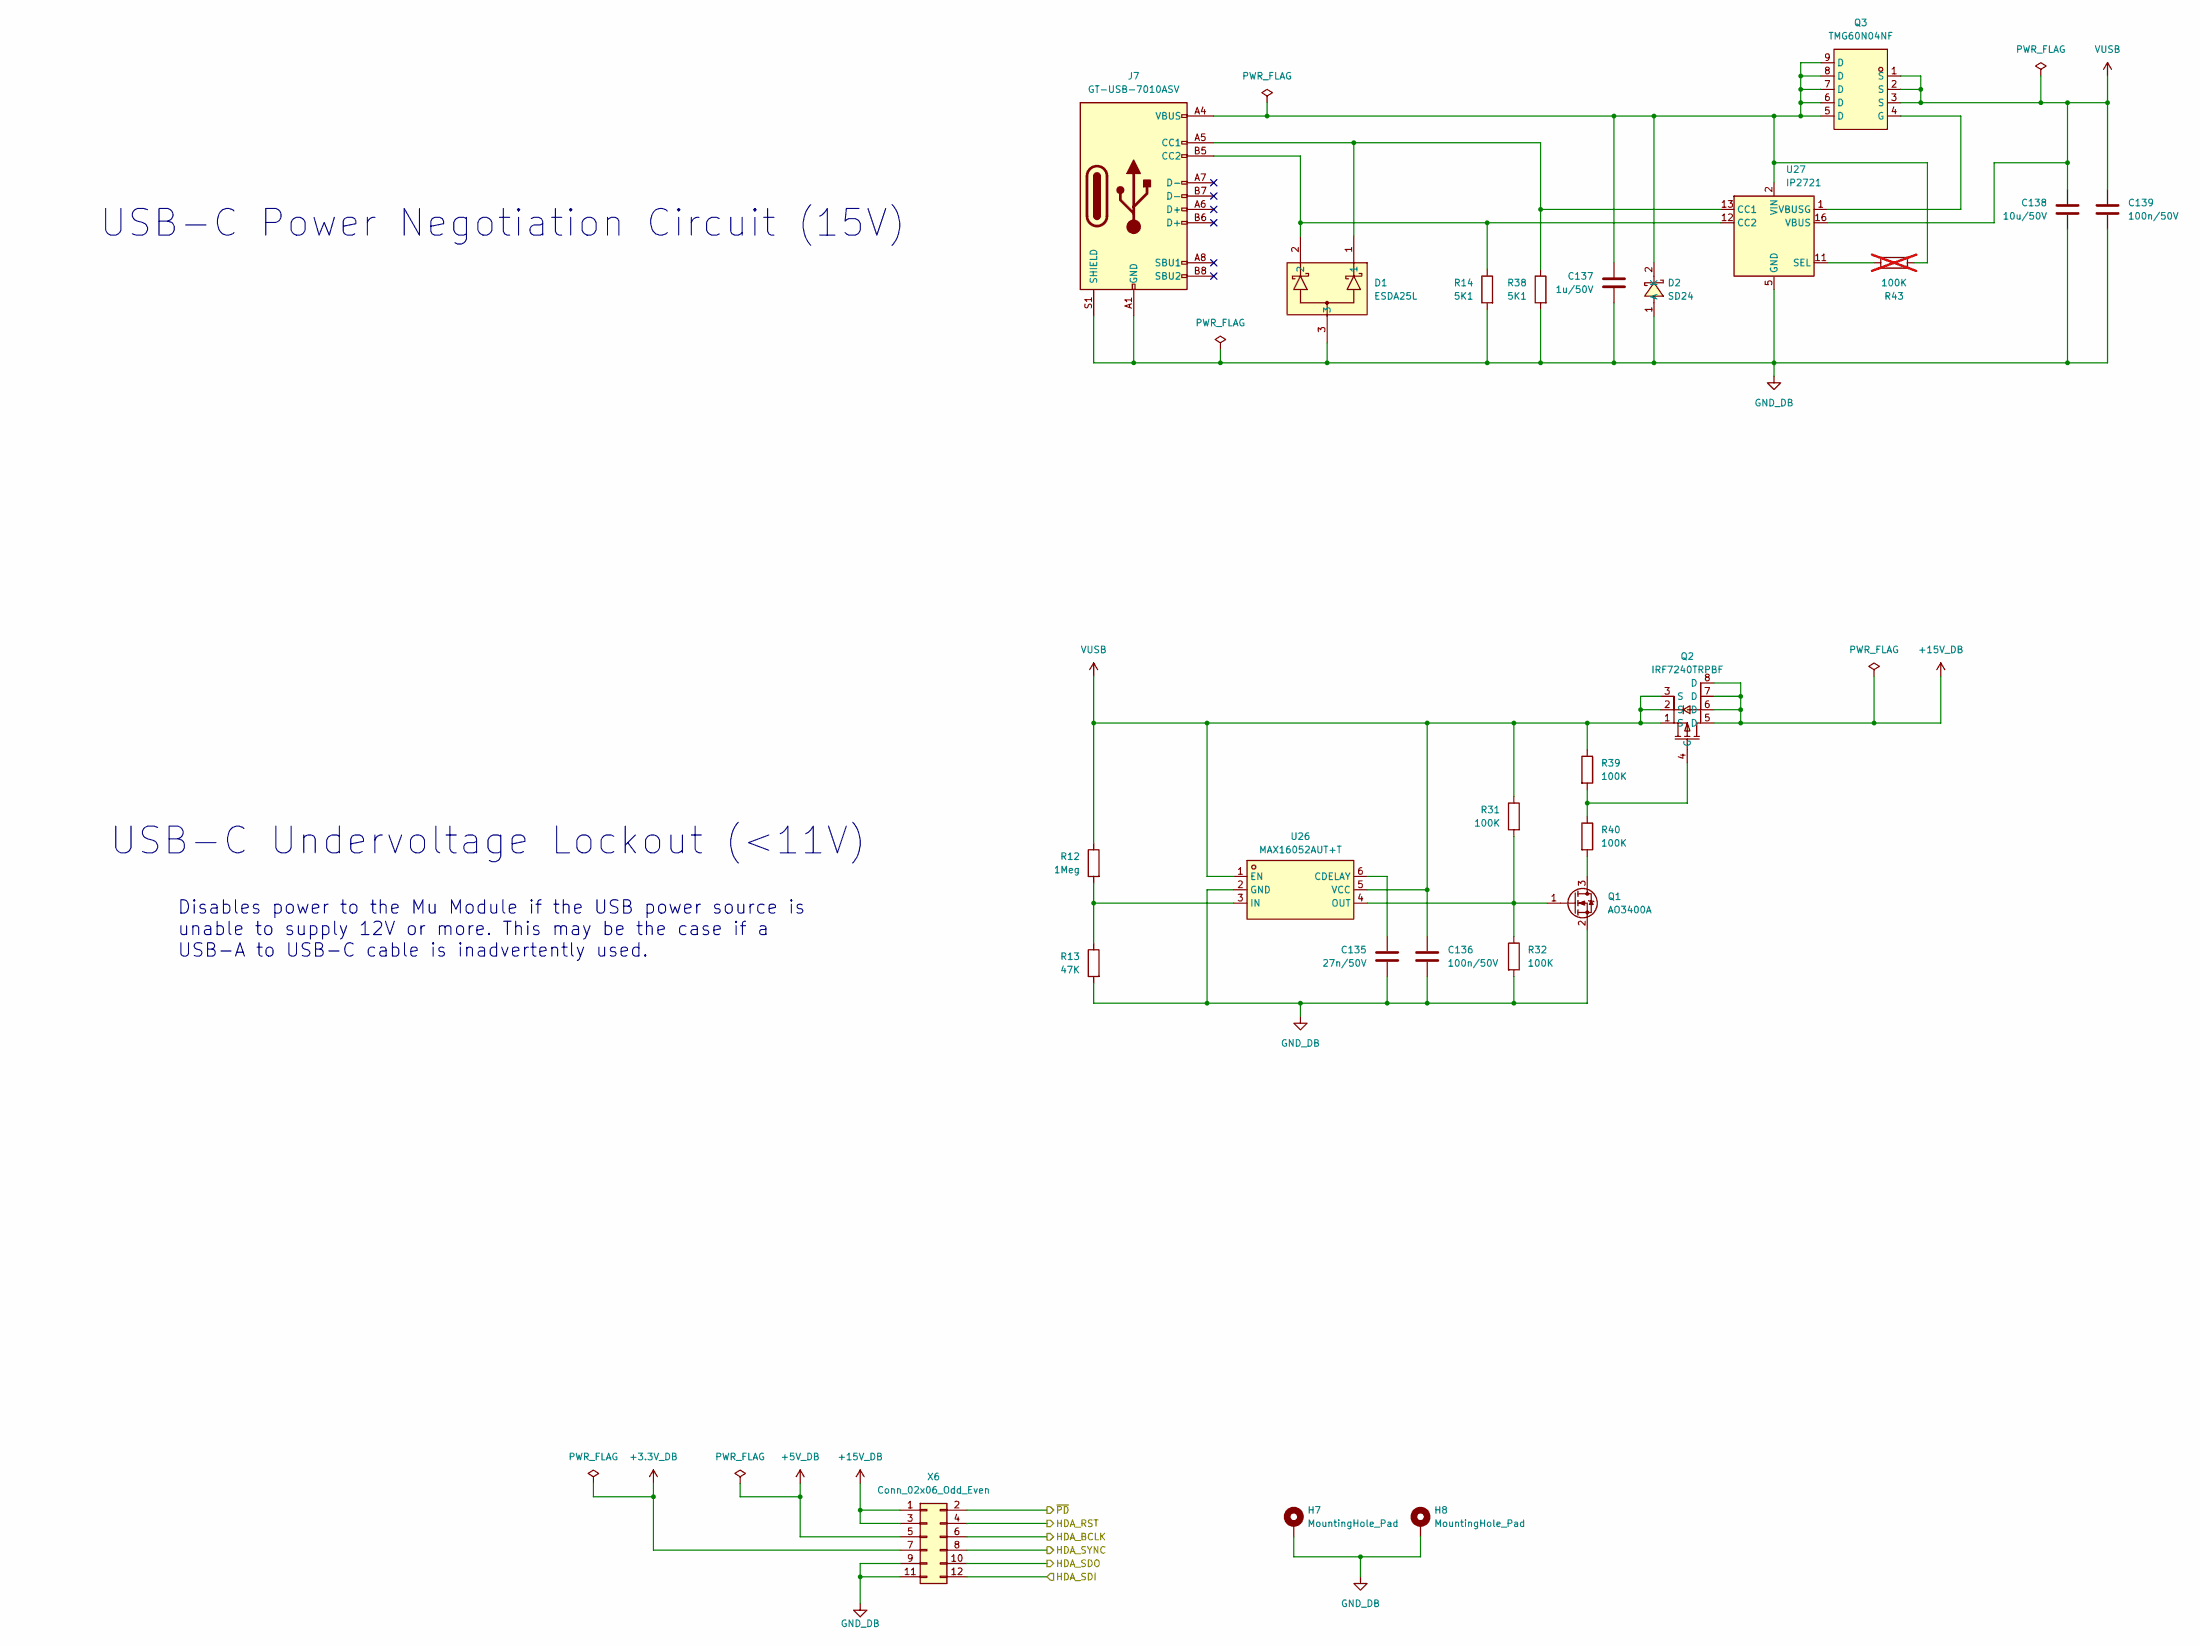
[picture p39: schematic Power_Input.kicad_sch]

Parts:
C135: 27n/50V; C_0603_1608Metric; LCSC Part C107086
C136, C139: 100n/50V; C_0603_1608Metric; LCSC Part C282519
C137: 1u/50V; C_0603_1608Metric; LCSC Part C157684
C138: 10u/50V; C_0805_2012Metric; LCSC Part C440198
D1: ESDA25L; SOT-23-3; MPN ESDA25L; LCSC Part C95343
D2: SD24; SOD-323_L1.8-W1.3-LS2.6-FD; MPN SD24; LCSC Part C502530
H7, H8: MountingHole_Pad; MountingHole_2.2mm_M2_Pad_TopBottom
J7: GT-USB-7010ASV; USB_C_Receptacle_G-Switch_GT-USB-7010ASV; MPN GT-USB-7010ASV; LCSC Part C2988369
Q1: AO3400A; SOT-23; MPN AO3400A; LCSC Part C5380685
Q2: IRF7240TRPBF; SOIC-8_3.9x4.9mm_P1.27mm; MPN IRF7240TRPBF; LCSC Part C18190856
Q3: TMG60N04NF; PDFN-8_L5.8-W4.9-P1.27-LS6.1-BL-A; MPN TMG60N04NF; LCSC Part C7422899
R12: 1Meg; R_0603_1608Metric; MPN 0603WAF1004T5E; LCSC Part C22935
R13: 47K; R_0603_1608Metric; MPN 0603WAF4702T5E; LCSC Part C25819
R14, R38: 5K1; R_0603_1608Metric; MPN 0603WAF5101T5E; LCSC Part C23186
R31, R32, R39, R40: 100K; R_0603_1608Metric; MPN 0603WAF1003T5E; LCSC Part C25803
R43: 100K; R_0603_1608Metric; MPN 0603WAF1003T5E; LCSC Part C25803; not fitted
U26: MAX16052AUT+T; TSOT-23-6; MPN MAX16052AUT+T; LCSC Part C143366
U27: IP2721; TSSOP-16_4.4x5mm_P0.65mm; MPN IP2721; LCSC Part C603176
X6: Conn_02x06_Odd_Even; PinSocket_2x06_P2.54mm_Vertical_SMD; MPN HC-PM254-8.5H-2x6PS; LCSC Part C22373947

Connections:
+3.3V_DB: X6.7
+5V_DB: X6.5
+15V_DB: Q2.5 (D), Q2.6 (D), Q2.7 (D), Q2.8 (D), X6.1, X6.3
GND_DB: C135.2, C136.2, C137.2, C138.2, C139.2, D1.3, D2.1 (A), H7.1, H8.1, J7.A1 (GND), J7.A12 (GND), J7.B1 (GND), J7.B12 (GND), J7.S1 (SHIELD), Q1.2 (S), R13.2, R14.2, R32.2, R38.2, U26.2 (GND), U27.5 (GND), X6.9, X6.11
HDA_BCLK: X6.6
HDA_RST: X6.4
HDA_SDI: X6.12
HDA_SDO: X6.10
HDA_SYNC: X6.8
unnamed: C135.1, U26.6 (CDELAY)
unnamed: C137.1, D2.2 (K), J7.A4 (VBUS), J7.A9 (VBUS), J7.B4 (VBUS), J7.B9 (VBUS), Q3.5 (D), Q3.6 (D), Q3.7 (D), Q3.8 (D), Q3.9 (D), R43.2, U27.2 (VIN)
unnamed: D1.1, J7.A5 (CC1), R38.1, U27.13 (CC1)
unnamed: D1.2, J7.B5 (CC2), R14.1, U27.12 (CC2)
unnamed: Q1.1 (G), R31.2, R32.1, U26.4 (OUT)
unnamed: Q1.3 (D), R40.2
unnamed: Q2.4 (G), R39.2, R40.1
unnamed: Q3.4 (G), U27.1 (VBUSG)
unnamed: R12.2, R13.1, U26.3 (IN)
unnamed: R43.1, U27.11 (SEL)
VUSB: C136.1, C138.1, C139.1, Q2.1 (S), Q2.2 (S), Q2.3 (S), Q3.1 (S), Q3.2 (S), Q3.3 (S), R12.1, R31.1, R39.1, U26.1 (EN), U26.5 (VCC), U27.16 (VBUS)
~PD: X6.2

Notes on the sheet:
USB-C Undervoltage Lockout (<11V)
USB-C Power Negotiation Circuit (15V)
Disables power to the Mu Module if the USB power source is unable to supply 12V or more. This may be the case if a USB-A to USB-C cable is inadvertently used.
