DiodeDrop/MiniMu/MiniMu_V1.2_(NextPCB)/Rear_USB.kicad_sch

## KiCad design MiniMu_V1.2_(NextPCB)/Rear_USB.kicad_sch (2025-07-30)

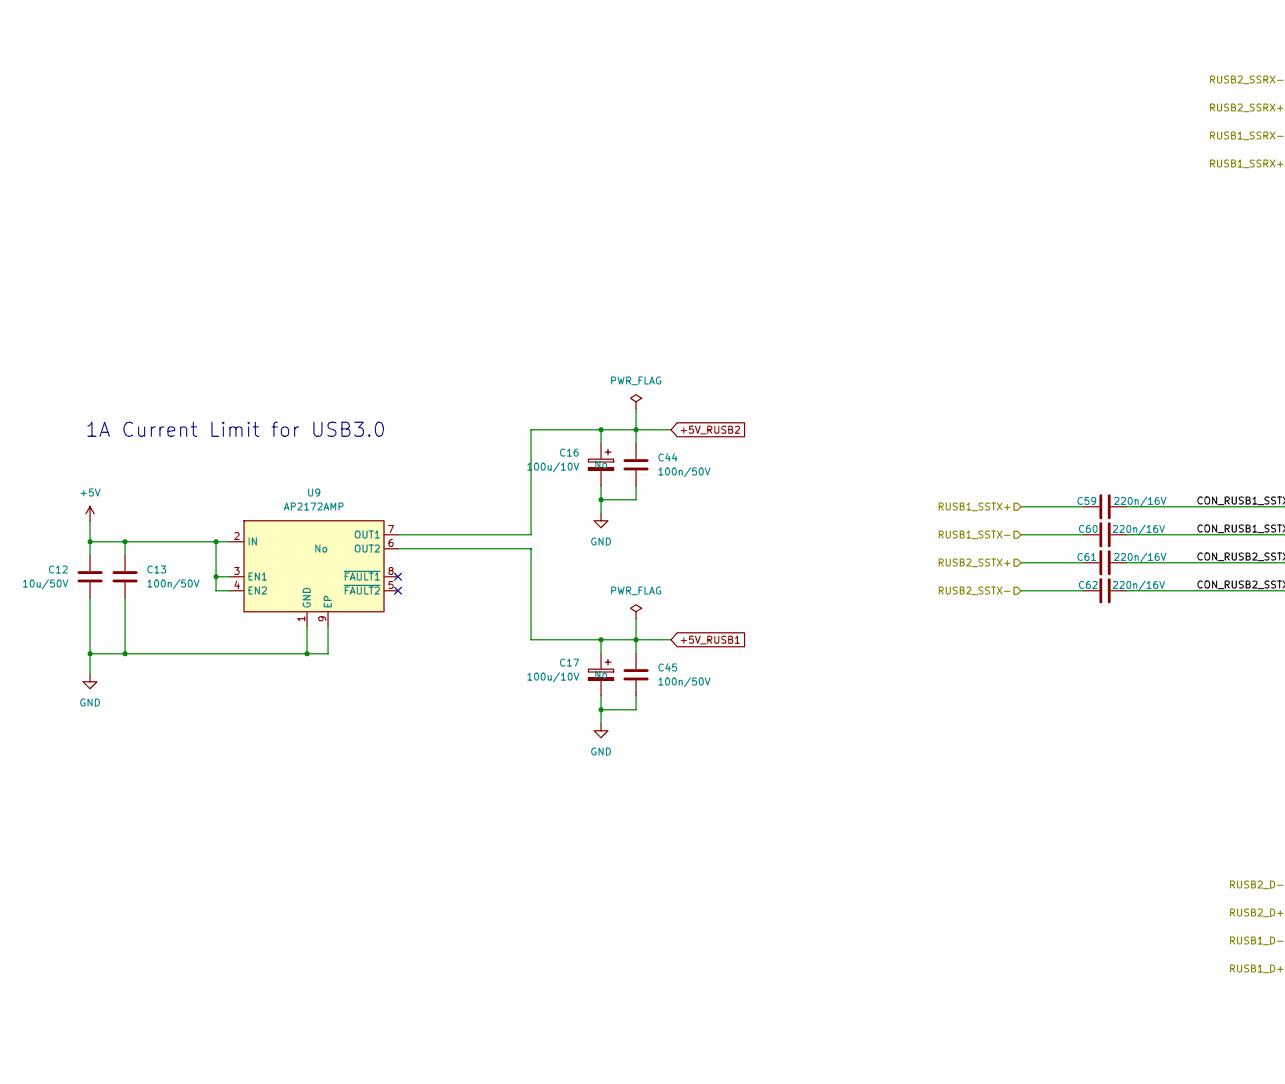
[picture p40: schematic Rear_USB.kicad_sch, part in row 1, column 1]

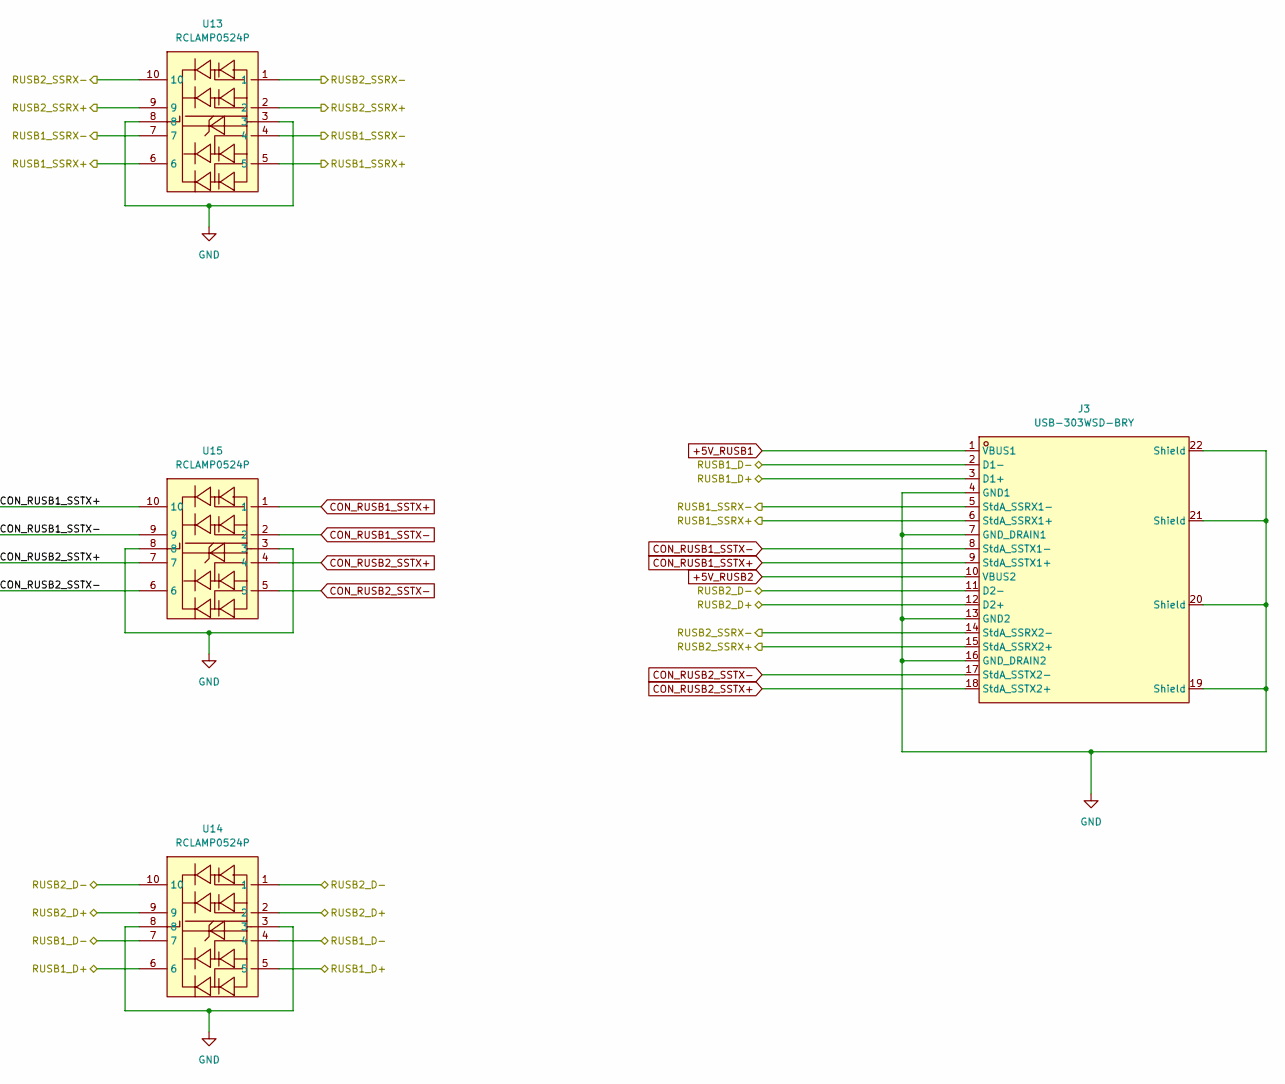
[picture p41: schematic Rear_USB.kicad_sch, part in row 1, column 2]

Parts:
C12: 10u/50V; C_0805_2012Metric; LCSC Part C440198
C13, C44, C45: 100n/50V; C_0603_1608Metric; LCSC Part C282519
C16, C17: 100u/10V; CP_EIA-3216-18_Kemet-A; LCSC Part C313517
C59, C60, C61, C62: 220n/16V; C_0402_1005Metric; LCSC Part C152777
J3: USB-303WSD-BRY; USB-A-TH_XUNPU_USB-303WSD-BRY; MPN USB-303WSD-BRY; LCSC Part C2895028
U9: AP2172AMP; MSOP-8-1EP_3x3mm_P0.65mm_EP1.95x2.15mm; MPN AP2172AMP; LCSC Part C460656
U13, U14, U15: RCLAMP0524P; MPN RCLAMP0524P; LCSC Part C19829566

Connections:
+5V: C12.1, C13.1, U9.2 (IN), U9.3 (EN1), U9.4 (EN2)
+5V_RUSB1: C17.1, C45.1, J3.1 (VBUS1), U9.6 (OUT2)
+5V_RUSB2: C16.1, C44.1, J3.10 (VBUS2), U9.7 (OUT1)
CON_RUSB1_SSTX+: C59.2, J3.9 (StdA_SSTX1+), U15.1, U15.10
CON_RUSB1_SSTX-: C60.2, J3.8 (StdA_SSTX1-), U15.2, U15.9
CON_RUSB2_SSTX+: C61.2, J3.18 (StdA_SSTX2+), U15.4, U15.7
CON_RUSB2_SSTX-: C62.2, J3.17 (StdA_SSTX2-), U15.5, U15.6
GND: C12.2, C13.2, C16.2, C17.2, C44.2, C45.2, J3.4 (GND1), J3.7 (GND_DRAIN1), J3.13 (GND2), J3.16 (GND_DRAIN2), J3.19 (Shield), J3.20 (Shield), J3.21 (Shield), J3.22 (Shield), U9.1 (GND), U9.9 (EP), U13.3, U13.8, U14.3, U14.8, U15.3, U15.8
RUSB1_D+: J3.3 (D1+), U14.5, U14.6
RUSB1_D-: J3.2 (D1-), U14.4, U14.7
RUSB1_SSRX+: J3.6 (StdA_SSRX1+), U13.5, U13.6
RUSB1_SSRX-: J3.5 (StdA_SSRX1-), U13.4, U13.7
RUSB1_SSTX+: C59.1
RUSB1_SSTX-: C60.1
RUSB2_D+: J3.12 (D2+), U14.2, U14.9
RUSB2_D-: J3.11 (D2-), U14.1, U14.10
RUSB2_SSRX+: J3.15 (StdA_SSRX2+), U13.2, U13.9
RUSB2_SSRX-: J3.14 (StdA_SSRX2-), U13.1, U13.10
RUSB2_SSTX+: C61.1
RUSB2_SSTX-: C62.1

Notes on the sheet:
1A Current Limit for USB3.0
